karawin/Ka-Radio/ESP8266-Firmware/documents/karadiov365.jpg

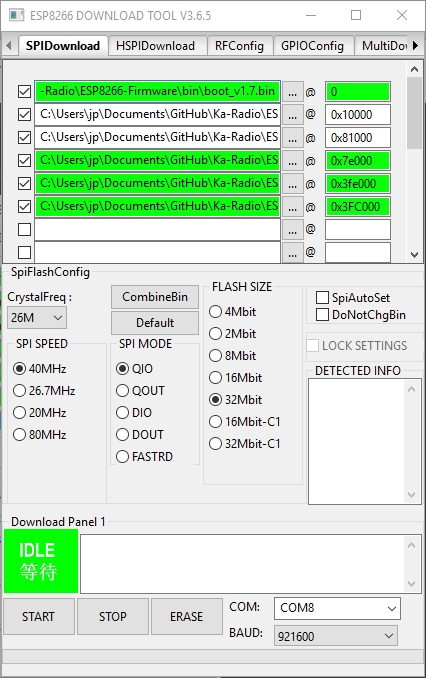
ESP8266-Firmware/documents/karadiov365.jpg
