karawin/Ka-Radio/ESP8266-Firmware/documents/screenshot_20161106_193554.png

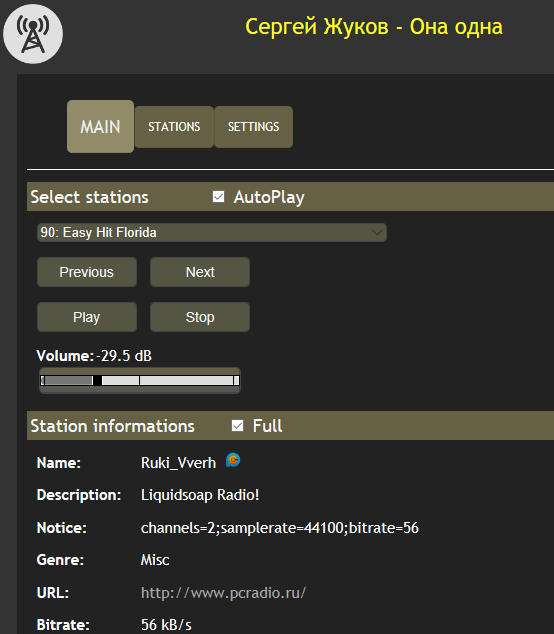
ESP8266-Firmware/documents/screenshot_20161106_193554.png
