karawin/Ka-Radio/(threads)

Thread 1 (2016-06-23):

auto resume

zajaklis, 2016-06-23:
At fist i wanted to thank you for you hard work and time spent on this project.

This not an issue, but more like feature request.
It would be nice that device on startup starts automatically playing radio station which was running before shutdown.
At fist i thought that its configurable on webui with "AutoPlay" checkbox, but it did not do anything.
What AutoPlay checkbox does?

karawin, 2016-06-23:
Hello,

Thanks,

Yes, the autoPlay is only after the first play button pressed. After
that, any other selection is launched automatically.
I forgot to launch the current station. I will work on it soon.

Regards

JP

Le 23/06/2016 à 07:44, zajaklis a écrit :
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

zajaklis, 2016-09-07:
hi again, did you implemented auto resume feature?
i have not notice that in changelog.

karawin, 2016-09-08:
Partially.
The problem is that the knowing is not in the esp but in the browser.
I have to add it on the esp eprom.... Soon.

Le 07/09/2016 à 21:22, zajaklis a écrit :
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

karawin, 2016-09-23:
autostart: test these bin....
I think it will works now.
thanks

Le 07/09/2016 à 21:22, zajaklis a écrit :
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

zajaklis, 2016-09-24:
which bins include autostart feature?

karawin, 2016-09-27:
Both.

Two bin, one for each bank.

Try just the 1.

Le 24/09/2016 à 15:19, zajaklis a écrit :
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

zajaklis, 2016-09-27:
took from http://karadio.karawin.fr/ and autoplay still not working after applying power.
Idea was to interact  with ka-radio without webui. At the moment after applying power im counting till 10 and pressing play button.

karawin, 2016-09-27:
Normal, it is not delivered, the bin was a preview .

Le 27/09/2016 à 17:21, zajaklis a écrit :
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

karawin, 2016-09-29:
The 1.0.9 is released and working ;-)

Le 27/09/2016 à 17:21, zajaklis a écrit :
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

zajaklis, 2016-10-01:
Great, just tested, all works!
Thank you

Closed 2016-07-29.

Thread 2 (2016-07-16):

cannot change IP

yo2ldk, 2016-07-16:
Hi,

  this is a very nice and well made it project, Thank you!
I do something wrong maybe, because when I try to put AP name, pswd , a new IP and gateway, this is not happening , it comes back on 192.168.4.1 and I have no connection to internet for ESP module.
on router I have ...1.1, try it also with original class ...8.1 and with ...0.1 , all the same.
I not have memory IC (until I get it),  but it work also without it, no? and when ESP have no power, I need to rewrite all settings in this case?
 sorry for all questions, but I am more on hardware and a beginner in codding .

karawin, 2016-07-16:
Hi

Firstly check if you have a 4Mb esp8266 (ie 32mbits)

Le 16/07/2016 à 06:55, alexander - yo2ldk a écrit :
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
May be a wrong AP or password?
Before all, make a "Clear stations" and after change the wifi setting:
No dhcp, an ip address in 192.168.1.x a mask of 255.255.255.0 and the ip
of your router.

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

Yes it works without the external ram.
Check for a 4MB esp8266 if the stations are not maintened, it may be the
problem.
If it is the wifi setting not maintened, it is because the internet AP
access is wrong.

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

yo2ldk, 2016-07-16:
Thank you for fast reply
 I try for 3 days already and no conclusion..
yes my esp board have 4Mb is wemos esp d1 mini, but I try also with NodeMcu v.3 the same thing
 firmware is well flashed ,router is ok, password all good but not connect
web interface it is and work ok, full level of wifi, connections is made it conf. pdf. file; i'm stuck...  :)

karawin, 2016-07-16:
Try the uart interface (documented in
\a-Radio\ESP8266-Firmware\documents\uartinterface.txt):

sys.erase
wifi.list
wifi.con("ssid","password")
wifi.status

Bye

JP

Le 16/07/2016 à 11:31, alexander - yo2ldk a écrit :
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

yo2ldk, 2016-07-16:
Merci beaucoup !

karawin, 2016-07-16:
Check also your power. It is very sensitive. A good external power
supply is needed.

Le 16/07/2016 à 11:31, alexander - yo2ldk a écrit :
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

yo2ldk, 2016-07-16:
I use power bank Xiaomi 16000 mA

karawin, 2016-07-16:
115200b/s ?
try http://www.compuphase.com/software_termite.htm
Press enter key, you must see
#INFO:""#

If not, the flash is not good.

yo2ldk, 2016-07-16:
sorry to bother you with my problem;
I use tera term, also realterm, now on termite when push enter nothing appear. all on 9600
testing also with 115200
web page look ok, I reflashing, last solutions here.

yo2ldk, 2016-07-16:
for sure i wrong somthing..
after reflashing two modules, with serial connection I have no response from any.  at all !
 I flash as follow:

boot_v1.5 at 0x00000
user1.4096.new.4.bin at 0x1000 ,
user2.4096.new.4.bin at 0X81000
blank.bin at 0x7e000
blank.bin at 0x3fe000

it is ok that?  because I don't know what to do more..

karawin, 2016-07-16:
The complete flash is
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

With what tool do you flash it?
Under windows or linux?
Do you have checked all wires? Try without the vs1053 in case of doubt.

karawin, 2016-07-29:
no news?

yo2ldk, 2016-07-29:
Jean-Pierre,
Thank you for all your help, especially latest, with photo !
 in the first time, I write firmware exactly like you except latest two file .
 Now i write all files, on four (4) different modules.
 on all when I try to access with terminal (5 different software) I get nothing or strange char.
not what should be.
I'm not so stupid, i load firmware in many and different equipment's but with that this is like I fell..
 so , I take a break, maybe in this weekend I made latest try, even if I need this Radio.
 my best regards,

                 alex.

karawin, 2016-07-29:
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

Closed 2016-07-29.

Thread 3 (2016-10-05):

Using an additional chip 23lcv1024 and external buttons?

lyovav, 2016-10-05:
Hello, what benefits provide the use of an additional chip 23lcv1024,
and whether there is support for external control buttons?
Thank you with best regards Vladimir.

karawin, 2016-10-05:
The additional chip increases the buffering of the played station in order to avoid silent gaps if the internet stream is not regular.  Recommended if you experiment too many gaps.

External controls: see https://github.com/karawin/Ka-Radio/blob/master/Hardware/KiCAD/controles/controles.pdf
The led is optional and must now be connected to GPIO2 instead of GPIO16.
Thanks for your interest.

Closed 2016-10-05.

Thread 4 (2016-10-06):

Bug selected stations  autoplay

lyovav, 2016-10-06:
Sometimes  when I chose the desired station, and I pressed the play - off the power and turned it back to station plays 1 second and stops playing

(off the power times with no web browser) testing on V1.0.9
```
=> extraram state: 0 0xff ▒▒▒▒▒▒▒▒▒▒▒▒▒▒▒▒
data  : 0x3ffe8000 ~ 0x3ffe88d4, len: 2260
rodata: 0x3ffe88e0 ~ 0x3ffea744, len: 7780
bss   : 0x3ffea748 ~ 0x3fff15b0, len: 28264
heap  : 0x3fff15b0 ~ 0x40000000, len: 59984
Heap size: 32200
t0 task: 3fff83e8
t1 task: 3fff8580
t4 task: 3fff89a8
t3 task: 3fff8fc8
t2 task: 3fff9cf0
mode : sta(5c:cf:7f:23:d6:53)
add if0
I2S Speed: 0
SCI_Mode (0x4800) = 0x802
SCI_Status (0x48) = 0x48
VS Version (VS1053 is 4) = 4
SCI_ClockF = 0x6000
UART READY TO READ
 Station Ip: 192.168.100.246
DHCP: 0x1
Device: Ip: 192.168.100.246

I: 0 status: 0

In I: 0 status: 1
scandone
state: 0 -> 2 (b0)
state: 2 -> 3 (0)

In I: 1 status: 1
state: 3 -> 5 (10)
add 0
aid 2
pm open phy_2,type:2 0 0
cnt

connected with 47501, channel 3
dhcp client start...
ip:192.168.100.246,mask:255.255.255.0,gw:192.168.100.1
autostart: playing:1, currentstation:2
I2S Speed: 0
##CLI.STOPPED#
##CLI.URLSET#: online-hitfm.tavrmedia.ua
##CLI.PATHSET#: /HitFM
##CLI.PORTSET#: 8000
##CLI.ICY0#: Hit FM
##CLI.ICY3#: http://www.hitfm.ua
##CLI.ICY4#: Only Hits!
##CLI.ICY5#: 128
##CLI.ICY6#: Only Hits!
##CLI.ICY7#:  ice-samplerate=44100;ice-bitrate=128;ice-channels=2
##CLI.PLAYING#
##CLI.STOPPED#

```
or

```
=> extraram state: 0 0xff ▒▒▒▒▒▒▒▒▒▒▒▒▒▒▒▒
data  : 0x3ffe8000 ~ 0x3ffe88d4, len: 2260
rodata: 0x3ffe88e0 ~ 0x3ffea744, len: 7780
bss   : 0x3ffea748 ~ 0x3fff15b0, len: 28264
heap  : 0x3fff15b0 ~ 0x40000000, len: 59984
Heap size: 32200
t0 task: 3fff83e8
t1 task: 3fff8580
t4 task: 3fff89a8
t3 task: 3fff8fc8
t2 task: 3fff9cf0
mode : sta(5c:cf:7f:23:d6:53)
add if0
I2S Speed: 0
SCI_Mode (0x4800) = 0x802
SCI_Status (0x48) = 0x48
VS Version (VS1053 is 4) = 4
SCI_ClockF = 0x6000
UART READY TO READ
 Station Ip: 192.168.100.246
DHCP: 0x1
Device: Ip: 192.168.100.246

I: 0 status: 0

In I: 0 status: 1
scandone
state: 0 -> 2 (b0)
state: 2 -> 3 (0)

In I: 1 status: 1
state: 3 -> 5 (10)
add 0
aid 2
pm open phy_2,type:2 0 0
cnt

connected with 47501, channel 3
dhcp client start...
ip:192.168.100.246,mask:255.255.255.0,gw:192.168.100.1
autostart: playing:1, currentstation:2
I2S Speed: 0
##CLI.STOPPED#
##CLI.URLSET#: online-hitfm.tavrmedia.ua
##CLI.PATHSET#: /HitFM
##CLI.PORTSET#: 8000
##CLI.ICY0#: Hit FM
##CLI.ICY3#: http://www.hitfm.ua
##CLI.ICY4#: Only Hits!
##CLI.ICY5#: 128
##CLI.ICY6#: Only Hits!
##CLI.ICY7#:  ice-samplerate=44100;ice-bitrate=128;ice-channels=2
##CLI.STOPPED#
```

In most cases operate normally Autoplay's

```
=> extraram state: 0 0xff ▒▒▒▒▒▒▒▒▒▒▒▒▒▒▒▒
data  : 0x3ffe8000 ~ 0x3ffe88d4, len: 2260
rodata: 0x3ffe88e0 ~ 0x3ffea744, len: 7780
bss   : 0x3ffea748 ~ 0x3fff15b0, len: 28264
heap  : 0x3fff15b0 ~ 0x40000000, len: 59984
Heap size: 32200
t0 task: 3fff83e8
t1 task: 3fff8580
t4 task: 3fff89a8
t3 task: 3fff8fc8
t2 task: 3fff9cf0
mode : sta(5c:cf:7f:23:d6:53)
add if0
I2S Speed: 0
SCI_Mode (0x4800) = 0x802
SCI_Status (0x48) = 0x48
VS Version (VS1053 is 4) = 4
SCI_ClockF = 0x6000
UART READY TO READ
 Station Ip: 192.168.100.246
DHCP: 0x1
Device: Ip: 192.168.100.246

I: 0 status: 0

In I: 0 status: 1
scandone
state: 0 -> 2 (b0)
state: 2 -> 3 (0)

In I: 1 status: 1
state: 3 -> 5 (10)
add 0
aid 2
pm open phy_2,type:2 0 0
cnt

connected with 47501, channel 3
dhcp client start...
ip:192.168.100.246,mask:255.255.255.0,gw:192.168.100.1
autostart: playing:1, currentstation:2
I2S Speed: 0
##CLI.STOPPED#
##CLI.URLSET#: online-hitfm.tavrmedia.ua
##CLI.PATHSET#: /HitFM
##CLI.PORTSET#: 8000
##CLI.ICY0#: Hit FM
##CLI.ICY3#: http://www.hitfm.ua
##CLI.ICY4#: Only Hits!
##CLI.ICY5#: 128
##CLI.ICY6#: Only Hits!
##CLI.ICY7#:  ice-samplerate=44100;ice-bitrate=128;ice-channels=2
##CLI.PLAYING#
##CLI.META#: Xiт FM - www.hitfm.ua

```
Thank you with best regards Vladimir.

karawin, 2016-10-06:
Interesting. I will investigate, thank you

Le 06/10/2016 à 18:37, lyovav a écrit :
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

lyovav, 2016-10-10:
```
=> extraram state: 0 0xff ▒▒▒▒▒▒▒▒▒▒▒▒▒▒▒▒
data  : 0x3ffe8000 ~ 0x3ffe88d4, len: 2260
rodata: 0x3ffe88e0 ~ 0x3ffea7c0, len: 7904
bss   : 0x3ffea7c0 ~ 0x3fff1620, len: 28256
heap  : 0x3fff1620 ~ 0x40000000, len: 59872
Heap size: 32088
t0 task: 3fff8458
t1 task: 3fff85f0
t4 task: 3fff8a18
t3 task: 3fff9038
t2 task: 3fff9d60
mode : sta(5c:cf:7f:23:d6:53)
add if0
I2S Speed: 0
SCI_Mode (0x4800) = 0x802
SCI_Status (0x48) = 0x48
VS Version (VS1053 is 4) = 4
SCI_ClockF = 0x6000
UART READY TO READ
 Station Ip: 192.168.100.247
DHCP: 0x1
Device: Ip: 192.168.100.247

I: 0 status: 0

In I: 0 status: 1
scandone
state: 0 -> 2 (b0)

In I: 1 status: 1
state: 2 -> 3 (0)
state: 3 -> 5 (10)
add 0
aid 1
pm open phy_2,type:2 0 0
cnt

connected with 47501, channel 3
dhcp client start...
ip:192.168.100.247,mask:255.255.255.0,gw:192.168.100.1
autostart: playing:1, currentstation:0
I2S Speed: 0
##CLI.STOPPED#
##CLI.URLSET#: ua.uar.net
##CLI.PATHSET#: /galychyna
##CLI.PORTSET#: 8000
##CLI.ICY0#: Galychyna FM
##CLI.ICY3#: http://www.galychyna.fm
##CLI.ICY4#: galychyna
##CLI.ICY5#: 256
##CLI.ICY6#: This is only a trial
##CLI.PLAYING#
##CLI.STOPPED#

```

The new release(V1.0.10) works autostart almost perfect but still with 10 power outages without the inclusion of one autostart(
I do not know what it's done...
Thank you very much for giving the new release.

Thank you with best regards Vladimir.

karawin, 2016-10-10:
I tried about 30 autostart with your station with success.
The only reason in the code is a time out on the data reception.
Could you test with another AP?

Le 10/10/2016 à 18:22, lyovav a écrit :
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

lyovav, 2016-10-11:
After reading your advice, I tested on another chip ESP8266 and repeat the same problem with autostart failed. Most likely the problem the chip ESP8266.
Thank you very much for your cooperation.
Best regards Vladimir.

karawin, 2016-10-11:
I don't think that it is a problem of ESP8266.
I said to try another network access point or better another internet
access.
Thanks to you too. Users are the best testers.

Le 11/10/2016 à 17:37, lyovav a écrit :
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

lyovav, 2016-10-11:
I have [https://routerboard.com/rb751u-2hnd] AP and 100Mb LAN Internet access [http://www.speedtest.net/my-result/5706090391] Therefore, I have no doubt in my AP Network.
the problem was resolved by replacing another chіp
[https://ru.aliexpress.com/item/New-Wireless-module-CH340-NodeMcu-V3-Lua-WIFI-Internet-of-Things-development-board-based-ESP8266-We/32565317233.html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]

Best regards Vladimir.

zajaklis, 2016-10-25:
problem was caused because of missing pulldown for analog input. otherwise keypad must be connected.

lyovav, 2016-10-25:
a minimum of parts and without control board
[prototype](https://1drv.ms/i/s!Aq_8ScOZC7u_l37tdNEGBa4C95LH)
works perfect...

karawin, 2016-10-25:
Great
Thanks for the feedback.
Enjoy.

Closed 2016-10-25.

Thread 5 (2016-10-17):

no connection to AP

acocalypso, 2016-10-17:
Im having a hard time to get a connection. Sometimes it will connect to my WLAN but most time, the blue led (nodemcu v3) blinks a few times and then nothing happens. After restarting the esp **many** times it will reconnect to my wlan.

karawin, 2016-10-17:
Hi,
This part is the espressif code.
Try to be closer of the AP?
Connect a terminal to see the log.

Le 17/10/2016 à 22:32, acocalypso a écrit :
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

v222008, 2016-10-18:
Hi. Developer fee (nodemcu v3)  is very demanding to the supply voltage, any voltage drop leads to restart or freezes chip.

karawin, 2016-10-18:
Hi v222008
Right, but i made 4 protos without problem. The advantage of the v3 is that the usb 5v is available on pin VU (3). In case of connection with an usb port too weak, you can use hub with external power
Or a low cost https://fr.aliexpress.com/item/Best-price-30pcs-lot-MB102-Solderless-Breadboard-Power-Supply-Module-3-3V-or-5V/32351807367.html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

acocalypso, 2016-10-18:
If its demanding to the suppy voltage, im going to test it again with a wallcharger.
Currently i was using my pc / notebook to power it on.
Ill let you know if this will solve my issue.

v222008, 2016-10-18:
Not the fact that USB cable or contacts in the micro yusb reliable. Try another USB cable or connect to a power supply of 5 volts.
But in the ideal case, connect the port to monitor and see the log...

karawin, 2016-11-10:
No news, i close it

Closed 2016-11-10.

Thread 6 (2016-10-20):

Suggestion - saved volume per station

QuitButton, 2016-10-20:
This is shaping up nicely to be a great internet radio, there's a couple of suggestions though I think would help, the main one being saving the volume (or more accurately, a volume offset) per station. Some of the stations are extremely quiet and some very loud, it would be nice to be able to change station without fear of having my ears blown out ;)

v222008, 2016-10-21:
Actual situation at the moment, who listens to the radio stations on headphones. Already several times found himself in such a situation. While alive and well)

arlaor, 2016-12-21:
Hi @karawin
I really like your project, because it allows me to update my old sound system.
I am waiting for the parties to be able to do it.
I do not know if you have already implemented it in your project, but considering the volume, it is possible to save custom equalizer parameters in a particular station ?, it happens the same as with volume, some handle too many bass sounds, other too many treble .

karawin, 2016-12-21:
Thanks.
This feature seems simple to implement, but wait:
- the list of stations  is saved in eprom. Not so easy to add another set of data,
- the list can be saved in a file of the pc:, so the mechanism must be modified (saving and restoring)
- this modification must be compatible with the initial format,
- It is ok for the volume with a delta / current volume, but for bass and treble and cutting frequency?
- and finally, I was operated of a cataract Monday and it is a pity to read my screen ;-)

May in one month or two if all is ok with new glasses ,-)
Thanks for your interrest.

arlaor, 2016-12-21:
Hi @karawin
The equalizer parameters would be stored in a list of equalization parameters and would be called when playing the station to which the custom equalization was assigned.
I do not know if this is possible

I hope your surgery improves healthily. Take care.
We need you with very good health

karawin, 2016-12-21:
It's good to be supported. To later when I would be in shape.
My hobby is to build the best webradio on esp8266.

arlaor, 2016-12-24:
Hi @karawin
I was reading the comments of the page of your project [hackaday](http://forum.xda-developers.com/galaxy-s4-mini/development/rom-cyanogenmod-14-0-s4-mini-duos-t3477343/page44) and I have given, that I have requested two modules wrong LOL. I should have purchased the VS1053 and purchased the VS1003. I do not know what I was thinking of. I had selected stations that broadcast in AAC format, but now I can not hear them.

karawin, 2017-01-10:
To answer to arlaor, yes, the vs1053 support aac audio.
The new 1.1.4 release has an offset volume per station and many more.
Hope you all like it.
Yes, only volume offset because of the limited space on eeprom.
I close this request.
If you have some other ideas, don't hesitate.
Enjoy.

Closed 2017-01-10.

Thread 9 (2016-11-21):

error after flashing

xCite1986, 2016-11-21:
i connect my nodeMCU 1.0 connected with VS1053 shown as in the instruction

after uploading the FW...

=> extraram state: 0 0xff ÿÿÿÿÿÿÿÿÿÿÿÿÿÿÿÿ
data  : 0x3ffe8000 ~ 0x3ffe88d4, len: 2260
rodata: 0x3ffe88e0 ~ 0x3ffea9a8, len: 8392
bss   : 0x3ffea9a8 ~ 0x3fff1850, len: 28328
heap  : 0x3fff1850 ~ 0x40000000, len: 59312
Heap size: 31528
t0 task: 3fff8688
t1 task: 3fff8820
t4 task: 3fff8c48
t3 task: 3fff9268
t2 task: 3fff9f90
mode : sta(5c:cf:7f:89:2b:92)
add if0

then it stops. anyone know whats wrong??

karawin, 2016-11-21:
If you have a terminal on uart and responding, try a
sys.erase
command.

xCite1986, 2016-11-21:
yes, only 2x short after pressing reset button.
nothoing happens by the command "sys.erase" with arduino seial monitor :(

karawin, 2016-11-21:
Try to flash a blank.bin file at 0x3E0000 and 0x3F0000
If it still doesn't work, I don't know what to do next, apart change the esp itself.

xCite1986, 2016-11-21:
thanks, i'm flashing the complete esp with
http://www.pratikpanda.com/completely-format-erase-esp8266-flash-memory/

now it blinks fast... but i could not find the AP "WifiWebRadio"

xCite1986, 2016-11-21:
first many thanks for your help and your fast reply!!

it was very curious...
after getting only hieroglyphs with my nodeMCU1.0 i get a "new" nodeMCU 0.9..

first flashing 0x000000, 0x100000, 0x200000 and 0x300000 with blank 1M-File,

and after uploading files from http://karadio.karawin.fr/ ...
http://www.youscreen.de/xiphpqysh66.jpg
...getting the same output:

sdlÜ<là<

 lä
#| ì sb cò'oß$g'ãä c
pìÇds$sdpò'à

d

  c oã| l lcÄò'oï$l`   gn
d`   osÛn
 ãì$` pûgà
sÄãà
 c oâ< ìÇbóogç
 l`   o' l`   o;Ç'
 d` 8ûgà
 rÜãàìd
 c
nã| $Ç{
#Äóngï
$`   go
d`   gsÛo
 ûd$`  rÛg
óll` {loû'oã{ no'Ä
d#{{$
ä lì Û


 lll rl ì ddd'ã

  lld l ä Ûlgà 'än?  ÄÄddà#
ädlp# #;äd`olÇxìl`cd` $Û'
gÛãnl| c
  l
 l  s$ s ì bÄã# $b#
`; Çx  #ìónî ogã    lò8
d  lld $ d`  güÙ
=> extraram state: 0 0xff ÿÿÿÿÿÿÿÿÿÿÿÿÿÿÿÿ
data  : 0x3ffe8000 ~ 0x3ffe88d4, len: 2260
rodata: 0x3ffe88e0 ~ 0x3ffea9a8, len: 8392
bss   : 0x3ffea9a8 ~ 0x3fff1850, len: 28328
heap  : 0x3fff1850 ~ 0x40000000, len: 59312
Heap size: 31528
t0 task: 3fff8688
t1 task: 3fff8820
t4 task: 3fff8c48
t3 task: 3fff9268
t2 task: 3fff9f90
mode : sta(5c:cf:7f:03:96:a5)
add if0

is there something wrong with my connection to VS1053-Board?

5V to 5V
5V to 5V
MISO - D6
SCK - D5
XRST - D3
XDCS - D1
XS - D8
DREQ - D2
MOSI - D7
DGND - GND

karawin, 2016-11-21:
Correct.
Dont forget to wire A0 to Gnd
And +5v to VU on nodeMcu, not to the Vin of the nodemcu.

Tho output is correct until add if0.
It seems that the spi bus is blocking.

Le 22/11/2016 à 00:13, Alex a écrit :
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
�
��lä
#|���ì��s�b��c�ò'oß$g'�ãä�c�pìÇds$sdpò'à���
�
d�
�
��c�oã|�l�l��cÄò'oï$��l|����gn
d|���os�Û�n
�ãì$|�pûgà���
sÄ��ãà��
�c�oâ<�ì��Çb�óogç
�l|����o'�l|���o;Ç��'�
��d|�8ûgà��
�r��Üãàìd
�c
nã|�$Ç{�
#Äóngï�
$|����go
d|���gs�Û�o
�ûd$|��r�Ûg�
óll|�{l��o��û'o���ã�{�no'Ä
d�#{{$
ä��lì�Û����

�
�
��lll�rl�ì��ddd'�ã�
�

���l�ld�l�ä�Ûl��gà��'ä�n?��ÄÄddà�#
ä�dlp#��#;��äd|olÇx�ìl|cd|�$�Û'�
�g�Ûãnl�|�c�
��l�
�l
> �s$�s�ì��bÄ�ã�#�$�b�#�|��;���Çx��#ìónî��ogã�����lò8�
d���l��ld���$���d`���gü��Ù
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

karawin, 2016-11-21:
Try to remove the vs153 board. It starts without it (but no sound obviously)

Le 22/11/2016 à 00:13, Alex a écrit :
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
�
��lä
#|���ì��s�b��c�ò'oß$g'�ãä�c�pìÇds$sdpò'à���
�
d�
�
��c�oã|�l�l��cÄò'oï$��l|����gn
d|���os�Û�n
�ãì$|�pûgà���
sÄ��ãà��
�c�oâ<�ì��Çb�óogç
�l|����o'�l|���o;Ç��'�
��d|�8ûgà��
�r��Üãàìd
�c
nã|�$Ç{�
#Äóngï�
$|����go
d|���gs�Û�o
�ûd$|��r�Ûg�
óll|�{l��o��û'o���ã�{�no'Ä
d�#{{$
ä��lì�Û����

�
�
��lll�rl�ì��ddd'�ã�
�

���l�ld�l�ä�Ûl��gà��'ä�n?��ÄÄddà�#
ä�dlp#��#;��äd|olÇx�ìl|cd|�$�Û'�
�g�Ûãnl�|�c�
��l�
�l
> �s$�s�ì��bÄ�ã�#�$�b�#�|��;���Çx��#ìónî��ogã�����lò8�
d���l��ld���$���d`���gü��Ù
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

v222008, 2016-11-22:
Take advantage of all the functionality of the project is possible without connecting vs153 board like connect to AP, browsing web pages, make a settings  of project...
May be you wrong ESP8266 flashing...

xCite1986, 2016-11-22:
@karawin okay, i will try it at home in evening
@v222008 thanks for your reply. I've connect the node with micro-usb cable and flash with following settings:

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

lyovav, 2016-11-22:
And how looks  the module nodeMCU 1.0  that you flashing?

xCite1986, 2016-11-22:
okay, looks good with disconnected VS1053-Board

 ```
=> extraram state: 0 0xff ÿÿÿÿÿÿÿÿÿÿÿÿÿÿÿÿ
data  : 0x3ffe8000 ~ 0x3ffe88d4, len: 2260
rodata: 0x3ffe88e0 ~ 0x3ffea9a8, len: 8392
bss   : 0x3ffea9a8 ~ 0x3fff1850, len: 28328
heap  : 0x3fff1850 ~ 0x40000000, len: 59312
Heap size: 31528
t0 task: 3fff8688
t1 task: 3fff8820
t4 task: 3fff8c48
t3 task: 3fff9268
t2 task: 3fff9f90
mode : sta(5c:cf:7f:89:2b:92)
add if0
I2S Speed: 0
SCI_Mode (0x4800) = 0xFFFF
SCI_Status (0x48) = 0xFFFF
VS Version (VS1053 is 4) = 15
SCI_ClockF = 0xFFFF
UART READY TO READ
first use
 Station Ip: 192.168.1.254
DHCP: 0x1
Device: Ip: 192.168.1.254

I: 0 status: 0
In I: 0 status: 0
In I: 1 status: 0
In I: 2 status: 0
In I: 3 status: 0
In I: 4 status: 0
In I: 5 status: 0
In I: 6 status: 0
In I: 7 status: 0
In I: 8 status: 0
In I: 9 status: 0
In I: 10 status: 0
In I: 11 status: 0
In I: 12 status: 0
In I: 13 status: 0
In I: 14 status: 0

Config not found

The default AP is  WifiWebRadio. Connect your wifi to it.
Then connect a webbrowser to 192.168.4.1 and go to Setting
Erase the database and set ssid, password and ip's field
del if0
usl
sul 0 0
mode : softAP(5e:cf:7f:89:2b:92)
dhcp server start:(ip:192.168.4.1,mask:255.255.255.0,gw:192.168.4.1)
add if1
bcn 100
autostart: playing:255, currentstation:65535
I2S Speed: 0
```

xCite1986, 2016-11-22:
so, if i connect DREQ to D2 it stops with ```add if0 ```...

karawin, 2016-11-22:
So check your dreq wire
(and all other)

karawin, 2016-11-22:
Shorted to the ground....? or 5v or gnd not connected?

xCite1986, 2016-11-22:
yes, everything connected fine.

I check all connections with your soldered pcb from [here ](http://www.instructables.com/file/FB0VT4VITA8WJ66/)...
, replace every wire, measure 5V and gnd if the VS gets power.. i dont know.. i'm clueless now.. maybe i've got a crappy VS-board...

but hey - i took a short look in your website and it was the
most impressive program i've seen on an ESP8266... ;-)

karawin, 2016-11-22:
Measure the voltage between gnd and dreq. It must be 3.3 v
Check if the 5 volt is on the vs1053.
Without power, check for short circuit between all pins, etc

Thanks, yes it is a bit complex, due to the lack of ram, I digged hard to find some tricks ;-)

xCite1986, 2016-11-22:
no, there was 0V between DGND/G and DREQ/D2 :(
5V on the VS was good

karawin, 2016-11-22:
Power on the vs1053 alone and check dreq.
While removed, check the board connectors of the vs for shorted pins
Check check check

Le 23/11/2016 à 00:07, Alex a écrit :
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

Closed 2016-12-03.

Thread 10 (2016-12-03):

Suggestion: Enable signal for amplifier

HcDevel, 2016-12-03:
Hello,

I succesfully flashed Ka-Radio and attached it to a Class-D amplifier module to replace my current amplifier. Now I would like to turn off the amplifier when playback stopped to save energy. Using a relais or transistor shouldn't be a problem, but I need a signal which I can use to switch the transistor. The signal needs to be high while playing and low while not playing.
Is there already a pin configured I could use for this?

karawin, 2016-12-03:
No problem, it is easy to add it but in the pro mini arduino lcd software only because of the lack of gpio on the esp8266.
Even if you don't have a lcd connected, it is easy to add an output on the pro mini for that purpose.
I will add it in the karadioU8Glib software v1.3 soon.

Closed 2016-12-03.

Thread 12 (2017-01-16):

'unsigned int index' redeclared as different kind of symbol

arlaor, 2017-01-16:
Hi @karawin
When trying to load Karadiolcd16x2.ino, to my module ESP-12E, I am receiving the following message, which will not allow me to continue:
```javascript
karadioNokia5110:41: error: 'unsigned int index' redeclared as different kind of symbol

 unsigned index = 0;

          ^

In file included from c:\users\oz\appdata\local\arduino15\packages\esp8266\tools\xtensa-lx106-elf-gcc\1.20.0-26-gb404fb9-2\xtensa-lx106-elf\include\stdlib.h:11:0,

                 from C:\Users\oZ\AppData\Local\Arduino15\packages\esp8266\hardware\esp8266\2.3.0\cores\esp8266/Arduino.h:27,

                 from C:\Users\oZ\AppData\Local\Temp\arduino_build_598767\sketch\karadioNokia5110.ino.cpp:1:

c:\users\oz\appdata\local\arduino15\packages\esp8266\tools\xtensa-lx106-elf-gcc\1.20.0-26-gb404fb9-2\xtensa-lx106-elf\include\string.h:55:8: error: previous declaration of 'char* index(const char*, int)'

 char  *_EXFUN(index,(const char *, int));

        ^

D:\ARDUINO\NODEMCU\mp3 sketch\KaRadio\Firmware\Ka-Radio-master\Lcd & remote\karadioNokia5110\karadioNokia5110.ino: In function 'void loop()':

karadioNokia5110:317: error: invalid types 'char [200][char*(const char*, int)]' for array subscript

             line[index] = 0; // end of string

                       ^

karadioNokia5110:318: error: assignment of function 'char* index(const char*, int)'

             index = 0;

                   ^

karadioNokia5110:318: error: cannot convert 'int' to 'char*(const char*, int)' in assignment

karadioNokia5110:35: error: ISO C++ forbids comparison between pointer and integer [-fpermissive]

 #define BUFLEN  200

                 ^

D:\ARDUINO\NODEMCU\mp3 sketch\KaRadio\Firmware\Ka-Radio-master\Lcd & remote\karadioNokia5110\karadioNokia5110.ino:322:23: note: in expansion of macro 'BUFLEN'

             if (index>BUFLEN) break; // small memory so small buffer

                       ^

karadioNokia5110:323: error: ISO C++ forbids incrementing a pointer of type 'char* (*)(const char*, int)' [-fpermissive]

             line[index++] = temp;

                       ^

karadioNokia5110:323: error: lvalue required as increment operand

Usando librería EEPROM con versión 1.0 en la carpeta: C:\Users\oZ\AppData\Local\Arduino15\packages\esp8266\hardware\esp8266\2.3.0\libraries\EEPROM
exit status 1
'unsigned int index' redeclared as different kind of symbol
```
What modification should I make to your sketch in order to use it?

What is the sketch that allows me to handle it only from a web page, without using an LCD screen?

karawin, 2017-01-16:
Karadio is not an arduino IDE software.
Please download http://www.espressif.com/sites/default/files/tools/flash_download_tools_v3.3.4_win.zip
It is the tool needed to flash the esp8266.
In the directory ESP8266-Firmware/bin you will find the files to be flashed.
See
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
To wire your prototype and
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
to configure the flasher.

The ino sketch you found is for the external arduino pro mini to add a lcd and IR.
Hope this help.

arlaor, 2017-01-16:
Hi @karawin
Initially use the tools you have published, but after updating it does not appear by any side some network generated by my module to connect to this or some connection request to connect it to my Wifi.

So, if you do not find an event like the ones mentioned above, try to enter the sketch published on your page karadiolcd16x2.ino

karawin, 2017-01-16:
Try again, many many other have succeded. It was blinking?
On your pc the wifi must be detected id it is blinking.

Le 16/01/2017 à 21:17, Arturo a écrit :
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

Closed 2017-01-16.

Thread 13 (2017-01-21):

Flashing does not work

Testi89, 2017-01-21:
Hello,
if have downloaded the files from hackaday and flashed like this:
"To upgrade to this release, please flash user1.4096.new.4.bin at 0x1000 ,
user2.4096.new.4.bin at 0X81000 and blank.bin at 0x7e000 & 0x3fe000"
and also boot.1.6.bin to 0x0000

but I do not get a connection. Something is wrong with flashing.

Can you please check and update the flashing guidelines?

Thanks a lot!

karawin, 2017-01-21:
These instructions are for an upgrade.
For a first flash see
https://hackaday.io/project/11570-wifi-webradio-with-esp8266-and-vs1053
or  https://cdn.hackaday.io/images/8829451470433125187.png

Testi89, 2017-01-22:
Hello Jean-Pierre,

merci pour le support.

I flashed again and now I get this result:
=> extraram state: 1 0x30 0123456789ABCDEF
data  : 0x3ffe8000 ~ 0x3ffe88d4, len: 2260
rodata: 0x3ffe88e0 ~ 0x3ffea9f8, len: 8472
bss   : 0x3ffea9f8 ~ 0x3fff18a8, len: 28336
heap  : 0x3fff18a8 ~ 0x40000000, len: 59224
Heap size: 44408
t0 task: 3fff5438
t1 task: 3fff55d0
t4 task: 3fff59f8
t3 task: 3fff6018
t2 task: 3fff6d68
mode : sta(a0:20:a6:0b:e7:05)
add if0

I cannot see any new WiFi spot to log into.

karawin, 2017-01-22:
Nothing else in log?
try a sys.erase
and reboot

Testi89, 2017-01-22:
I have downloaded the 6 files from the hackaday page and erased the chip:

$ esptool.py erase_flash
esptool.py v1.3-dev
Connecting...
Running Cesanta flasher stub...
Erasing flash (this may take a while)...
Erase took 10.3 seconds

Then I run flashing:

$ esptool.py write_flash 0x000 boot_v1.6.bin 0x01000 user1.4096.new.4.bin 0x81000 user2.4096.new.4.bin 0x7e000 blank.bin 0x3fe000 blank.bin 0xfc000 esp_init_data_default.bin 0x3fc000 esp_init_data_default.bin
esptool.py v1.3-dev
Connecting...
Auto-detected Flash size: 32m
Running Cesanta flasher stub...
Flash params set to 0x0040
Writing 4096 @ 0x0... 4096 (100 %)
Wrote 4096 bytes at 0x0 in 0.4 seconds (89.4 kbit/s)...
Writing 380928 @ 0x1000... 380928 (100 %)
Wrote 380928 bytes at 0x1000 in 33.0 seconds (92.3 kbit/s)...
Writing 380928 @ 0x81000... 380928 (100 %)
Wrote 380928 bytes at 0x81000 in 33.0 seconds (92.3 kbit/s)...
Writing 4096 @ 0x7e000... 4096 (100 %)
Wrote 4096 bytes at 0x7e000 in 0.4 seconds (89.6 kbit/s)...
Writing 4096 @ 0x3fe000... 4096 (100 %)
Wrote 4096 bytes at 0x3fe000 in 0.4 seconds (89.7 kbit/s)...
Writing 4096 @ 0xfc000... 4096 (100 %)
Wrote 4096 bytes at 0xfc000 in 0.4 seconds (89.7 kbit/s)...
Writing 4096 @ 0x3fc000... 4096 (100 %)
Wrote 4096 bytes at 0x3fc000 in 0.4 seconds (89.7 kbit/s)...
Leaving...

Output is:
=> extraram state: 1 0x30 0123456789ABCDEF
data  : 0x3ffe8000 ~ 0x3ffe88d4, len: 2260
rodata: 0x3ffe88e0 ~ 0x3ffea9f8, len: 8472
bss   : 0x3ffea9f8 ~ 0x3fff18a8, len: 28336
heap  : 0x3fff18a8 ~ 0x40000000, len: 59224
Heap size: 44408
t0 task: 3fff5438
t1 task: 3fff55d0
t4 task: 3fff59f8
t3 task: 3fff6018
t2 task: 3fff6d68
mode : sta(a0:20:a6:0b:e7:05)
add if0

Maybe the downladed files are not fully correct?

Testi89, 2017-01-22:
After serveral resets I got this output and can connect to the 192.168.1.4:
=> extraram state: 1 0x30 0123456789ABCDEF
data  : 0x3ffe8000 ~ 0x3ffe88d4, len: 2260
rodata: 0x3ffe88e0 ~ 0x3ffea9f8, len: 8472
bss   : 0x3ffea9f8 ~ 0x3fff18a8, len: 28336
heap  : 0x3fff18a8 ~ 0x40000000, len: 59224
Heap size: 44408
t0 task: 3fff5438
t1 task: 3fff55d0
t4 task: 3fff59f8
t3 task: 3fff6018
t2 task: 3fff6d68
mode : sta(a0:20:a6:0b:e7:05)
add if0
SCI_Mode (0x4800) = 0x4802
SCI_Status (0x48) = 0x48
VS Version (VS1053 is 4) = 4
SCI_ClockF = 0x6000
I2S Speed: 0
UART READY TO READ
first use
 Station Ip: 192.168.1.254
DHCP: 0x1
Device: Ip: 192.168.1.254

I: 0 status: 0
In I: 0 status: 0
In I: 1 status: 0
In I: 2 status: 0
In I: 3 status: 0
In I: 4 status: 0
In I: 5 status: 0
In I: 6 status: 0
In I: 7 status: 0
In I: 8 status: 0
In I: 9 status: 0
In I: 10 status: 0
In I: 11 status: 0
In I: 12 status: 0
In I: 13 status: 0
In I: 14 status: 0

Config not found

The default AP is  WifiWebRadio. Connect your wifi to it.
Then connect a webbrowser to 192.168.4.1 and go to Setting
Erase the database and set ssid, password and ip's field
del if0
usl
mode : softAP(a2:20:a6:0b:e7:05)
dhcp server start:(ip:192.168.4.1,mask:255.255.255.0,gw:192.168.4.1)
add if1
bcn 100
autostart: playing:255, currentstation:65535
I2S Speed: 0
add 1
aid 1
station: 1c:91:48:9e:71:e0 join, AID = 1

Thanks a lot.

karawin, 2017-01-22:
It seems that it is not the last release.
Now do an OTA upgrade in the setting panel.
Great.

Testi89, 2017-01-22:
Now I can hear music. Great!
Thanks a lot for this great software and keep up the superior work!

zigithu, 2017-06-04:
I have had same troubles with flashing esp12e.
Karadio has started to work when i have changed SPI mode from QIO to DIO before flashing (despite of window "detected info" says that my ESP has flash with QUAD)
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

karawin, 2017-06-04:
Is it a ai_thinker or a clone?

zigithu, 2017-06-06:
i have bought it here: https://ru.aliexpress.com/item/ESP8266-CH340G-CH340-G-NodeMcu-V3-Lua-Wireless-WIFI-Module-Connector-Development-Board-Based-ESP-12E/32800966224.html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

doctormord, 2017-07-14:
I'm having the same issues. The latest 1.3.4 code wont boot on a Wemos D1 Mini or NodeMCU. I tried flashing under Windows and Ubuntu. After Reset i onle get garbage in the console. Same on both boards. Anything i missed? Flash is set up as 32Mbit QIO, but even DIO wont do. (With and without VS1053 connected)

pmr446dx, 2017-09-11:
The only ESP Download tool version currently available for download on Espressif website is version 3.4. This looks quite different from 2.3 presented in the instructions. Was anyone able to flash using v 3.4?
Thanks

karawin, 2017-09-11:
3.3.4 3.4.4 any tools are good to flash.

pmr446dx, 2017-10-21:
Thank you Jean-Pierre.
I was able to flash using the latest versionof the ESP Download tool
I flashed on a "Wemos D1 mini Pro" with 16 MB  of RAM (schematics [here](https://wiki.wemos.cc/products:d1:d1_mini_pro)).
The software boots correctly and initialises as an access point, I am able to browse to 192.168.4.1 and set up the SSID and password of my AP, but the radio does not save the settings after restart.
Do you know if there is any chance to make Ka-Radio work on this 16MB board?

karawin, 2017-10-21:
Oups, i forgot to update the repo.
Try now with the new bin.
Or download they on
http://karadio.karawin.fr/user1.4096.new.4.bin
http://karadio.karawin.fr/user2.4096.new.4.bin

I think it will works now

pmr446dx, 2017-10-22:
You are right, it worked perfectly with the new bin files.
This is very strange to me, because this happens since the first time I tried, 11 September.
I cannot believe that no one else noticed it on the forums or facebook page. :)
Maybe they had the software already deployed and only used OTA upgrade.
Thank you! I also got esp32 karadio working on 1st try, version 0.3. I will upload some pictures of my projects as soon as they are finished :)
Best Regards.
Florin

karawin, 2017-10-22:
You are not the first one but the second one.
In fact, i made the correction in beginning of september and forgot to update github.
Happy it works
Bye

ps try the update to 0.4 on KaRadio32. Very stable.

arlaor, 2018-01-17:
Hi @karawin
Excuse me
I saw that they talked about a wemos
To use the project in a wemos mini pro, should some parameters of the flash download tool be changed? when using it with the parameters of the image it generates an error with strange symbols and fast flashing of the led.
I used the bin files 1.6.3

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

arlaor, 2018-01-18:
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

karawin, 2018-01-18:
arlaor, send the log of the uart on boot please.

arlaor, 2018-01-19:
Hi @karawin
atach the image arduino info
It has not allowed me to copy the text generated in the IDE
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

other observation: In DETECTED INFO, QUAD;128MB
this is normal?
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

karawin, 2018-01-19:
The detected info is normal.
Correct.
Just for esp_init_data_default.bin, remove the 0xFC000 and replace to 0x3FC000
Check the files length.
Cannot tell you other things.

arlaor, 2018-01-20:
Hi @karawin

I have seen that the new version of the download tool V3.6.2.2 needs a line of address and is left out 0x3FC000.
This work
Thank you.

Closed 2017-01-21.

Thread 14 (2017-01-22):

Autostart does not work after reset

Testi89, 2017-01-22:
The checkbox "autostart" is enabled, but after a reset the last played stream is not started.
Is this a bug or a feature?
I mean it would be great to hear the last station when powering on the radio.

Testi89, 2017-01-22:
tested with 1.1.5 (OTA upgrade)

Testi89, 2017-01-22:
Sorry, after 2 resets it works.

Closed 2017-01-22.

Thread 15 (2017-01-31):

Connections unclear

Testi89, 2017-01-31:
Hello,
can you please check the documentation for the connections? I think in the PDF from Piotr Sperka there are other connections that with you readme.md file. Also the RAM is not mentioned in the readme connections.
Thanks a lot.

karawin, 2017-01-31:
Yes, i will try.
It is a lot of work to do a document and the software and answer to all
questions.
regards

Le 31/01/2017 à 14:21, Testi89 a écrit :
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

---
L'absence de virus dans ce courrier électronique a été vérifiée par le logiciel antivirus Avast.
https://www.avast.com/antivirus

Testi89, 2017-02-13:
Can you please check if the 28800 baud for LCD is correct (see code and documents)? From ESP8266 I get readable output at 115200 baud.
Merci!

karawin, 2017-02-13:
On the uart interface type
sys.uart("28800")
to change the speed of the interface.

Le 13/02/2017 à 15:53, Testi89 a écrit :
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

---
L'absence de virus dans ce courrier électronique a été vérifiée par le logiciel antivirus Avast.
https://www.avast.com/antivirus

arlaor, 2017-03-06:
Hi Karawin. One Question. ¿Using a wemos mini PRO module, 16MB flash improves reception of stations with 192kbps or 320kbps? Or is it the same as using an ESP-12E module ?, I have problems cutting the signal with stations of these bitrates

karawin, 2017-03-07:
Hi

The same.
Some 320kbps doesn't work, some works. Cannot find why.
192 works in all case with esp12E

Le 06/03/2017 à 18:06, Arturo a écrit :
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

NonaSuomy, 2017-04-09:
I did some fritzing breadboard/schematics
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

arlaor, 2017-04-20:
Hello @karawin , I found [this](https://www.aliexpress.com/item/NodeMCU-V3-Lua-WIFI-module-integration-of-ESP8266-extra-memory-32M-flash-USB-serial-CH340G/32791599265.html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) module, which says to have 32MB of memory. When using this module, can this improve the operation of the project?

karawin, 2017-04-20:
32Mbits equal 4Mbytes. Karadio is generated for that.
Using a 16MB may be a problem for ota update. I use only 32MB esp12e, bare one or in a nodeMCU pcb.

arlaor, 2017-04-20:
I understand, then it's just a game of numerical values.
There is nothing left but to expect that there is enough support for the ESP32

NonaSuomy, 2017-05-04:
Does freeRTOS just have too much overhead? The Arduino project seems to stream smoothly with no ext ram [ESP-Radio](https://github.com/Edzelf/Esp-radio) just a ring buffer up to 320kbps@180mhz / 256kbps@80mhz

karawin, 2017-05-04:
Karadio does not need extra ram to run.
It just serves to improve the reception problems of the html stream.
Freertos is much better than a simple loop.

Le 04/05/2017 à 07:47, NonaSuomy a écrit :
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

Closed 2017-05-24.

Thread 16 (2017-02-10):

Fail list Station

arlaor, 2017-02-10:
Hi @karawin
I am trying to load this [List](https://gist.github.com/arlaor/cf9a045099a008104cb3d368cddaedc6) of stations, but after having several restarts of the module, the list appears in the web page of the project.
When playing the stations, 50% of them work and the other 50% do not.
When I press "Refresh locale list" on the STATIONS website, 50% randomly disappears, which are the ones that can not be played when they appear in the drop-down list.
I'm using version 1.1.7
The same thing happened in previous versions

karawin, 2017-02-10:
Yes, the correction was not well done.
Update again please and let me know.
Thanks

Le 10/02/2017 à 17:03, Arturo a écrit :
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

---
L'absence de virus dans ce courrier électronique a été vérifiée par le logiciel antivirus Avast.
https://www.avast.com/antivirus

arlaor, 2017-02-10:
I just updated now and the error persists

karawin, 2017-02-10:
May be a cache pb. V1.1.7+ must be on top of the web page.

arlaor, 2017-02-10:
Now I see 1.1.7+
Now only I lose the last station in the list and the volume preset in some stations, is formatted. This volume has also been saved in the txt file. All preset volumes are converted to zero

karawin, 2017-02-10:
test

Not correct?
For the last station, yes, it is better to keep all empty stations in
the list to erase existing ones. They are loaded Two by two, and i
assume that the list is as when saved.

Le 10/02/2017 à 17:57, Arturo a écrit :
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

---
L'absence de virus dans ce courrier électronique a été vérifiée par le logiciel antivirus Avast.
https://www.avast.com/antivirus

karawin, 2017-02-10:
[http://karadio.karawin.fr/karadio/images/screenshot_20170210_180113.png](http://karadio.karawin.fr//karadio/images/screenshot_20170210_180113.png)

arlaor, 2017-02-10:
Is strange, in my list disappears the volume saved.
No radio station is deleted anymore

karawin, 2017-02-10:
Check your txt file?

Le 10/02/2017 à 18:47, Arturo a écrit :
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

---
L'absence de virus dans ce courrier électronique a été vérifiée par le logiciel antivirus Avast.
https://www.avast.com/antivirus

arlaor, 2017-02-10:
I have tried reloading the WebStations.txt file generated by the web page from the "Save Stations from WebRadio" button, which saves all the volume parameters that are observed the first time I upload my txt file, but when I do " Refresh locale list (i)" disappear

karawin, 2017-02-10:
Congrat, you have found a bug. I missed to add the volume offset in the refresh list.
I will correct and let you know.

karawin, 2017-02-10:
Ok now.
Don't forget to refresh the page in the browser.
Thanks.

arlaor, 2017-02-10:
I get it.
I'm trying to play these stations but I can not play them
http://streams.deltaradio.de/delta-alternative/mp3-128/
http://streams.deltaradio.de/delta-foehnfrisur/mp3-128/
http://streams.deltaradio.de/delta-indie/mp3-128/
http://streams.deltaradio.de/delta-unplugged/mp3-128/
http://streams.deltaradio.de/delta-poprock/mp3-128/
http://streams.deltaradio.de/delta-sommer/mp3-128/

These others are from the same radio station and work normally:
http://streams.deltaradio.de/delta-live/mp3-128/
http://streams.deltaradio.de/delta-grunge/mp3-128/
http://streams.deltaradio.de/100/mp3-128/
http://streams.deltaradio.de/101/mp3-128/

arlaor, 2017-02-10:
The list of radio stations now works correctly. The volume saved in the list is not cleared

karawin, 2017-02-10:
"I'm trying to play these stations but I can not play them"
Yes the redirection is very long. I increased the buffer. Now they works.
Thanks again.

arlaor, 2017-02-10:
Thanks to you for this excellent job

karawin, 2017-02-10:
Can i link your playlist on the Setting panel?

Le 10/02/2017 à 22:11, Arturo a écrit :
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

---
L'absence de virus dans ce courrier électronique a été vérifiée par le logiciel antivirus Avast.
https://www.avast.com/antivirus

arlaor, 2017-02-10:
Of course, but there is a problem, the stations that belong to:
Radiotunes.com, Di.fm and rockradio.com are payable and the link expires in approximately one month. The other stations have no expiration problem.

karawin, 2017-02-10:
Ok, I will make a note to explain it.
I close the issue.

arlaor, 2017-02-10:
If you want I can filter the payment stations and leave those that will have normal functionality

karawin, 2017-02-10:
great, thanks

arlaor, 2017-02-10:
Here is the [link](https://gist.github.com/arlaor/cf9a045099a008104cb3d368cddaedc6)

karawin, 2017-02-10:
Updated, thanks

Closed 2017-02-10.

Thread 19 (2017-02-17):

Button control

tomasf71, 2017-02-17:
I tried to use button control via ADC input. I follow your schematic (resistive divider 1k, 1k, ..., 16k)
but some buttons doesn't work. Next station, Start button.  What is ADC thresholds for individual buttons. I am going to try measure voltage on ADC input.

Testi89, 2017-02-17:
Which voltage do you use?

karawin, 2017-02-17:
The feature:
*What is the range of the NodeMCU ADC input?*
Measured range: 0 - Vdd. (About 3.1 V in this case)
Number of bits: 10 bit (Codes: 0-1024)

Note that the NodeMCU board has a voltage divider on the ADC input. The
ESP8266 module it self has 0 - 1.0 V input range.

Readings are done with the command: print(adc.read(0))
0.5 V => 167
1.0 V => 330
1.5 V => 498
2.0 V => 666
2.5 V => 828
3.0 V => 995
3.1 V => 1024 (saturated)

The karadio software check if the reference is 3.1 or 1.0 v automatically.
     if (system_adc_read() < 10) adcdiv = 0; // no panel adc grounded
     else
     // read adc to see if it is a nodemcu with adc dividor
         if (system_adc_read() < 400) adcdiv = 3;
             else adcdiv = 1;

The code for buttons:
void switchCommand() {
     int adc;
     char Vol[22];
     if (adcdiv == 0) return; // no panel

         adc = system_adc_read();
         adc *= adcdiv;
//        if (adc < 930)
//            printf("adc: %d  div: %d\n",adc,adcdiv);
//        if (adc >940) vTaskDelay(10);
         if (inside&&(adc > 930)) inside = false;

         if ((adc >400) && (adc < 580)) // volume +
         {
             setVolumePlus();
         }
         else if ((adc >730) && (adc < 830)) // volume -
         {
             setVolumeMinus();
         }
         if (!inside)
         {
             if (adc < 220) // stop
             {
                 inside = true;
                 clientDisconnect("Adc Stop");
             }
             else if ((adc >278) && (adc < 380)) //start
             {
                 inside = true;
                 sprintf(Vol,"%d",currentStation);
                 playStation    (Vol);
             }
             else if ((adc >830) && (adc < 920)) // station+
             {
                 inside = true;
                 wsStationNext();
             }
             else if ((adc >590) && (adc < 710)) // station-
             {
                 inside = true;
                 wsStationPrev();
             }
         }
}

May be the 16k needs to be adjusted to have 1.0 v when no button are
pressed.

Le 17/02/2017 à 15:15, tomasf71 a écrit :
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

tomasf71, 2017-02-17:
Thank you. I use 3.3VT. I am going to try adjust R (16k) to have 1V on ADC input when no button pressed.

zajaklis, 2017-02-18:
i had same problem before i add additional 1k to 16k resistor. otherwise there was small offset for some buttons. now all ok.

tomasf71, 2017-02-18:
I did some simple test. To read voltage and RAW data on A0. Here is the result:
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

So, if no button pressed, there is 0,87V. It is what I supposed:  (3.3V / (16k+6k))*6k = 0,9 V

tomasf71, 2017-02-18:
So, it looks to add 2k resistor in series with 16k should do the job.

karawin, 2017-02-18:
No
(3.3V / (16k+7k))*7k = 1.00434783V

Le 18/02/2017 à 16:16, tomasf71 a écrit :
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

---
L'absence de virus dans ce courrier électronique a été vérifiée par le logiciel antivirus Avast.
https://www.avast.com/antivirus

karawin, 2017-02-18:
Le 18/02/2017 à 16:53, tomasf71 a écrit :
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

---
L'absence de virus dans ce courrier électronique a été vérifiée par le logiciel antivirus Avast.
https://www.avast.com/antivirus

tomasf71, 2017-02-19:
You are right :-)

Closed 2017-02-19.

Thread 21 (2017-03-13):

Add PWM_HACK for testing from ESP8266_MP3_DECODER

NonaSuomy, 2017-03-13:
Hi can you please add this option, for people that just want to test it out before they commit to buying an i2s dac.

Thank you.

karawin, 2017-03-15:
No i don't implement it. Bad quality in mono mp3 and I don't want to waste the precious ram.
To test the software, just avoid the vs1053.
The software run without it, but no sound obviously.
Thanks

NonaSuomy, 2017-03-17:
You won't waste any precious ram what so ever to have that option available, you would just do something like this;

At the top of the source file. Where you have some of your variable options, surround it with a preprocessor directive:

```
//#define PWMHACK
// ...More code...
#ifdef PWMHACK
  // "Debug PWMHACK enabled..."
  // More code etc...
#endif
```

at compile time none of this code will be included unless you uncomment //#define PWMHACK => #define PWMHACK . I can't test through the current interface because I want to stream custom audio samples to the device which will be text to speech voice prompts from a home automation system.

karawin, 2017-03-17:
I tested a text to speech with http://www.voicerss.org/ with success.
Sorry but the software investment is to heavy for an under 10$ hardware replacement.
But the code is freely available go on!
I see that you have some knowing in programming ;-)
I am just a software engineer since 1980.

NonaSuomy, 2017-03-19:
What did you do for the test of voicerss.org?

I thought you said someplace that you based this on esp8266_mp3_encoder so I didn't know that you changed it much from their implementation, thought it would just be a pull of the original base to get it working with yours. I already bought the hardware but it will take over a month to get here before I can do any proper testing with OpenHab.

My programming experience is of a hacker level, smashing code together and hoping for the best, so I am no place near your level, Unfortunately, something that would take you seconds would take me years.

[PWM_HACK](https://github.com/espressif/ESP8266_MP3_DECODER/blob/master/mp3/user/user_main.c#L65)
Is the source no longer alike from it's base?

karawin, 2017-03-19:
I tested with http://192.168.1.253/?instant="http://api.voicerss.org/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"

KaRadio has nothing in common with PWM_HACK.
So the integration is a very big work.

NonaSuomy, 2017-04-05:
Thanks for the test link, worked.

Closed 2017-03-15.

Thread 23 (2017-04-05):

Purging the entire station list causes strange lockups on boot

NonaSuomy, 2017-04-05:
Had to keep resetting the unit until I was able to get back in for a second to upload the sample station list, then it stabilized again.

Also after you delete the entire list there doesn't seem to be a way to add one station back without importing a list. The station screen was empty no edit buttons until the import.

karawin, 2017-04-05:
I can't see the same problem.

Le 05/04/2017 à 05:21, NonaSuomy a écrit :
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

NonaSuomy, 2017-04-06:
OTA updated to 1.1.8 and it seems fine now :+1:

Closed 2017-04-06.

Thread 24 (2017-04-05):

Connected SRAM IC doesn't seem to respond.

NonaSuomy, 2017-04-05:
When I type sys.ram, should I see some info, if there is no ram chip available or it only shows something if there is external ram hooked up.

I Connected external ram 23LC1024.
[23LC1024](http://www.microchip.com/wwwproducts/en/23LC1024)
[23LCV1024](http://www.microchip.com/wwwproducts/en/23LCV1024)
[PDF 23LC1024](http://ww1.microchip.com/downloads/en/DeviceDoc/20005142C.pdf)
[PDF 23LCV1024](http://ww1.microchip.com/downloads/en/DeviceDoc/25156A.pdf)

23LC1024 has Vhold <== using this one.
23LCV1024 has VBAT

*Note: If your chip has a /Vhold in place of /VBAT, the pin 7 must be wired to VCC (pin8)* instead of pin 7 to GND for the V series..

1:CS = GPIO16
2:MISO = GPIO12
3:NC = VCC 3.3v
4:GND
5:MOSI = GPIO13
6:SCK = GPIO14
7:VCC 3.3v
8:VCC 3.3v

Double checked wiring still no love.
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

WebRadio with the VS1053 works so far only at lower bitrates, 24k streams from stream6.jungletrain.net:8024 is the first one I got working, with no stuttering. 64k stutters stream6.jungletrain.net:8064, 128k is worse stream6.jungletrain.net:8128 hopefully the ram helps?

Found another note in the datasheet:
Pin3 is not used in SPI mode and should not be left floating.

Still didn't help though.

karawin, 2017-04-05:
the command sys.ram doesn't exist.
To see if the external ram is detected, see the log after a reset:
=> extraram state: 0 0xff ÿÿÿÿÿÿÿÿÿÿÿÿÿÿÿÿ  show a non detected ram
=> extraram state: 1 0x30 1234567890  show a detected ram

Be sure to wire a0 (adc0) to ground.

=> extraram state: 0 0xff ÿÿÿÿÿÿÿÿÿÿÿÿÿÿÿÿ
data  : 0x3ffe8000 ~ 0x3ffe8902, len: 2306
rodata: 0x3ffe8910 ~ 0x3ffead7c, len: 9324
bss   : 0x3ffead80 ~ 0x3fff1bc0, len: 28224
heap  : 0x3fff1bc0 ~ 0x40000000, len: 58432
Heap size: 30648
t0 task: 3fff89f8
t1 task: 3fff8b90
t4 task: 3fff90e8
t3 task: 3fff9730
t2 task: 3fffa480
mode : sta(5c:cf:7f:1c:75:ab)
add if0
UART READY TO READ
AP1: karawin2, AP2:
  Station Ip: 192.168.1.253
scandone
Trying karawin2,  I: 0 status: 1
SCI_Mode (0x4800) = 0x4802
SCI_Status (0x48) = 0x4C
VS Version (VS1053 is 4) = 4
SCI_ClockF = 0xB800
I2S Speed: 0
plugin size 18ce 2 c67
plugin start: 7 1 8050 6
scandone
state: 0 -> 2 (b0)
state: 2 -> 3 (0)
state: 3 -> 5 (10)
add 0
aid 6
pm open phy_2,type:2 0 0
cnt

connected with karawin2, channel 11
dhcp client start...
ip:192.168.1.253,mask:255.255.255.0,gw:192.168.1.70
autostart: playing:1, currentstation:23
I2S Speed: 0

Le 05/04/2017 à 06:04, NonaSuomy a écrit :
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

NonaSuomy, 2017-04-05:
Interesting, I could have sworn I saw that in this [interface.txt](http://karadio.karawin.fr/Interface.txt) guess I was just seeing what I wanted to :smile_cat:

Seems it detects it fine, I guess I just expected too much, that it was going to solve the constant stutter :disappointed:

Any way to figure out what is wrong with any streams above 24kbps.

Using an Adafruit Huzzah (ESP8266).

50Mbps connection, any way to do a speed test on the module?

 ets Jan  8 2013,rst cause:1, boot mode:(3,5)

load 0x40100000, len 1856, room 16
tail 0
chksum 0x63
load 0x3ffe8000, len 776, room 8
tail 0
chksum 0x02
load 0x3ffe8310, len 552, room 8
tail 0
chksum 0x79
csum 0x79

2nd boot version : 1.5
  SPI Speed      : 40MHz
  SPI Mode       : QIO
  SPI Flash Size & Map: 32Mbit(512KB+512KB)
jump to run user2 @ 81000

~
 lûÁn

    llì
       àl`nÄÞRÿ
=> extraram state: 1 0x30 0123456789ABCDEF
data  : 0x3ffe8000 ~ 0x3ffe8902, len: 2306
rodata: 0x3ffe8910 ~ 0x3ffead7c, len: 9324
bss   : 0x3ffead80 ~ 0x3fff1bc0, len: 28224
heap  : 0x3fff1bc0 ~ 0x40000000, len: 58432
Heap size: 43616
t0 task: 3fff5750
t1 task: 3fff58e8
t4 task: 3fff5e40
t3 task: 3fff6488
t2 task: 3fff71d8
mode : sta(18:fe:34:a5:c5:b7)
add if0
UART READY TO READ
AP1: All Your Base, AP2:
 Station Ip: 10.13.38.65
scandone
Trying All Your Base,  I: 0 status: 1
SCI_Mode (0x4800) = 0x4802
SCI_Status (0x48) = 0x4C
VS Version (VS1053 is 4) = 4
SCI_ClockF = 0xB800
I2S Speed: 0
plugin size 18ce 2 c67
plugin start: 7 1 8050 6
scandone
state: 0 -> 2 (b0)
Trying All Your Base,  I: 1 status: 1
state: 2 -> 3 (0)
state: 3 -> 5 (10)
add 0
aid 4
pm open phy_2,type:2 0 0
cnt

connected with All Your Base, channel 9
dhcp client start...
ip:10.13.37.65,mask:255.255.255.0,gw:10.13.37.1
autostart: playing:0, currentstation:113
I2S Speed: 0

NonaSuomy, 2017-04-16:
Did some Fritzing breadboard/schematics for the two different SRAM connections.

I used a Geeetech VS1053B breakout from ebay which was cheaper than the sparkfun breakout.

**23LC1024 SRAM**
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

**23LCV1024 SRAM**
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

Closed 2017-05-30.

Thread 25 (2017-04-06):

Python script to send urls from streamtheworld.com to player.

NonaSuomy, 2017-04-06:
<script src="https://gist.github.com/NonaSuomy/e32ff94ed728c8d31947477787d59d89.js"></script>

desadsea, 2017-04-21:
Hi, sorry but I did not understand how to use the script, could you make a practical example? Thanks Ezio

NonaSuomy, 2017-04-22:
@desadsea it's very simple at the top of the script is the usage example, basically find a radio station on iheartradio [iheartradio station list](https://en.wikipedia.org/wiki/List_of_radio_stations_owned_by_iHeartMedia)
```Usage: python2 streamtheworldka.py CIMXFM 10.13.37.65
                                   ^Radio callsign  ^IP address of Ka-Radio Device
```
make sure you have python2 and curl installed on the system you are sending the station from, download the script to a file on that device, then type the command, I named the script streamtheworldka.py, so you type on the command line python2 streamtheworldka.py (The radio call sign + FM on the end) (IP Address of your Ka-Radio Player)

First, test with the call sign above/below make sure it is all in CAPS as I know that one works (may not work outside of Canada), the hard part would be finding how they named the call sign for the station you want, and some may be location locked so be aware, you also have to add that FM/AM on the end of the call sign.

The script then tells the website to give us the ShoutCast stream URL for audio stream compatibility purposes with _SC.

```
python2 streamtheworldka.py CIMXFM 10.13.37.65
```

The script is grabbing the stream URL that is randomly encoded a string of characters for that station you want then sending the URL to the ESP8266.

The script request a URL like this:
http://playerservices.streamtheworld.com/api/livestream?version=1.5&mount=CIMXFM&lang=en

Then it sends back an XML which we extract the values from:
```
<live_stream_config xmlns="http://provisioning.streamtheworld.com/player/livestream-1.5" version="1.5">
  <script/>
    <mountpoints>
      <mountpoint>
        <status>
          <status-code>200</status-code>
          <status-message>OK</status-message>
        </status>
        <transports>
          <transport>http</transport>
        </transports>
        <metadata>
          <shoutcast-v1 enabled="true" mountSuffix="_SC"/>
          <shoutcast-v2 enabled="false" mountSuffix="_SC"/>
          <sse-sideband enabled="true" streamSuffix="_SC" metadataSuffix="_SBM"/>
        </metadata>
        <servers>
          <server sid="18853">
          <ip>18853.live.streamtheworld.com</ip>
          <ports>
            <port type="http">80</port>
            <port type="http">3690</port>
          </ports>
        </server>
        <server sid="17023">
          <ip>17023.live.streamtheworld.com</ip>
          <ports>
            <port type="http">80</port>
            <port type="http">3690</port>
          </ports>
        </server>
        <server sid="13733">
          <ip>13733.live.streamtheworld.com</ip>
          <ports>
             <port type="http">80</port>
             <port type="http">3690</port>
          </ports>
        </server>
        <server sid="14213">
          <ip>14213.live.streamtheworld.com</ip>
          <ports>
            <port type="http">80</port>
            <port type="http">3690</port>
          </ports>
        </server>
      </servers>
      <metrics>
        <tag name="uuid"/>
      </metrics>
      <mount>CIMXFM</mount>
      <format>FLV</format>
      <bitrate>48000</bitrate>
      <media-format container="flv" cuepoints="stwcue">
        <audio index="0" samplerate="22050" codec="mp3" bitrate="48000" channels="2"/>
      </media-format>
      <authentication>0</authentication>
      <timeout>0</timeout>
      <send-page-url>0</send-page-url>
    </mountpoint>
  </mountpoints>
</live_stream_config>
```

The script extracts,

Random generated IP: 18853.live.streamtheworld.com
Port: 80, 3690, etc
MountPoint(callsign): CIMXFM

I noticed that there was ShoutCast compatibility in the XML which it shows to add "_CS" onto the mount point: CIMXFM_CS

Then the script sends this data gathered from the XML to Ka-Radio device:

curl http://10.13.37.65/?instant="18853.live.streamtheworld.com:3690/CIMXFM_SC"

Then Ka-Radio should start playing the stream.

If you attach a serial cable to Ka-Radio you should be able to debug what URL is getting passed to it, to see if the station is getting sent properly.

Hope it helps!

NonaSuomy, 2017-04-23:
@desadsea I have to thank you, I clicked on your name and you had a repository for esp-radio with Arduino, been hacking away at it and got it loaded, radio stations stream flawlessly where I couldn't get Ka-Radio to stream anything over 24Kbps. It does 320kbps@160Mhz 256kbps@80Mhz, Also, it uses no EXT RAM just a Ring Buffer. [Esp-radio](https://github.com/Edzelf/Esp-radio) Guess I will be switching over to it for now until I find an issue with it that I can't solve like stuttering with Ka-Radio. Will have to try this script with it as well :+1:

desadsea, 2017-04-23:
@NonaSuomy Thank you for having responded, and helped me to figure out how Python script works,
As soon as I have the time I want to try, with regard to the esp with arduino, it's not my project I put it on githbub and how would you like to try it, thank you again for your kindness Ezio.

NonaSuomy, 2017-05-04:
Did an [OpenHAB mod for ESP-Radio](https://github.com/Edzelf/Esp-radio/issues/77)

NonaSuomy, 2017-05-04:
And integrated the xml parser into ESP-Radio for [IHeartRadio](https://github.com/NonaSuomy/Esp-radio/tree/NonaSuomy-XML-Parser)

karawin, 2017-05-04:
What is the interest of streamtheworld?

Le 04/05/2017 à 07:24, NonaSuomy a écrit :
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

NonaSuomy, 2017-05-06:
Just to note the parser I did was included into the main branch of ESP-Radio now for anyone interested presets look like ihr/CIMXFM.

StreamTheWorld consumes local radio station content and then they rebranded the site as iHeartRadio.

Some people enjoy local radio content stations for stuff relative to them or feels of nostalgia.

[wiki iHeartRadio](https://en.wikipedia.org/wiki/IHeartRadio)

Thread 26 (2017-04-09):

How to connect I2C display and hardware buttons?

W1nterSilence, 2017-04-09:
Hi! First of all I would like to say thanks a lot for this project, - it is exactly what I was looking for to build up a WiFi radio.

Sorry this issue thing is not supposed to ask this kind of questions, I am not so familiar with the GitHub communication principles and approaches, but I saw in comments on [instructables](http://www.instructables.com/id/Wifi-Webradio-With-ESP8266-and-VS1053/?ALLSTEPS) and [Hackaday](https://hackaday.io/project/11570-wifi-webradio-with-esp8266-and-vs1053) that there is some way to add LCD and buttons. Do you have instructions to cover how it could be implemented?

And one more - I saw the instructions to upload your firmware via the ESPRESSO. I guess that the same could be done with the source code and Arduino SDK, but can't find out how it can be done exactly. Do you have some docs to cover this part as well?

Again, - thanks again for this great project.

karawin, 2017-04-09:
Hi,

I made 4 projects to add a lcd  with or without Remote IR control.
See them at
karadio.karawin.fr/karadioU8glib.zip  for black and white lcd or oled
karadio.karawin.fr/karadiolcd16x2.zip for a 16x2 display
karadio.karawin.fr/karadioUCglib.zip For a color lcd
karadio.karawin.fr/karadioUCSTM32.zip the new one with color lcd, IR and a rotary encoder.
 Very easy. Turn knob= volume. One click+turn=station choice, double click= start/stop.
 See https://youtu.be/_kqOC5ySlSM

For each: Description in zip ucglibConf.h file, source for arduino.

What is espresso?
KaraDio itself is not an arduino project.
Thanks

W1nterSilence, 2017-04-09:
Sorry, I've mistyped - I meant [Espressif Flash Download Tool](http://bbs.espressif.com/viewtopic.php?t=641). Since it' s GUI version is available only for Windows, I thought that I could use Arduino to upload firmware)

Am I getting it right that if I want to use LCD and keyboard, - I should add arduino to handle it? Well, I  believe that it is quite obvious question, but nevertheless - is there any chance to use LCD directly to ESP8266?

karawin, 2017-04-09:
It exists various way to flash the esp including arduino i suppose.
Anyway, you have to flash it only one time because all update will be with ota directly.

I don't want to use a lcd directly. It is too restrictive. I offer a clean interface on uart for an external cpu.
Much more flexible. Karadio is big and difficult to install and generate. An exteraznl cpu under arduino is simple and flexible.

Closed 2017-04-18.

Thread 29 (2017-05-11):

Autoplay

1ron-pon3, 2017-05-11:
Hi! Is autoplay checkbox should enable autoplay last played station after booting up? If so, it doesn't work.
I use v 1.2.1. Unchecking and checking it again doesn't help.

karawin, 2017-05-11:
Do not be so sure.
It is necessary to check and uncheck just once the box to memorize it in karadio.
After that, it's good forever.

1ron-pon3, 2017-05-12:
I checked in unchecked it several times, tried to reboot end check it but the only result is the checkbox is sawed in web interface, but the autoplay itself doesn't work

karawin, 2017-05-12:
Which release?
Do an upgrade if not 1.2.1.

12 mai 2017 a écrit :
>I checked in unchecked it several times, tried to reboot end check it
>but the only result is the checkbox is sawed in web interface, but the
>autoplay itself doesn't work

--
Envoyé de mon téléphone Android avec <a href="https://play.google.com/store/apps/details?id=com.onegravity.k10.pro2"><b>K-@ Mail</b></a>. Excusez la brièveté.

1ron-pon3, 2017-05-12:
It's 1.2.1

karawin, 2017-05-12:
See the log on the serial usb.
Send it please

12 mai 2017 a écrit :
>It's 1.2.1

--
Envoyé de mon téléphone Android avec <a href="https://play.google.com/store/apps/details?id=com.onegravity.k10.pro2"><b>K-@ Mail</b></a>. Excusez la brièveté.

1ron-pon3, 2017-05-12:
It's funny, but from serial it looks like it works, but there is no sound before I press "Play" in web interface

`dhcp client start...
ip:192.168.0.104,mask:255.255.255.0,gw:192.168.0.1
autostart: playing:1, currentstation:0
##CLI.STOPPED# from playStationInt
##CLI.NAMESET#: 0 RM
##CLI.URLSET#: 93.125.53.192
##CLI.PATHSET#: /live
##CLI.PORTSET#: 8000
##CLI.OVOLSET#: 126
##CLI.VOL#: 254
##CLI.STOPPED# from Adc Stop
##CLI.ICY0#: Radio Maria Belarus
##CLI.ICY3#: http:\/\/www.radiomaria.by
##CLI.ICY4#: Religion
##CLI.ICY5#: 128
`

karawin, 2017-05-12:
#CLI.STOPPED# from Adc Stop

You forgot to wire adc (a0) input to the gnd

Le 12/05/2017 à 18:20, 1ron-pon3 a écrit :
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

1ron-pon3, 2017-05-12:
No, I didn't. It is wired. I even checked the connection with multimeter now, and the connection is definitely ok.

karawin, 2017-05-12:
So you have a problem with the adc input.
##CLI.STOPPED# from Adc Stop
The only reason to see this message is
			if (adc < 220) // stop
			{
				inside = true;
				clientDisconnect("Adc Stop");
			}

When the detection think that a control panel is wired.
if (system_adc_read() < 10) adcdiv = 0; // no panel adc grounded

Check directly on the esp8266 board
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
to see 0V?

1ron-pon3, 2017-05-12:
Oh, thank you very much. I understand now. The reason should be that I used NodeMCU Dev Kit, and it has a resistor on adc line between esp pin and connector. I will solder wire directly to adc pin now. Thank you again!

karawin, 2017-05-12:
The resistors are normal, they divide the input by 3.
If you don't read 0v when a0 is grouded, may be a failure on these resistors.
The software is able to see if it is a nodeMcu or a bare esp adc input.

1ron-pon3, 2017-05-15:
So, I have no idea what was the problem, but I solved it by wiring ADC to 3.3V with 16K resistor and to ground with 7k (like if there was a keyboard connected). Now it works. Thank you for your help again.

Closed 2017-05-11.

Thread 30 (2017-05-19):

Playing resumes after pressing stop while power is on

romankot, 2017-05-19:
Steps to reproduce:
- start playing
- stop by hardware button or  via webui
- playing resumes after some time (from few seconds to several minutes)
I expected no playing after pressing stop button.
The issue is reproducible on v1.2.1

karawin, 2017-05-19:
Please Check adc to gnd connection.

Le 19/05/2017 à 17:43, Roman a écrit :
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

karawin, 2017-05-19:
Sorry, not seen the hardware button...
Are your wires longs? May be an interference...

Le 19/05/2017 à 17:43, Roman a écrit :
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

romankot, 2017-05-19:
Hardware button board connected with devkit with wires no more than 10cm long. Moreover volume buttons don't work every time correctly, next/previous works fine as well as stop/start

karawin, 2017-05-19:
This panel is very sensitive to the 3.3v accuracy and stability (and
resistors precisions).
Check  to see if it is really 3.3 volts. The adc must be at 1.0 volt
when no button in action

Le 19/05/2017 à 22:57, Roman a écrit :
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

karawin, 2017-05-24:
No news?

Closed 2017-05-24.

Thread 31 (2017-06-01):

No reaction after flashing 1.3

hcremer, 2017-06-01:
Hi,
I tried to flash the new version on a ESP-12F. Did it before successfully with former version on other chips.

Now after flashing not getting access point and on  serial terminal @74880 baud I'm only getting:
" ets Jan  8 2013,rst cause:2, boot mode:(3,0)

load 0x40100000, len 2408, room 16
tail 8
chksum 0xef
load 0x00000000, len 0, room 0
tail 0
chksum 0xef
load 0x00000000, len 0, room 8
tail 0
chksum 0xef
csum 0xef
csum err
ets_main.c "

On the same chip, I installed the WifiAccessPoint ESP8266Wifi sample scetch with the arduino ide and it worked fine as an access point.

Any ideas?

karawin, 2017-06-01:
It seemes that the boot is missing. See https://hackaday.io/project/11570-wifi-webradio-with-esp8266-and-vs1053

hcremer, 2017-06-01:
This is the command I used to flash:
sudo python2.7 esptool.py --port /dev/ttyUSB0 write_flash -ff 40m -fm qio -fs 32m 0x00000 boot_v1.6.bin 0x01000 user1.4096.new.4.bin 0x81000 user2.4096.new.4.bin 0x7e000 blank.bin 0x3fe000 blank.bin 0xfc000 esp_init_data_default.bin 0x3fc000 esp_init_data_default.bin

I also tried to flash under windows as shown in the screenshot https://cdn.instructables.com/FLS/H6IE/IZYGAMAW/FLSH6IEIZYGAMAW.SMALL.jpg?width=289.34070796460173

It always says that the flashing is successful. I tried the files downloaded from https://hackaday.io/project/11570-wifi-webradio-with-esp8266-and-vs1053 and also from the unzipped https://github.com/karawin/Ka-Radio.git

I also tried the 1.5 and the 1.6 boot files, but it never worked, ... (Arduino sample sketches for ESP8266 working fine on the same chip)

Do I maybe need to change fuses on these chips to load the bootloader @0x0000 when starting the chip?

karawin, 2017-06-01:
All seems correct. See the image of the right boot sequence.
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

hcremer, 2017-06-01:
I'm very confused now.
I tested it with another ESP-12F chip labeled: "MODEL: ESP8266MOD VENDOR: AI-THINKER"
Did exactly the same and it works fine.
The ones I bought at Bangood are labeled "MODEL: ESP8266MOD VENDOR: ESP-F" and told to be "Geekcreit® ESP-F ESP8266 Remote Serial Port WiFi IoT Module Nodemcu LUA RC Authenticity Compatible With ESP-12F" don't work with this strange behaviour described above.
What could be the difference (they both claim to be ESP-12F)?

karawin, 2017-06-01:
Don't know. May be a missing pullup on a gpio?

riedmueller, 2017-06-02:
Hello,
i have the same problem. I found out that i have to flash it with "DIO" SPI Mode 40MHz.

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

After flashing with this settings it seems to work (AP WifiWebRadio available, LED blinking)....

karawin, 2017-06-02:
So this model is not QIO. Probably to free the additional gpio's

hcremer, 2017-06-03:
Tried it with DIO
Now getting messages on serial@115200 baud but no access point viewable
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

karawin, 2017-06-03:
Something is blocking the vs1053 dialog. Check the dreq line.

hcremer, 2017-06-03:
After a few reboots it now works :-)
Thanks a lot to everybody for the help!

Closed 2017-06-03.

Thread 32 (2017-06-04):

Resets and hangup's - strange behaviour

riedmueller, 2017-06-04:
Hallo,
i have built up a ka-radio out of an module VS1053B and an nodemcu V3.
I have flashed the nodemcu with firmware 1.3.
For now i never heared anything out of the VS1053 module (small handy earphone connected). I checked the connection and i think it's OK.

The web interface worked first for configuration, but now it hangs sometimes after:
- bootup
- Start playing a radio
- after rebootup by reset switch (example: hangup --> click reset switch --> reboot --> hangup -->click reset switch --> reboot --> hangup --> click reset switch --> now "overflow the heap_size"
Does a reset by reset switch not the same as powerup reset??
Only power off-on helps sometimes

Sometimes it shows strange behaviour in the settings:
- After false WIFI settings i could not reflash the system to get a clean system
  --> It seems that the settings are stored somewhere and stay consistent.
  --> Only way was to flash 1MB 0xFF dummy files 0n Adress 0x0000 0x10000 0x20000 0x30000
  --> After that reboot and reflash ka-radio
- Same behaviour with the station list. I wiped out everything with the 1MB 0xFF dummy files. But after flashing the firmware , the station list was not empty... So where was it saved?
- Sometimes i get strange settings after reboot (but the settings are not changed before)
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

I attached a logfile after hangup and klicking 1 time (!!) on the reset button.
[logfile.txt](https://github.com/karawin/Ka-Radio/files/1050509/logfile.txt)
It restarts several times and than hangs up.

For flashing i used this tool with DIO setting as QIO not works.
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

I have no logical conclusion because its a little bit confused problem.
So whats wrong here?
Could DIO instead of QIO be an problem?
Could it be that i have to change to another memory map 512+512 ---> 1024+1024 ?? (32Mbit-C1 ?)
Is there a precompiled testcode to check if the VS1053 is working?

Thanks!

karawin, 2017-06-04:
Hallo,
i have built up a ka-radio out of an module VS1053B and an nodemcu V3.

**Is it an AI-thinker ESP12E? ESP8266MOD?**

I have flashed the nodemcu with firmware 1.3.
For now i never heared anything out of the VS1053 module (small handy earphone connected). I checked the connection and i think it's OK.

The web interface worked first for configuration, but now it hangs sometimes after:
- bootup
- Start playing a radio
- after rebootup by reset switch (example: hangup --> click reset switch --> reboot --> hangup -->click reset switch --> reboot --> hangup --> click reset switch --> now "overflow the heap_size"
Does a reset by reset switch not the same as powerup reset??

**It is the same **

Only power off-on helps sometimes

**Check your power supply. Is it from usb?**

Sometimes it shows strange behaviour in the settings:
- After false WIFI settings i could not reflash the system to get a clean system

**If the AP is not good, it fails back to Webradio 192.168.4.1**

  --> It seems that the settings are stored somewhere and stay consistent.

**Yes in the end of the flash memory**

  --> Only way was to flash 1MB 0xFF dummy files 0n Adress 0x0000 0x10000 0x20000 0x30000
  --> After that reboot and reflash ka-radio
- Same behaviour with the station list. I wiped out everything with the 1MB 0xFF dummy files. But after flashing the firmware , the station list was not empty... So where was it saved?

**A local mask is kept in the browser memory per ip**

- Sometimes i get strange settings after reboot (but the settings are not changed before)

I attached a logfile after hangup and klicking 1 time (!!) on the reset button.
"A bit hard to read no? I cannot read it. full of strange chineese char.
Is it a 115200 bauds**

[logfile.txt](https://github.com/karawin/Ka-Radio/files/1050509/logfile.txt)
It restarts several times and than hangs up.

For flashing i used this tool with DIO setting as QIO not works.

**If QIO doesn't work and if it is an ESP12E something is physically broken in the flash memory access.**

I have no logical conclusion because its a little bit confused problem.
So whats wrong here?
Could DIO instead of QIO be an problem?

**In theory no.**

Could it be that i have to change to another memory map 512+512 ---> 1024+1024 ?? (32Mbit-C1 ?)

**No**

Is there a precompiled testcode to check if the VS1053 is working?

**No. with all these strange reactions, i am pretty sure that the power supply is not good.**

Thanks!

riedmueller, 2017-06-05:
Hi,
i bought it from al express. The picture of the seller shows AI-thinker on it. But my modele shows HYSIRY:
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
ANd here the VS1053B
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

I checked the power supply. It's from PC, but now i tested a 1A 5V USB Power supply without luck. Then i used laboratory supply 5V on VIN and GND of NodeMCU (VS1053 connected zto 5V of labsupply) also without better reactions.

Of corse the logfile is unreadble on some points, because of the 78800 baud. but the rest is readable w. notepad++...
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
....

My connection was
VS1053 --> NODEMCU
5V --> VIN
DGND --> GND
MOSI --> D7 (GPIO13)
DREQ --> D2 (GPIO4)
XCS --> D8 (GPIO15)
XDCS  --> D1 (GPIO5)
XRST --> D3 (GPIO0)
SCK --> D5 (GPIO14)
MISO --> D6 (GPIO12)
and on NODEMCU: VIN ==5V from lab-supply, A0==GND, EN on 3V

karawin, 2017-06-05:
All is good. It is not the first time that i see some problems with clone of ai-thinker.
Try these bin
http://karadio.karawin.fr/user1.4096.tmp.4.bin
http://karadio.karawin.fr/user2.4096.tmp.4.bin

The first log was really unreadable with the block note.

riedmueller, 2017-06-05:
Hello,
now  i disconnected all wires and flashed nodemcu firmware. it works for connectiong with lua interpreter - but only flashed with DIO.
After that i flashed your first ....tmp.4.bin. Switched power off and than one wire from A0-->GND.
After powerup via USB i get (78800):
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
Then i switched the terminal to 115200baud and make a reset via reset button:
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
Then i set the WIFI settings and the system makes an reboot. Her is the end of terminal output:
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
The low memory message comes some time after clicking through the pages in web interface without changing something. Is this message critical?
After repowering i can repeat this behaviour:
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
But: evering seems OK  with wifi connection and the behaviour is repeatable (reset button)

Now i connected the VS1053 module. This time powered with USB (measured 4.9V) VS1053 connected to VUSB.
Now the system hangs on wifi connect. It's not accessible... LED is not blinking. No answer on requests via uart interface.
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
I disconnected and connected usb three times with the same behaviour. Then i got a connect:
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

Then i used the web interface and restored the webstations list.
I start playing one radio...
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
Now the same again:
- No audio aut of VS1053
- LED stops blinking
- No answer on uart requests

riedmueller, 2017-06-05:
And now i found out that if i disconnect D3 (GPIO0) during this hang up, the LED starts blinking again and connects sometimes to wifi...
And if i touch the insulation of this wire (XRST) an humming sound comes out of the earphone. Thats cool but not the sound that i want :- )

karawin, 2017-06-05:
Look at your log

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

Stopped from ADC stop means that a control switch is detected. Are you sur to have connected ADC to gnd?

I had another user with the same problem. The board was broken for adc. Check that the inpur of the esp is really at 0v

Send a log from the beginning with the vs1053 connected.

karawin, 2017-06-05:
Are you sure of your gateway?

riedmueller, 2017-06-05:
I think i have found the problem!!!

As described here:
[http://www.toughdev.com/content/2013/10/interfacing-vs1053-audio-encoderdecoder-module-with-pic-using-spi/](url)
> The real problem, after much research effort, is the XTEST pin on the VS1053. This pin must be connected to VDD for things to work consistently. Many clone boards, including earlier versions of the Sparkfun VS1053 boards and those sold on eBay, leave the XTEST pin unconnected, leading to unspecified behavior. I referred to the datasheet for the location of XTEST, which is pin 32 in the LQFP-48 package:

So i shorted PIN 32 with PIN31 and than it boots and works!!
 (and PIN34 with PIN33 because it starts in MP3 mode, but i think this was not the problem)

riedmueller, 2017-06-05:
And i checked ADC0 --> The input was directly connected to GND. Multimeter shows 0V. So i dont know why it says ...from ADC stop...
And now it works.
Could it be, that an missing or misconfigured VS1053 be a reason fro overflows, low memory or something else?

Alnoor55, 2018-06-04:
Hi I got it working with the web interface, but unable to compile the karadioUCSTM32.ino , missing libary
MapleFreeRTOS.h   . can you help please

karawin, 2018-06-04:
Read ucglibConf.h for the software required
Software:
---------
STM32DUINO  (to add support of the stm32 with arduino IDE:
https://github.com/rogerclarkmelbourne/Arduino_STM32
Bootloader (see http://wiki.stm32duino.com/index.php?title=Bootloader)
https://github.com/rogerclarkmelbourne/STM32duino-bootloader (the one we need is generic_boot20_pc13.bin)
Instruction to load the bootloader on stm32 (one time)
http://www.stm32duino.com/viewtopic.php?f=32&t=413

Libraries needed:
ucglib for stm32 must be installed in  arduino IDE library;
https://github.com/karawin/Ucglib_Arduino

IRMP library for stm32Duino:
https://github.com/karawin/irmp-master
See https://www.mikrocontroller.net/articles/IRMP_-_english

KY040 library:
https://github.com/karawin/encoder

Closed 2017-06-16.

Thread 33 (2017-06-08):

Update via webinterface fails

hcremer, 2017-06-08:
Hi,
when trying to update from version 1.3 (flashed via USB) to version 1.3.1 via Webinterface, it leaves the version number in the upper right corner on V1.3 (also after cache erase in the webbrowser)

The serial terminal says:

"update  firmware
current id 0
flash size  4
Connect ok!
Request send success
pre erase flash!
userbin sumlength:410164
flash erase over
userbin sumlength:410164  flash:1
Connect ok!
Request send success
userbin sumlength:410164
server response with something else,check it!
upgrade data error!
Connect ok!
Request send success
pre erase flash!
userbin sumlength:410164
flash erase over
userbin sumlength:410164  flash:1
Connect ok!
Request send success
userbin sumlength:410164
server response with something else,check it!
upgrade data error!
Connect ok!
Request send success
pre erase flash!
userbin sumlength:410164
flash erase over
userbin sumlength:410164  flash:1
Connect ok!
Request send success
userbin sumlength:410164
server response with something else,check it!
upgrade data error!
Connect ok!
Request send success
pre erase flash!
userbin sumlength:410164
flash erase over
userbin sumlength:410164  flash:1
Connect ok!
Request send success
userbin sumlength:410164
server response with something else,check it!
upgrade data error!
Connect ok!
Request send success
pre erase flash!
userbin sumlength:410164
flash erase over
userbin sumlength:410164  flash:1
Connect ok!
Request send success
userbin sumlength:410164
server response with something else,check it!
upgrade data error!
spi_flash_read error 1
 Exit upgrade task.
 +OK: FW upgrade success.
reboot to use2
state: 5 -> 0 (0)
rm 0
pm close 7 0 0/341787327
del if0
usl
##CLI.STOPPED# from try restart
 ets Jan  8 2013,rst cause:2, boot mode:(3,0)
load 0x40100000, len 2408, room 16
tail 8
chksum 0xe5
load 0x3ffe8000, len 776, room 0
tail 8
chksum 0x84
load 0x3ffe8310, len 632, room 0
tail 8
chksum 0xd8
csum 0xd8
2nd boot version : 1.6
  SPI Speed      : 40MHz
  SPI Mode       : DIO
  SPI Flash Size & Map: 32Mbit(512KB+512KB)
jump to run user2 @ 81000
error magic!
first boot failed, reboot to try backup bin
 ets Jan  8 2013,rst cause:4, boot mode:(3,0)
wdt reset
load 0x40100000, len 2408, room 16
tail 8
chksum 0xe5
load 0x3ffe8000, len 776, room 0
tail 8
chksum 0x84
load 0x3ffe8310, len 632, room 0
tail 8
chksum 0xd8
csum 0xd8
2nd boot version : 1.6
  SPI Speed      : 40MHz
  SPI Mode       : DIO
  SPI Flash Size & Map: 32Mbit(512KB+512KB)
jump to run user1 @ 1000
~r ⸮ ⸮b
=> extraram state: 0 0xff ⸮⸮⸮⸮⸮⸮⸮⸮⸮⸮⸮⸮⸮⸮⸮⸮
SDK 1.4.2(f57d61a)
data  : 0x3ffe8000 ~ 0x3ffe899a, len: 2458
rodata: 0x3ffe89a0 ~ 0x3ffeb1ec, len: 10316
bss   : 0x3ffeb1f0 ~ 0x3fff2150, len: 28512
heap  : 0x3fff2150 ~ 0x40000000, len: 57008
Heap size: 29224
size_map: 4
t0 task: 3fff8f88
t1 task: 3fff9198
t4 task: 3fff96a0
t3 task: 3fff9cc0
t2 task: 3fffa8d0
Heap size: 21312
mode : sta(XX:XX:XX:XX:XX:XX)
add if0
watermark:336  heap:19928
SCI_Mode (0x4800) = 0x4802
SCI_Status (0x48) = 0x4C
VS Version (VS1053 is 4) = 4
p: XXX.XXX.X.XXX
scandone
Trying XXX,  I: 0 status: 1
scandone
state: 0 -> 2 (b0)
Trying XXX,  I: 1 status: 1
state: 2 -> 3 (0)
state: 3 -> 5 (10)
add 0
aid 1
pm open phy_2,type:2 0 0
cnt
connected with XXX, channel 10
dhcp client start...
ip:XXX.XXX.X.XXX,mask:255.255.255.0,gw:XXX.XXX.X.X
autostart: playing:1, currentstation:3
I2S Speed: 0
##CLI.STOPPED# from playStationInt
##CLI.NAMESET#: 3 WDR5
##CLI.URLSET#: wdr-wdr5-live.icecast.wdr.de
##CLI.PATHSET#: /wdr/wdr5/live/mp3/128/stream.mp3
##CLI.PORTSET#: 80
##CLI.OVOLSET#: 0
##CLI.VOL#: 90
##CLI.ICY0#:  WDR 5, Westdeutscher Rundfunk Koeln
##CLI.ICY3#:  http://www.wdr5.de
##CLI.ICY4#:  wdr
##CLI.ICY6#:  Westdeutscher Rundfunk Koeln
##CLI.PLAYING#
##CLI.META#: WDR 5 Hotline: 0221-56789 555
##CLI.META#: WDR 5 - Ich will es wissen
##CLI.META#: Westblick - Das Landesmagazin mit Edda Dammmüller"

I assume the flashing did not work because of several "upgrade data error!".
I don't understand the:
"spi_flash_read error 1
 Exit upgrade task.
 +OK: FW upgrade success."

What can I do to get the update via webinterface working?

Best regards,
H. Cremer

karawin, 2017-06-08:
I see
server response with something else,check it!

Don't know why.

Try again please.

The "spi_flash_read error 1
Exit upgrade task.
+OK: FW upgrade success."

means a problem in the update but a normal exit of the upgrade task.

I hope that it is not due to the DIO mode.

hcremer, 2017-06-08:
Thank you for replying so soon!
Tried it before with previous versions. No result. Flashed manually to 1.3 via USB (1 DIO chip 1 QIO chip).
Tried the same webupdate with the QIO chip. Same result.
How do I check the server response? Would Wireshark be a possibility? Unfortunately, I only have nearly no experience with this tool.
Could it be possible because of my IPFire-Firewall? Do you use other ports than 80 for the update?

karawin, 2017-06-08:
So, i think that
"server response with something else,check it!"
 is an error message from the firewall.

karawin, 2017-06-08:
void update_firmware(void)
{
    printf("update  firmware\r\n");
    uint8 current_id = system_upgrade_userbin_check();
    os_printf("current id %d\n", current_id);

	char* client_url = "karadio.karawin.fr";
//	char* client_url = "192.168.1.2";
#define bin_url  "user%d.4096.new.4.bin"
    struct upgrade_server_info *server = NULL;
    server = (struct upgrade_server_info *)malloc(sizeof(struct upgrade_server_info));
    memset(server, 0, sizeof(struct upgrade_server_info));
    server->check_cb = user_esp_upgrade_rsp;   //set upgrade check call back function
    server->check_times = 360000;
	server->upgrade_flag = true;

    if (server->url == NULL) {
        server->url = (uint8 *)malloc(512);
    }

    flash_size_map f_size = system_get_flash_size_map();
    os_printf("flash size  %d\n",f_size);
    if (current_id == 0) {
		 current_id = 2;
	} else current_id = 1;
    sprintf(server->url, "GET /"bin_url" HTTP/1.0\r\nHost: %s:80\r\n"pheadbuffer"",current_id, client_url);
//   os_printf("http_req : %s\n", server->url);

	struct hostent *serv ;
	serv =(struct hostent*)gethostbyname(client_url);
    server->sockaddrin.sin_family = AF_INET;
    server->sockaddrin.sin_port   = htons(80);
    server->sockaddrin.sin_addr.s_addr = inet_addr(inet_ntoa(*(struct in_addr*)(serv-> h_addr_list[0]))); // remote server ip
//	os_printf("distant ip: %x   ADDR:%s\n",server->sockaddrin.sin_addr.s_addr,inet_ntoa(*(struct in_addr*)(serv-> h_addr_list[0])));
    if (system_upgrade_start(server) == false) {
        os_printf("upgrade error\n");
    }

hcremer, 2017-06-08:
Tried it with no firewall (directly connected to the fritzbox wlan)
Result: No more reaction from the chip after web-upgrade. Needed to be re-flashed by USB to get it working again.

Serial terminal output:

update  firmware
current id 1
flash size  4
Connect ok!
Request send success
pre erase flash!
userbin sumlength:410164
 ets Jan  8 2013,rst cause:4, boot mode:(3,7)
wdt reset
load 0x40100000, len 2408, room 16
tail 8
chksum 0xe5
load 0x3ffe8000, len 776, room 0
tail 8
chksum 0x84
load 0x3ffe8310, len 632, room 0
tail 8
chksum 0xd8
csum 0xd8
2nd boot version : 1.6
  SPI Speed      : 40MHz
  SPI Mode       : QIO
  SPI Flash Size & Map: 32Mbit(512KB+512KB)
enhance boot mode, jump to run bin @ 1000
 @ 1000
error magic!
first boot failed, reboot to try backup bin
 ets Jan  8 2013,rst cause:4, boot mode:(3,7)
wdt reset
load 0x40100000, len 2408, room 16
tail 8
chksum 0xe5
load 0x3ffe8000, len 776, room 0
tail 8
chksum 0x84
load 0x3ffe8310, len 632, room 0
tail 8
chksum 0xd8
csum 0xd8
2nd boot version : 1.6
  SPI Speed      : 40MHz
  SPI Mode       : QIO
  SPI Flash Size & Map: 32Mbit(512KB+512KB)
enhance boot mode, jump to run bin @ 1000
 @ 1000
error magic!
backup boot failed.
user code done

hcremer, 2017-06-08:
When I try http://karadio.karawin.fr/ in a webbrowser, I get:
Forbidden

You don't have permission to access / on this server.
Apache/2.4.10 (Ubuntu) Server at karadio.karawin.fr Port 80

karawin, 2017-06-09:
In your log, the flash is erased then a watchdog reset occured. So It fails and cannot restart because the flash is erased.
Try again by reflashing manually. I don't know why the watchdog has been reached.

 http://karadio.karawin.fr is a file repository. I deny all other access. (no index.html)

hcremer, 2017-06-09:
I have no idea why, but the both chips (DIO and QIO) chip had the same problem:
Both had the watchdog problem at first attempt to upgrade via webinterface.
Both reflashed to 1.3 via USB.
Then upgraded via webinterface, cleared the browser cache and its on 1.3.1 :-)
To add to the log on hackaday anothe DIO chip is the "ESP-12F" labelled chip from https://www.banggood.com/Geekcreit-ESP-F-ESP8266-Remote-Serial-Port-WiFi-IoT-Module-Nodemcu-LUA-RC-Authenticity-p-1127307.html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

I would like to do a donation but paypal wants my address and phonenumber but I'm not willing to give it to them. Could you please give me an IBAN and BIC to send the money directly to you?

karawin, 2017-06-09:
Thanks.
To answer you, Send me an email directly.
jp@karawin.fr
paypal is safe (but who can be sure?)  no problem.

I have to analyse the update more deeply to found the cause.
I want a perfect software (if possible ;-)

Closed 2017-06-09.

Thread 35 (2017-07-04):

Button Control - Problem since  newer Software

gerdfinder, 2017-07-04:
Hello Karawin,
Thanks for the great software but I now have a problem with newer software after OTA update.

The keys do not work as before.

I have an ESP-07 (32Mbit) so **no 2: 1 voltage divider**

With the newer software, the keys no longer function,
If I retrofit the 100K / 220K voltage divider **(like NodeMCU)**
the keys work as before.

I think my board is not recognized correctly.

Gerd

tomasf71, 2017-07-04:
Same for me :-(

karawin, 2017-07-04:
Yes, sorry I made a mistake.
Do an OTA again, I modified the release.

karawin, 2017-07-04:
Wrong correction. Must be ok now.
OTA again and tell me please.

arlaor, 2017-07-05:
Hi. @karawin, Are you planning to migrate your webradio to the esp32 module? To take advantage of the new processor and ram?
@Edzelf confirms that it improves the performance of the project.

tomasf71, 2017-07-05:
Still doesnt work for me :-(

gerdfinder, 2017-07-05:
Same for me.
Update yesterday and today (now 10:15 am)
not working without voltage divider.

karawin, 2017-07-05:
Yes sorry for this problem. I cannot test it here.
I found a wrong data on 8 bits in place of 16.
It may be good now.
OTA again.....

Thanks for your help.

karawin, 2017-07-05:
The esp32 is much better in term of speed and sram.
Yes, i plan to port karadio to it. A question of time, it is a lot of work even if karadio is already a freertos project.
The @Edzelf project is a pure arduino one. With a main loop and callbacks on esp8266. Not very good for a big software.
Karadio is yet a server with multi clients only limited by the sram. With the esp32 the limit is removed.
But for one or two clients the result will be quite the same in term of user feeling. Other limits  will be considered: the spi speed for example.

gerdfinder, 2017-07-05:
Thank you karawin, now it's working!

But the "Next" key works slow or not.

No keys pressed are exactly 1,000 V on the AD-in
"Next" pressed are there 0.895V, i think it's ok.

Gerd

gerdfinder, 2017-07-05:
I adjust the "No keys pressed are exactly 1,000 V on the AD-in"
to 0.980 V and all keys are working.

tomasf71, 2017-07-05:
Now it works as before, thank you

karawin, 2017-07-05:
I added an uart command
sys.adc
to show the value read on adc.
If you want to adjust some parameters from the following listing, let me know. I made these value may be too quickly.
	adc *= adcdiv;

	if ((adc >400) && (adc < 580)) // volume +
	{
		setVolumePlus();
	}
	else if ((adc >730) && (adc < 830)) // volume -
	{
		setVolumeMinus();
	}
	if (!inside)
	{
		if (adc < 220) // stop
		{
			inside = true;
			clientDisconnect("Adc Stop");
		}
		else if ((adc >278) && (adc < 380)) //start
		{
			inside = true;
			sprintf(Vol,"%d",currentStation);
			playStation	(Vol);
		}
		else if ((adc >830) && (adc < 920)) // station+
		{
			inside = true;
			wsStationNext();
		}
		else if ((adc >590) && (adc < 710)) // station-
		{
			inside = true;
		wsStationPrev();
		}
	}
}

arlaor, 2017-07-05:
Hi @karawin
This is good news and I hope this migration will happen soon, because for some reason there are always intermittent cuts when listening to radio stations

karawin, 2017-07-05:
Intermittent cuts will not be resolved with the esp32.
They are due to the internet stream. If you can look at the instant bandwith used by your AP. You will see some hole or a saturation of your max bandwith. These hole if not too long are inexistant with the external memory. Yes, the esp32 will integrate this feature but it is not perfect if the 'hole' is more than few seconds.
Here i have a limited max speed of 400 kBytes and any download will cut the radio after 4 sec. on, off, on etc...
I don't see any QOS available on the esp nor my AP.

arlaor, 2017-07-09:
Hi @karawin
Sometimes I have to restart it up to 3 times to load correctly. But for what you tell me, it must be the internet. Thanks. I'll wait patiently for the version with esp32. In some way it will help in the performance

karawin, 2017-07-10:
Restat what? reset the nodemcu?
Check your power supply. It is abnormal.

arlaor, 2017-07-15:
Hi @karawin
I use 5V DC.  Is too much  voltage?

gerdfinder, 2017-07-15:
No, i use 230V AC,
but the Powerpin from ESP not more than 3V3!

karawin, 2017-07-15:
Vin 5V on nodeMCu is 5volt,
Vcc on bare esp8266 is 3.3 V

arlaor, 2017-08-05:
Hi @karawin
And when I connect the esp8266 module to my pc laptop to program it, it is receiving 5 volts, generated by the USB port. Should I use any voltage reducer to connect directly to the USB port on my laptop?

Closed 2017-07-05.

Thread 36 (2017-07-17):

Web control for Volume not working in binary version 1.3.4, boot 1.6

CaptainRoot, 2017-07-17:
Great Project! i used version 1.6 from the bin folder.
I noticed two things that i want you to know.
First, the volume control in the webinterface does not work.
Second, i testet the restore station list function with your list, after that i was not able to hear any station. after i edited one station and set the volume offset to 126 everything works fine

Kind regards,
Stephan

karawin, 2017-07-17:
Thanks.
The current release is 1.3.4
May be you can try this one?
All is working. Only a bug on the web stop resolved in the next one.

CaptainRoot, 2017-07-17:
Hi,
i used boot_v1.6.bin nd the binaries under Ka-Radio/ESP8266-Firmware/bin/upgrade/ so i guess it should be 1.3.4 the Webpage shows this in in upper right.
Volume Control is not working, i try it with Google Chrome

karawin, 2017-07-17:
Volume is working with a websocket on esp from the interface.
Hundred of users use it on this release.
For sure it works with all browser, edge chrome firefox etc.
The offset is for adjust the volume per station.

CaptainRoot, 2017-07-17:
Ok i retested ist wirh edge. works fine!
Google Chrome Version 59.0.3071.115 (Offizieller Build) (64-Bit) does not work ... but don't care
Maybe an extension is destroying this feature ...

karawin, 2017-07-18:
I test with Version 59.0.3071.115 (Build officiel) (64 bits) and it works. So may be as you said, an extension...

Closed 2017-07-17.

Thread 37 (2017-07-17):

Volume Control via web interface not working

cad435, 2017-07-17:
Volume control via Web Interface not possible changing the Sliders makes no difference in Volume...
changing the Volume via UART (cli.vol+/cli.vol-) is possible and works just fine...

I get many socket errors:
Clear i: 0, socket: 2, errno: 107

maybe that have to do with it

=================================================
Startup Log:

=> extraram state: 0 0xff ÿÿÿÿÿÿÿÿÿÿÿÿÿÿÿÿ
Release 1.3.4
SDK 1.4.2(f57d61a)
data  : 0x3ffe8000 ~ 0x3ffe899a, len: 2458
rodata: 0x3ffe89a0 ~ 0x3ffeb1dc, len: 10300
bss   : 0x3ffeb1e0 ~ 0x3fff2168, len: 28552
heap  : 0x3fff2168 ~ 0x40000000, len: 56984
Heap size: 29200
size_map: 4
t0 task: 3fff8fa0
t1 task: 3fff91b0
t4 task: 3fff96b8
t3 task: 3fff9d00
t2 task: 3fffa910
t5 task: 3fffaf58
Heap size: 19040
mode : sta(<MAC censored>)
add if0
UART READY
AP1: <SSID censored>, AP2: <SSID censored>
 AP1:Station Ip: <IP censored>
Trying <SSID censored> ,  I: 0 status: 1
SCI_Mode (0x4800) = 0x4802
SCI_Status (0x48) = 0x4C
VS Version (VS1053 is 4) = 4
SCI_ClockF = 0xB800
I2S Speed: 0
plugin size 6350 3175
plugin start: 7 1 8050 6
plugin size 234 117
plugin start: 7 1 8f00 6
scandone
state: 0 -> 2 (b0)
Trying <SSID censored> ,  I: 1 status: 1
state: 2 -> 3 (0)
state: 3 -> 5 (10)
add 0
aid 2
pm open phy_2,type:2 0 0
cnt

connected with <SSID censored>, channel 12
dhcp client start...
ip:<IP censored>,mask:255.255.255.0,gw:<IP censored>
Clear i: 0, socket: 1, errno: 107
autostart: playing:1, currentstation:0
I2S Speed: 2
##CLI.STOPPED# from playStationInt
##CLI.NAMESET#: 0 #Musik-House
##CLI.URLSET#: house-high.rautemusik.fm
##CLI.PATHSET#: /
##CLI.PORTSET#: 80
##CLI.OVOLSET#: 0
##CLI.VOL#: 80
No panel
ADC Divisor: 0 from adc: 0
Header: Moved
##CLI.STOPPED# from C_HEADER
##CLI.URLSET#: de-hz-fal-stream07.rautemusik.fm
##CLI.PATHSET#: /house
##CLI.PORTSET#: 80
##CLI.ICY0#: #MUSIK.HOUSE (FUNKY) - WWW.RAUTEMUSIK.FM - 24H MIXED HOUSE DANCE ELECTRO FUNK MINIMAL AND MORE!
##CLI.ICY1#: <BR>This stream requires <a href=\"http:\/\/www.winamp.com\/\">Winamp<\/a><BR>
##CLI.ICY2#: SHOUTcast Distributed Network Audio Server\/Linux v1.9.8<BR>
##CLI.ICY3#: http:\/\/www.rautemusik.fm\/house\/
Clear i: 0, socket: 2, errno: 107
##CLI.ICY4#: House Electro Electronic
##CLI.ICY5#: 192
##CLI.PLAYING#
##CLI.META#: Shirox - Bass In Your Face
Clear i: 0, socket: 2, errno: 107

karawin, 2017-07-18:
Yes it seems that the socket is closed when karadio try to write to it.
 No idea why.
 browser? This socket is opened by the browser.

cad435, 2017-07-18:
I use Google Chrome on Windows 7 64-Bit, but can try it with FF on Windows and Chrome on Android later at home...

all other controls are working via web interface, only Volume is not...

karawin, 2017-07-18:
It seems that some network administrator traps the websocket....
I will revert to a standart POST for volume.
All other websocket flow will remains the same (meta display etc....)

cad435, 2017-07-18:
ok, I tested it:

Chrome on Android 6.0.1 (CM13.1.2): nope
FF 54.0.1(32-Bit release) on Windows 7 64-bit: it works indeed...

Closed 2017-07-19.

Thread 41 (2017-07-27):

No AP point after flash,

Edragon, 2017-07-27:
after flashed the frimware, I get this from serial:

rl\0l湠|\0宭鄚

?l?b|巶 ?抮抌?b岒nn瀕nn溾?b
p鞄$rlrlp餹?

?l

b
n鈢 ??
b岒nn頫0l寧l` ? nn
l`   nr帓抧

拻l` p騨?

r寽溾?

b
n鈢 鞄帋b岒nn頫0

l` ? nn
l`   nr帓抧

?lp騨?

r寽溾囔l

b
n鈢 寧
?b岒nn頫0

l` ? nn
l`   nr帓抧

?l`  r拻n

?l` rl寣n湆騨n瀸炩宺 nnn?l宐?l\0
?抣?拻?

?
巐ll~rl\0
?抣lln溾\0

?
悓~抈 \0
?抣寪n鄮 n鞉n~  寣ll鄝b
鞂llpb?br倢靗`nl巔岇l`bl` l拻n
瀗寬鈔l瀨 b

 l

l` rl~r ?恇\0尀鈱b
l宐r|
lb溾?bp  鈘 鞄l\0祢n顎 nn?
 ll噔 l鞄?l鞄l
宭鞂岇l` € n黒0尀鈱b
l
l巖?
b
  尀鈱b
l
宐?lrl屸 ?俷鞉r傭n|?l
lll` 恟  n?炧?
=> extraram state: 0 0xff 
Release 1.5, Revision 0
SDK 1.5.0-dev(1aafc07)
data  : 0x3ffe8000 ~ 0x3ffe8928, len: 2344
rodata: 0x3ffe8930 ~ 0x3ffe8b2c, len: 508
bss   : 0x3ffe8b30 ~ 0x3fff00c0, len: 30096
heap  : 0x3fff00c0 ~ 0x40000000, len: 65344
Heap size: 37048
size_map: 4
t0 task: 3fff70f0
t1 task: 3fff7350
t4 task: 3fff7a60
t3 task: 3fff7e50
t2 task: 3fff83f8
t5 task: 3fff87e8
t6 task: 3fff8e30
Heap size: 27520
mode : sta(60:01:94:3b:57:21)
add if0

but there is no AP point called, ssid "WifiWebRadio". Did I flash the firmware probably? Thank you very much!

karawin, 2017-07-27:
The vs1053 acces is blocking.
Check the DREQ line or disconnect it to be sure it is the problem.

Edragon, 2017-07-27:
Yes, indeed, all good, serial output correctly. probably some soldering problem, when I have vs1053 all work.

Thank you very much.

Edragon, 2017-07-27:
Hi Karawin,

Yes one more question, there is a wiring instruction in the readme.md:
From ESP8266_ESP12( 3.3 v) to VS1053 (5 v)
REST
ADC if control panel is not used, this input must be grounded.
CH_PD to 3.3v
GPIO16 (a 1Hz output)
GPIO14 to VS1053 SCK
GPIO12 to VS1053 MISO
GPIO13 to VS1053 MOSI

TXD to CH340G UART rx
RXD from CH340G UART tx
GPIO05 to VS1053 XDCS
GPIO04 to VS1053 DREQ
GPIO00 to VS1053 XRST
GPIO02
GPIO15 to VS1053 XCS

But there is also a schematic called webradio in hardware folder, should I use the readme.md wiring?  Thanks!

Edragon, 2017-07-27:
in the schematic pdf, io5 is connected to DREG, I am not sure if it is the wiring problem.

karawin, 2017-07-27:
This schematic is the old one from piotr. Don't use it.
DREQ is on GPIO04 (d2)

Edragon, 2017-07-27:
good to know, thanks!

Closed 2017-07-27.

Thread 42 (2017-07-28):

Support Cyrillic characters required for channel/song name

romankot, 2017-07-28:

karawin, 2017-07-28:
Only by the browser. not by serial or telnet.

romankot, 2017-07-30:
Terminal doesn't show Cyrillic fonts. Should I change remote character set on putty to see Cyrillic ?

karawin, 2017-07-30:
I don't know. Only the basic char stream is sent.
See it on a browser.
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

romankot, 2017-08-02:
you see

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

karawin, 2017-08-02:
This station http://uk5.internet-radio.com:8112/live.m3u is not in cyrillic and it seems that the browser don't know the translation if possible.

karawin, 2017-08-08:
Cannot do something for that.

arlaor, 2017-08-11:
Hi @karawin

Until version 1.4.2 I was able to update the project, but with versions 1.5 and 1.5.1 does not take the changes and is maintained in version 1.4.2.
Can you add a warning next to the upgrade button, which lets you know if the project is being updated or not?
I have done the same steps for the previous updates but in version 1.5 has not taken the changes.
Thanks

karawin, 2017-08-11:
On the serial interface or telnet do a sys.update
if unsuccesfull, it is clearly written.
In this case do a sys.prerelease
Things must be right now.

arlaor, 2017-08-11:
The system Prerelease Should I do it for some special program?

karawin, 2017-08-11:
No, it is the current one for the moment. I said that because it is possible that your 1.4.2 points to a test station. (a wrong release at a moment). But try the normal update, i may have corrected it by placing a copy of the good bin.

Closed 2017-08-25.

Thread 43 (2017-07-28):

Press Play while playing should not drop sound for 2 seconds

romankot, 2017-07-28:
This could be reproduced with web  onclick="playStation()" , cli.play and hardware buttons
I believe play button while we are already listening sound should pause

karawin, 2017-07-28:
No. Play relaunch the station Stop is stop ;-)

romankot, 2017-07-30:
stop is stop. Its working fine but play should not interrupt me from listening. Try the Prev command on first
 station doesn't relaunch it , there is just no reaction

karawin, 2017-07-30:
It's a feature....

Closed 2017-08-02.

Thread 44 (2017-07-30):

After receive data to STM32 problem

ogggi, 2017-07-30:
Hello

I have problem after turning on karadio. ESP(Nodemcu) normal playing, but STM32F103(with LCD ST7735,encoder and IR) after receive signal from serial ESP, itself stop.  Led diode on STM32 not blinking,but shines and lcd it stop.
Sometimes normal working and all is good. All wires is good.

thank you for answer

karawin, 2017-07-30:
Is it the soft from https://github.com/karawin/karadio-addons ?
Not sure that it is a software problem.
If on a breadboard, check all lines and may be double the gnd and vcc.
I know that many breadboards are not very accurate (the long white from china).

ogggi, 2017-07-31:
I havent on breadboard. All wires are soldering on board.  I have one question.  How you use library freertos with stm32?

ogggi, 2017-07-31:
when I get reset on stm32 and receive data from esp ,stm32 freeze. I have two pieces stm32 and nodemcu, on both doing same.

karawin, 2017-07-31:
I use it everyday on two prototypes.
I delivered again with 1.3 release.
May I forgot to update the github.
Please reload.

karawin, 2017-07-31:
This issue is for addon, not for KaraDio itself.
Please move it.

Closed 2017-07-31.

Thread 45 (2017-08-01):

telnet sys.version doesn't work on 1.4.2

romankot, 2017-08-01:
Could not find the file with all command list (interfaces.txt) on github

karawin, 2017-08-01:
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

karawin, 2017-08-01:
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

karawin, 2017-08-01:
type
help
or see the setting panel or directly http://karadio.karawin.fr/Interface.txt

romankot, 2017-08-02:
I see nothing from sys.version. Setting on putty set exactly as you show. sys.version is not described in interfaces.txt

karawin, 2017-08-02:
Telnet negociation mode passive too?

romankot, 2017-08-02:
yes

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

karawin, 2017-08-02:
This is a new command. Be sure to be with 1.4.1 or 1.4.2 release.

romankot, 2017-08-03:
it works ! to be close

Closed 2017-08-03.

Thread 46 (2017-08-02):

Radio hangup after several telnet "cli.vol-" commands in a row

romankot, 2017-08-02:

karawin, 2017-08-02:
in a row????

romankot, 2017-08-02:
try send several vol- one after one within 2 seconds

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

karawin, 2017-08-02:
Not reproductive

romankot, 2017-08-03:
Jean, try repeat vol- fast enough with upwards arrow. It seems that telnet get overloaded with fast input and drop off session. The radio itself keeps working but telnet session must be restarted

karawin, 2017-08-03:
Not reproductive.
Tested many time. But...
Is it a telnet client problem?

romankot, 2017-08-03:
i use putty

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

romankot, 2017-08-06:
Jean, do you filter number of incoming web requests? Radio hung ups after several fast start/stop combination

karawin, 2017-08-08:
May be filtered in case of extreme load. But in many case, just delayed.
Try the 1.5 release please.

romankot, 2017-08-08:
not reproducible on 1.5 anymore. to be closed

Closed 2017-08-08.

Thread 47 (2017-08-08):

Wrong VS1053 detect

Edragon, 2017-08-08:
Hi!

The output debug info show the VS1053 detect =0, but should be 4 right? I have tried two VS1053 boards, all the same, my esp8266 board is wemos D1. Please help. thanks!

=> extraram state: 0 0xff 
Release 1.4.2, Revision 3
SDK 1.4.2(f57d61a)
data  : 0x3ffe8000 ~ 0x3ffe8930, len: 2352
rodata: 0x3ffe8930 ~ 0x3ffea4a4, len: 7028
bss   : 0x3ffea4a8 ~ 0x3fff18b0, len: 29704
heap  : 0x3fff18b0 ~ 0x40000000, len: 59216
Heap size: 30304
size_map: 4
t0 task: 3fff8b48
t1 task: 3fff8dd0
t4 task: 3fff93c8
t3 task: 3fff97b8
t2 task: 3fff9db0
t5 task: 3fffa1c8
Heap size: 22712
mode : sta(2c:3a:e8:0a:ed:b1)
add if0
SCI_Mode (0x4800) = 0x4802
SCI_Status (0x48) = 0xC
VS Version (VS1053 is 4) = 0
SCI_ClockF = 0xB000
device: 3fffabe8
volume: 0
UART READYAP1: sscz_48FD, AP2:
 AP1:Station Ip: 192.168.0.100
Trying sscz_48FD ,  I: 0 status: 1
scandone
state: 0 -> 2 (b0)
Trying sscz_48FD ,  I: 1 status: 1
state: 2 -> 3 (0)
state: 3 -> 5 (10)
add 0
aid 5
pm open phy_2,type:2 0 0
cnt

connected with sscz_48FD, channel 7
dhcp client start...
ip:192.168.0.104,mask:255.255.255.0,gw:192.168.0.1
autostart: playing:0, currentstation:0
sleep enable,type: 2
No panelADC Div: 0 from adc: 2

Edragon, 2017-08-08:
the esp8266 logic should be 3.3V, vs1053 board power is 5V, is there any logic conflict?

karawin, 2017-08-08:
A good wired vs1053b shows
SCI_Mode (0x4800) = 0x4802
SCI_Status (0x48) = 0x4C
VS Version (VS1053 is 4) = 4
SCI_ClockF = 0xB800

According to the datasheet:
SS_VER is 0 for VS1001, 1 for VS1011, 2 for VS1002, 3 for VS1003, 4 for VS1053 and VS8053, 5 for VS1033, 7 for VS1103, and 6 for VS1063.
Are you sure that you have a vs1053?

karawin, 2017-08-08:
The vs1053 power is 5v but an internal reducer is a 5v to 3.3v to power the chip.

Edragon, 2017-08-08:
I have tried a 3.3V power supplied and logic VS1053 board, connect directly to esp8266, but same error. Then I make the second test with the board you mentioned here:
http://www.ebay.fr/itm/401046111343?_trksid=p2060353.m2749.l2649&ssPageName=STRK%3AMEBIDX%3AIT

Same board but still the same error, so I guess it is a problem of my wemos D1 board. But this board should be very similar to nodemcu board you used .. Both nodemcu and wemos board has reset circuit on GPIO pin0, does it make problem?  Will try different board later and report result. Thanks!

karawin, 2017-08-08:
The vs1053 MUST be powered at 5V.

karawin, 2017-08-08:
Some uses the wemos D1 succesfully.

Edragon, 2017-08-08:
Got the issue solved, stupid :) wiring io4 and io5 swapped and read wrong.

Thanks for all the support!

Closed 2017-08-08.

Thread 48 (2017-08-22):

Playing a .wav file

alpbak, 2017-08-22:
Hi,
First of all thank you for all your efforts.

I have no problems with mp3 playing and internet radios, everything works just perfect for me. But I would like to play wav files in Ka-Radio and I seem to have a problem with that.

What I'm trying is to enter the following wav file URL into the Instant Play section of the web interface:

[http://www.wavsource.com/snds_2017-07-30_6786517629734627/movie_stars/bogart/dirty_mind.wav](http://www.wavsource.com/snds_2017-07-30_6786517629734627/movie_stars/bogart/dirty_mind.wav)

The first time I play, it plays the file. But it doesn't play the file a second time and it doesn't play any other wav files anymore.

When I restarted the system, it again plays a single wav file and stop playing any more files.

The Serial Monitor output is here:

dhcp client start...
ip:192.168.43.199,mask:255.255.255.0,gw:192.168.43.1
sleep enable,type: 2
ADC Div: 3 from adc: 13
autostart: playing:0, currentstation:0
##CLI.STOPPED# from Adc Stop
##CLI.STOPPED# from Post instant_play
##CLI.URLSET#: www.wavsource.com
##CLI.PATHSET#: /snds_2017-07-30_6786517629734627/movie_stars/bogart/dirty_mind.wav
##CLI.PORTSET#: 80
##CLI.OVOLSET#: 0
##CLI.VOL#: 160
##CLI.PLAYING# (This one is playing correctly)

##CLI.STOPPED# from once
##CLI.STOPPED# from Post instant_play
##CLI.URLSET#: www.wavsource.com
##CLI.PATHSET#: /snds_2017-07-30_6786517629734627/movie_stars/bogart/dirty_mind.wav
##CLI.PORTSET#: 80
##CLI.OVOLSET#: 0
##CLI.VOL#: 160
##CLI.PLAYING# (This one is not playing correctly even though it's the same file)

##CLI.STOPPED# from once
##CLI.STOPPED# from Post instant_play
##CLI.URLSET#: www.wavsource.com
##CLI.PATHSET#: /snds_2017-07-30_6786517629734627/movie_stars/bogart/need_dough.wav
##CLI.PORTSET#: 80
##CLI.OVOLSET#: 0
##CLI.VOL#: 160
##CLI.PLAYING# (This one is not playing correctly and this is another file)

##CLI.STOPPED# from once

Can you please recommend a solution to me or show me a hint where I can hunt down this issue.

Thanks in Advance
Alp

alpbak, 2017-08-22:
This was an internet connection issue and nothing to do with Ka-Radio. Sorry.

alpbak, 2017-08-22:
It looks like this is not an internet connection issue after hours of testing the issue still remains a mystery.

karawin, 2017-08-22:
On a telnet session or on serial type
sys.prerelease

It is an issue with the current release, i think.

alpbak, 2017-08-22:
It's on a serial type and I use the web interface to use the instant play feature.

I've stumbled upon a stranger issue while trying to solve this:

I can play this file only one time and Ka-Radio doesn't play this file again.
http://www.wavsource.com/snds_2017-07-30_6786517629734627/movie_stars/bogart/dirty_mind.wav

But if I try the following file, I can play it as many times as I want, back to back, with no problems as it's expected to be.
http://www.wavsource.com/snds_2017-07-30_6786517629734627/movie_stars/bogart/need_dough.wav

Any idea why this may be happening?

karawin, 2017-08-22:
It is the vs1053 problem.
Update to the future release with
sys.prerelease
command on the serial input.

alpbak, 2017-08-22:
I did the "sys.prerelease" and now it is "Release 1.5.3, Revision 1 SDK 1.4.2(f57d61a)" but nothing has changed the same problem continues, unfortunately.

But the real interesting point is the issue I described in my previous message that a wav file is played correctly whereas the other one causes the problem.

I think I'm stuck at this end :(

arlaor, 2017-09-13:
Hi @karawin
you can integrate the 3 options (Radio, edit, and settings) into the fixed part of the header.
When I am at the bottom of the page, I should always go back to the beginning of the page to search for these options, to navigate to another option.
Thanks

karawin, 2017-09-15:
Thanks for your suggestion.
Yes it bother me too.
But for small screen it is not a good solution.
I propose a click on the header to scroll to the top. What do you think?

arlaor, 2017-09-15:
Hi @karawin

it is a great idea to leave the main header fixed and allow the three options to be displayed with a click
thanks

karawin, 2017-11-10:
I think i can close. Reopen if needed.

Closed 2017-11-10.

Thread 49 (2017-09-17):

A small question

Edragon, 2017-09-17:
Hi!!

Do you plan to replace the external flash? SPI flash like Winbond is much more cheaper and bigger, also what is the function of the flash?

I have build the board, but play is not fluent probably because of the network, does any settings can help?

Thank you for the great project!

karawin, 2017-09-17:
The external memory is not a flash one but a RAM.
It is not mandatory and is used to improve the stream buffer for eratic reception.
Thanks for your interrest.

Edragon, 2017-09-17:
I see, it is pretty hard to get this, and expensive. Will try it, thank you again!

Closed 2017-09-17.

Thread 50 (2017-11-10):

time.nist.gov is wrongly attributed in lots of wolrdwide DNS servers

j-levy, 2017-11-10:
I noticed that the domain name **time.nist.gov** used in **ntp.c** is most of the time wrongly attributed in most of the free DNS I've tested in my country (The Netherlands), as well as in worldwide public DNS such as Google's (**8.8.8.8 / 8.8.4.4**) or OpenDNS' (**208.67.222.222 / 208.67.220.220**). Nearly all the time, they answer a wrong IP which isn't reachable, but it's not deterministic, on exceptional cases it works.
By switching for some German DNS (from Chaos Computer Club : **194.150.168.168** ) in my router, all the requests are now done correctly (tested with PING).
I am aware that it's a very personal problem (it seems that most, if not all Dutch DNS are affected, I didn't check all of them in that list : https://public-dns.info/nameserver/nl.html , and some are also affected in Germany), but some way to fix this would be :
- either putting a fixed IP in **ntp.c** for the Karadio to ping all the time the same NTP server, regardless of the DNS chain between them (for example **129.6.15.30** for **time-c-g.nist.gov** which is currently active),
- or putting a specific domain name for a specific DNS (for example, time-c-g.nist.gov )
- or allowing to enter a custom NTP server on the web page.

Solutions 1 or 2 are probably the easiest to implement, and I highly doubt that some tens of karadios over the world would take an NTP server down (that's my opinion though).

Thank you for all of your hard work !

karawin, 2017-11-10:
Right it is a problem. For esp32 I switched to pool.ntp.org and it seems much better.
I will change it too for the esp8266.
But you are right, i will think to add a command to specify the hst to use (name or ip)

karawin, 2017-11-10:
Type sys.prerelease to update and tell me...

j-levy, 2017-11-10:
After launching the update with sys.prerelease, and re-putting my old (and faulty) DNS, it seems to be working much better. Thank you for the update !

Closed 2017-12-19.

Thread 51 (2017-11-12):

No sound :(

fdman, 2017-11-12:
Hello,

I have a nodemcu v3 and VS1053, flash is ok, i think , I can open the webpage, I can select a radio and listen to it on the webpage but from the vs1053 I have no sound.
My output debug info is :

External ram not detected

uart speed: 115200
Release 1.6.2, Revision 3
SDK 1.4.2(f57d61a)
data  : 0x3ffe8000 ~ 0x3ffe88fc, len: 2300
rodata: 0x3ffe8900 ~ 0x3ffea358, len: 6744
bss   : 0x3ffea358 ~ 0x3fff1778, len: 29728
heap  : 0x3fff1778 ~ 0x40000000, len: 59528
Heap size: 30616
size_map: 4
Eeprom_start: 3e0000
Eeprom_start1: 3d0000
Flash size: 4194304
t0 task: 3fff8a10
t1 task: 3fff8c98
t2 task: 3fff92b8
t3 task: 3fff96a8
t4 task: 3fff9cf0
Heap size: 23832
mode : sta(a0:20:a6:08:d7:e0)
add if0
SCI_Mode (0x4800) = 0x4802
SCI_Status (0x48) = 0x4C
VS Version (VS1053 is 4) = 4
SCI_ClockF = 0xB800
I2S Speed: 0
device: 3fffa788
plugin size 6350 3175
plugin start: 7 1 8050 6
plugin size 234 117
plugin start: 7 1 8f00 6
volume: 131
UART READY
AP1: WiFi-2.4-00F5, AP2:
 AP1:Station Ip: 192.168.1.56
Trying WiFi-2.4-00F5 ,  I: 0 status: 1
scandone
state: 0 -> 2 (b0)
state: 2 -> 3 (0)
state: 3 -> 5 (10)
add 0
aid 4
pm open phy_2,type:2 0 0
cnt

connected with WiFi-2.4-00F5, channel 3
ip:192.168.1.56,mask:255.255.255.0,gw:192.168.1.1
sleep enable,type: 2
No panel
ADC Div: 0 from adc: 0
autostart: playing:1, currentstation:2
I2S Speed: 0
##CLI.STOPPED# from playStationInt
##CLI.NAMESET#: 2 RTL2
##CLI.URLSET#: streaming.radio.rtl.fr
##CLI.PATHSET#: /rtl2-1-44-128.m3u
##CLI.PORTSET#: 80
##CLI.OVOLSET#: 0
##CLI.VOL#: 131
##CLI.STOPPED# from C_PLIST1
##CLI.URLSET#: ais.rtl.fr
##CLI.PATHSET#: /rtl2-1-44-128
##CLI.PORTSET#: 80
##CLI.ICY0#: RTL2 [MP3 128]
##CLI.ICY3#: http:\/\/www.rtl2.fr
##CLI.ICY5#: 128
##CLI.ICY6#: RTL2 [MP3 128]
##CLI.PLAYING#

##CLI.META#:

Thank you for your help

MarcLuc, 2017-11-16:
Hi,
This might be the same issue as mentioned in issue 34.   Try a sys.erase and sys.patch("0") to see if the problem is corrected.  full link below.

https://github.com/karawin/Ka-Radio/issues/34

karawin, 2017-11-16:
sys.patch("0") is enough. May be an old vs1053. Some are seen unfortunately.

fdman, 2017-11-16:
Hello,
Thank you for your answers.
I tested the command sys.patch("0") but still no sound, I think it comes from my vs1053, I will test with another model.

Congratulations, great project, I love, even if I'm beginner with esp;) and sorry for my bad English I'm Belgian

karawin, 2017-11-17:
Est ce qu'il y a un ronflement avant l'init puis un silence ensuite?
Est ce que le jack est bien completement enfoncé?
check et recheck la connexion qui semble bonne car la carte est bien detectée et initialisée.
(I am French;-)

fdman, 2017-11-17:
Hahahaha, désolé je savais pas :p en français tout de suite c'est plus facile :)
Non pas de ronflement, j'entends juste un tic puis plus rien.
J'ai vérifié pour le jack et la connexion aussi, tout me parait bon, la vs1053 est une LC Technology , je pense qu'elle a un problème, j'ai essayé de la tester avec un arduino et pas de son non plus.
Je vais m'en procurer une autre pour être certain

fdman, 2017-12-05:
Bonjour,
Je viens de teste avec un autre VS1053 et tout est ok, c'etait bien mon VS1053 qui avait un problème :(.
J'ai testé aussi la version esp32 et impec aussi :p , je suis fan lol.
Un grand merci pour votre aide et je suis de très près le projet PCB :)

Au plaisir

karawin, 2017-12-05:
Parfait, on peut clore cet issue.
A bientot sur facebook? https://www.facebook.com/groups/162949914181385

fdman, 2017-12-05:
Oui vous pouvez fermer.
Pour ce qui est de facebook , j'y suis déja  ;) on est fan ou on ne l'est pas lol

A bientôt

Closed 2017-12-05.

Thread 54 (2017-12-22):

VS1053 not detected

gvoigtlaender, 2017-12-22:
Hey there,

Getting no AP after flashing as well, unfortunately not gone after several reboots, as well as double-checking all connections did not show up any obvious faults

I used Dimitris Saltas PCB [1] manufactured by linked OSH Park [2]. Only obvious difference is I got an ESP-12F which is not AI-Thinker [3]. So far I assembled two boards, both show same result:

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

I already tried flashing in QIO as well as DIO mode - both come up with same result.

Is there any difference between my ESP and the AI-Thinker one?
Other issues suggested disconnecting the DREQ line between ESP-12F & VS1053B, but there were no more information about if that did anything. I'm holding off that attempt as it could easily break the soldering pads.
Any suggestion what else to check?

Thanks for any help,
georg

[1] https://github.com/dsaltas/WiFi-WebRadio
[2] https://oshpark.com/shared_projects/H0BeSd2u
[3] https://de.aliexpress.com/item/Free-Shipping-10pcs-lot-ESP8266-remote-serial-Port-WIFI-wireless-module-through-walls-Wang-esp-12F/32471895953.html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

karawin, 2017-12-28:
Please give the complete log.

gvoigtlaender, 2017-12-28:
I double-checked all connections from ESP to VS, I also confired no cross-bridges between other lines of VS.

Flash binaries:
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

Flashing log:
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

Debug output, started before reset by disconnecting power to pcb
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

Any other logs I could provide?

karawin, 2017-12-28:
A normal log will show:
SCI_Mode (0x4800) = 0x4802
SCI_Status (0x48) = 0xC
VS Version (VS1053 is 4) = 0
SCI_ClockF = 0xB000
device: 3fffabe8
volume: 0

after the addi f0
If blocked here, the only answer is that the dreq line never go to 1 or 0 (don't remind) and the software loop.
I know that without vs1053, the soft continue (but no sound obviously)
Something is wrong with your vs1053.
Take a snap of the board.

karawin, 2017-12-29:
Test the dreq line connected to gpio4. It must be at level 1 3.3v)

gvoigtlaender, 2017-12-30:
Line dreq (gpio4) is 0V. Need to pull-up? I'm not so firm with electronic details ;(

I ordered material for another 3 boards which I'll assemble with AI-Thinker ESPs, going to check if they work

karawin, 2017-12-30:
At power up, the vs1053 pulls the dreq line, so I think the vs1053's weld on the dimitris board fails. Look at it with a magnifying glass and you'll be scared

gvoigtlaender, 2017-12-30:
Unfortunately while looking absolute beginner-like all welds are working - wiring test looks good, no cross-connection between adjoining legs, lines meet their counterparts. That goes for both boards I assembled.

What is working: flashing & bootup ESP, so that is at least not totally burned. When powered up I can confirm both: 3.3V & 1.8V at all vias. XDCS (GPIO5), XRESET (GPIO0), LED (GPIO2), XCS (GPIO15), CS(?) (GPIO16) are 3.3V

I'll go back to the breadboard with a ESP12-adapter-board, lets see if i can get it running without node-mcu

gvoigtlaender, 2017-12-30:
OK, on breadboard both ESPs (AI-Thinker & unknown clone) work perfect with LC Technology VS1053

Now i'll try to go on with VS1053b on lqpf48 adapter board

gvoigtlaender, 2017-12-30:
That did also not work. I only connected the supplies (GND, 3.3V@Pin32) and communication lines (MISO, MOSI, SCK, XCS, XDCS, DREQ, XRESET), still stopping after "add if0" ;(

Do I need to connect the oscillator and pull-down the GPIO{0-7}? Thought that part is not required for initial communication...

karawin, 2017-12-30:
Look at the scheme https://github.com/dsaltas/WiFi-WebRadio/blob/master/WiFiRadio.pdf
The vs1053 needs all parts.
If the dreq line is not high, the software cannot run and loop waiting dreq.

gvoigtlaender, 2017-12-30:
OK, that's gonna take a while, need to get all parts as through-hole components.

I'm going to file my mouser order list later, maybe someone will find some failure in there

gvoigtlaender, 2017-12-30:
Here is the order list of mouser, maybe someone has time to confirm against https://github.com/dsaltas/WiFi-WebRadio/blob/master/BOM.pdf , same sequence, without EPS & VS1053

Mouser No: 667-ERJ-6ENF1202V
Mfr. No: ERJ-6ENF1202V
Desc.:
Thick Film Resistors - SMD Thick Film Resistors - SMD 0805 12Kohms 1% AEC-Q200

Mouser No: 652-CR0805FX-1004ELF
Mfr. No: CR0805-FX-1004ELF
Desc.:
Thick Film Resistors - SMD Thick Film Resistors - SMD 1M 1%

Mouser No: 603-RC0805FR-07100KL
Mfr. No: RC0805FR-07100KL
Desc.:
Thick Film Resistors - SMD Thick Film Resistors - SMD 100K OHM 1%

Mouser No: 603-RC0805FR-07470RL
Mfr. No: RC0805FR-07470RL
Desc.:
Thick Film Resistors - SMD Thick Film Resistors - SMD 470 OHM 1%

Mouser No: 652-CR0805FX-4702ELF
Mfr. No: CR0805-FX-4702ELF
Desc.:
Thick Film Resistors - SMD Thick Film Resistors - SMD 47K 1%

Mouser No: 603-RC0805FR-0710KL
Mfr. No: RC0805FR-0710KL
Desc.:
Thick Film Resistors - SMD Thick Film Resistors - SMD 10K OHM 1%

Mouser No: 603-RC0805FR-0720KL
Mfr. No: RC0805FR-0720KL
Desc.:
Thick Film Resistors - SMD Thick Film Resistors - SMD 20K OHM 1%

Mouser No: 652-CR0805FX-20R0ELF
Mfr. No: CR0805-FX-20R0ELF
Desc.:
Thick Film Resistors - SMD Thick Film Resistors - SMD 20ohm 1%

Mouser No: 81-GRM21BC81C106KE5K
Mfr. No: GRM21BC81C106KE15K
Desc.:
Multilayer Ceramic Capacitors MLCC - SMD/SMT Multilayer Ceramic Capacitors MLCC - SMD/SMT 0805 10uF 16volts *Derate Voltage/Temp

Mouser No: 80-C0603C104K5R
Mfr. No: C0603C104K5RACTU
Desc.:
Multilayer Ceramic Capacitors MLCC - SMD/SMT Multilayer Ceramic Capacitors MLCC - SMD/SMT 50volts 0.1uF X7R 10%

Mouser No: 80-C0805C332K5RAC
Mfr. No: C0805C332K5RAC
Desc.:
Multilayer Ceramic Capacitors MLCC - SMD/SMT Multilayer Ceramic Capacitors MLCC - SMD/SMT 50volts 3300pF 10% X7R

Mouser No: 647-UKA1C221MED
Mfr. No: UKA1C221MED
Desc.:
Aluminium Electrolytic Capacitors - Leaded Aluminium Electrolytic Capacitors - Leaded 16Volts 220uF 20% Tol.

Mouser No: 80-C0805C220J5G
Mfr. No: C0805C220J5GACTU
Desc.:
Multilayer Ceramic Capacitors MLCC - SMD/SMT Multilayer Ceramic Capacitors MLCC - SMD/SMT 50volts 22pF C0G 5%

Mouser No: 81-GRM40X103K50D
Mfr. No: GRM216R71H103KA01D
Desc.:
Multilayer Ceramic Capacitors MLCC - SMD/SMT Multilayer Ceramic Capacitors MLCC - SMD/SMT 0805 0.01uF 50volts X7R 10%

Mouser No: 81-GRM21R61C105KA01L
Mfr. No: GRM21BR61C105KA01L
Desc.:
Multilayer Ceramic Capacitors MLCC - SMD/SMT Multilayer Ceramic Capacitors MLCC - SMD/SMT 0805 1uF 16volts X5R 10%

Mouser No: 81-BLM18PG221SN1D
Mfr. No: BLM18PG221SN1D
Desc.:
Ferrite Beads Ferrite Beads 220ohms

Mouser No: 579-23LC1024-I/SN
Mfr. No: 23LC1024-I/SN
Desc.:
SRAM SRAM 1024K 2.5V SPI SERIAL SRAM SQI

Mouser No: 579-MCP1703AT1802ECB
Mfr. No: MCP1703AT-1802E/CB
Desc.:
LDO Voltage Regulators LDO Voltage Regulators LOW Iq, High Vin LDO 1.8V, SOT-23A

Mouser No: 579-MCP1703AT3302ECB
Mfr. No: MCP1703AT-3302E/CB
Desc.:
LDO Voltage Regulators LDO Voltage Regulators LOW Iq, High Vin LDO 3.3V, SOT-23A

Mouser No: 815-ABL-12.288-B2
Mfr. No: ABL-12.288MHZ-B2
Desc.:
Crystals Crystals +/-20ppm 12.288MHz FUNDAMENTAL

Mouser No: 688-SKQGAD
Mfr. No: SKQGADE010
Desc.:
Tactile Switches Tactile Switches 5.2x5.2x1.5mm 260gf

Mouser No: 806-STX-3100-5N
Mfr. No: STX-3100-5N
Desc.:
Phone Connectors Phone Connectors 3.5mm PCB STEREO BLK 5P W/SWITCH

Closed 2019-02-16.

Thread 55 (2017-12-24):

edit several stations radio fail

arlaor, 2017-12-24:
Hi @karawin
when trying to edit several radio stations, the page is disconnected from the project and I lose control.
Please allow support for stations of the type:
http://hot.friezy.ru/?radio=di&station=bassnjackinhouse&bitrate=128

Thanks

karawin, 2017-12-25:
What is the problem with the radio?
Bass & Jackin' House - Digitally Imported Premium  
It works well here.

And the edit don't disconnect when i test it for a lot of radio.

arlaor, 2017-12-27:
Hi @karawin

The problem is this: when I play the station from INSTANT PLAY, I have no problem, but when I load the list of stations with the station stored in the list, the project shows the following information

URL STATION on INSTANT PLAY
Header: Moved
##CLI.STOPPED# from C_HDER
##CLI.URLSET#: prem2.di.fm
##CLI.PATHSET#: /bigroomhouse?d97b84c0668de93f41871fb3
##CLI.PORTSET#: 80
##CLI.ICY0#: Big Room House - Digitally Imported Premium
##CLI.ICY1#: <BR>This stream requires <a href=\"http:\/\/www.winamp.com\/\">Winamp<\/a><BR>
##CLI.ICY2#: SHOUTcast Distributed Network Audio Server\/Linux v1.9.8<BR>
##CLI.ICY3#: http:\/\/www.di.fm
##CLI.ICY4#: House Big Tech
##CLI.ICY5#: 128
##CLI.PLAYING#
AND...
URL FROM LIST SAVED AND LOAD
##CLI.META#: David Guetta Feat. Nicki Minaj - Turn Me On (Michael Calfan Remix)
Warning eebuf malloc low memory
##CLI.STOPPED# from playStationInt
##CLI.NAMESET#: 166 CLUBHITS DI.FM
##CLI.URLSET#: hot.friezy.ru
##CLI.PATHSET#: /?radio=di
##CLI.PORTSET#: 80
##CLI.OVOLSET#: 0
##CLI.VOL#: 98
After this, it does not respond until the reset button is pressed

please generate list webradio for probe
{"Name":"00srock (RR) aac 128 kbps","URL":"hot.friezy.ru","File":"/?radio=rr&station=00srock&bitrate=128","Port":"80","ovol":"0"}
{"Name":"80 HotMixRadio (80's) mp3 128 kbps","URL":"streaming.hotmix-radio.net","File":"/hotmixradio-80-128.mp3","Port":"80","ovol":"0"}
{"Name":"80srock (RR) aac 128 kbps","URL":"hot.friezy.ru","File":"/?radio=rr&station=80srock&bitrate=128","Port":"80","ovol":"0"}
{"Name":"80srock (RT) aac 128 kbps","URL":"hot.friezy.ru","File":"/?radio=rt&station=80srock&bitrate=128","Port":"80","ovol":"0"}
{"Name":"90srock (RR) aac 128 kbps","URL":"hot.friezy.ru","File":"/?radio=rr&station=90srock&bitrate=128","Port":"80","ovol":"0"}
{"Name":"alternative80s (RR) aac 128 kbps","URL":"hot.friezy.ru","File":"/?radio=rr&station=alternative80s&bitrate=128","Port":"80","ovol":"0"}
{"Name":"alternativerock (RR) aac 128 kbps","URL":"hot.friezy.ru","File":"/?radio=rr&station=alternativerock&bitrate=128","Port":"80","ovol":"0"}
{"Name":"altrock (RT) aac 128 kbps","URL":"hot.friezy.ru","File":"/?radio=rt&station=altrock&bitrate=128","Port":"80","ovol":"0"}
{"Name":"Antena 2 aac 32 kbps","URL":"live3.rcnmundo.com","File":"/antena2.aac","Port":"80","ovol":"0"}
{"Name":"Blu Musica (Pop) mp3 64 kbps","URL":"14073.live.streamtheworld.com","File":"/MUSICABLU.mp3","Port":"3690","ovol":"50"}
{"Name":"Blu Radio mp3 64 kbps","URL":"20323.live.streamtheworld.com","File":"/BLURADIO.mp3","Port":"80","ovol":"0"}
{"Name":"Cadena Dial (Pop Latino) mp3 128 kbps","URL":"20423.live.streamtheworld.com","File":"/CADENADIAL.mp3","Port":"80","ovol":"0"}

karawin, 2017-12-27:
Ok now, update and restore stations to the webradio.
Thanks

I will update KaRadio32 too soon.

arlaor, 2017-12-27:
Hi @karawin
Excellent update
Now work AUTOPLAY too
Thanks.

karawin, 2017-12-28:
AUTOPLAY was working a while ago now.
Ok, i close it

arlaor, 2017-12-28:
Hi @karawin
Excuse me
I have noticed that AUTOPLAY only works for me with some radio stations and apparently they are the ones that are broadcast in AAC format.
When the radio station with which you must start this in MP3 format, AUTOPLAY does not work
message is
##CLI.STOPPED# from Adc Stop

karawin, 2017-12-28:
ADC stop means that the ADC input detected a level. If you don't use a control panel, the adc must be grounded.

arlaor, 2017-12-28:
hi @karawin
I have connected A0 to GND and I have observed the following: when I select a station in mp3 from the drop-down list and play it, without pressing the PLAY STATION button and restart the hardware, it generates the message ADC STOP.
But in another test, when I press the PLAY STATION button to play the station and after a moment I restart the hardware, the radio station starts correctly when the hardware is turned on, without generating ADC STOP message.

karawin, 2017-12-28:
Trust me, the only origin of the message is from the ADC read.
If the A0 input is grounded you must see a message in the beginning of the log with adcdiv value of 0
kprintf(PSTR("ADC Div: %d from adc: %d\n"),adcdiv,ap);
If >0 then the board is falling and the only solution is to ground the esp8266 adc pin to ground.
Some low cost boards have failing divisor resistors.

arlaor, 2017-12-28:
hi @karawin

it is correct, of three board esp8266, only one works correctly with A0 connected to GND,
No panel
ADC Div: 0 from adc: 3
 the others show ADC DIV 3 from ADC: 11

Closed 2017-12-28.

Thread 56 (2018-01-28):

wifi bridge between  landline phone and  mobile

mkeyno, 2018-01-28:
Sorry to open a ticket for my question , actually I intend to make ESP8266 wifi bridge between my landline phone and my mobile , I've look for sufficient hardware for ADC at most 8bit bit stream and then use UDP to deliver audio package to mobile , also I've consider DFMT IC to dial or respond pulse tone . My problem is I don't have analog  design skill to find min and max specification needed for this project  , I don't know  how to select   analog circuits or Audio  codec IC's among plenty of possible options  for this matter and your advise really appreciated

karawin, 2018-02-02:
A bit far of the KaRadio project. May be try to find a group on facebook to ask your question.
https://www.facebook.com/groups/1499045113679103/

Closed 2018-02-08.

Thread 59 (2018-03-26):

No Sound

pilnikov, 2018-03-26:
Hello JPC. By all indications (log - ok!) must be play, but not sing. There are thoughts that the initialization of VS1053 does not pass correctly, because SPI speed is to high. Is it possible to set a low SPI speed at 0.2 MHz instead of 2 MHz?
Thank you.
Log:
SCI_Mode (0x4800) = 0x4802
SCI_Status (0x48) = 0x4C
VS Version (VS1053 is 4) = 4
SCI_ClockF = 0xB800

P.S. I checked the board with the Arduino library - everything works.

karawin, 2018-05-22:
The init of the vs or any command are done in low speed and the data transfer for the song are done in higher speed according to the specs.
So i don't think it is the problem.

pilnikov, 2018-05-22:
usually it happens on "blue" boards, with "red" problems less.
Can be where that is a comparison of the circuits of these boards?

karawin, 2018-09-16:
No news.
Closed but reopen if still valid

Closed 2018-09-16.

Thread 60 (2018-05-19):

Stop-Start gets invalid volume, no sound until sending volume command

j-levy, 2018-05-19:
I noticed that, randomly, when I start playing, either with `cli.start` or with the play button on the website, it starts playing but no sound comes out. Using `cli.vol` I noticed that the volume reported is in the range of an unit16, and close to the max (I get 65532). I didn't expect that since I though it was in the range of uint8. Additionally, the volume reported when starting to play is OK (I guess it does something like cli.info when it starts); BUT it differs from the one reported by `cli.vol` and `cli.info` when you write these commands afterwards.
When changing the volume with `cli.vol+` or by moving the cursor in the website, it seems to get back on track, and sound comes out.
I have to tell that this problem didn't happen before, but I had to change my VS1053 board for another one. Previously I had [this board](https://fr.aliexpress.com/item/Free-shipping-VS1053-MP3-recording-module-development-board-on-board-recording-function/32223062819.html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), and now, I have [this one](https://fr.aliexpress.com/item/VS1053-MP3-Module-Development-Board-w-On-Board-Recording-Function-SPI-Interface/1893615339.html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). Could the problem related to the different board ?

See below what I get from the command line.

```
##CLI.STOPPED# from cli stop
#INFO:""#
##CLI.STOPPED# from playStationInt
##CLI.NAMESET#: 0 Tsumugi
##CLI.URLSET#: shelter.mahoro-net.org
##CLI.PATHSET#: /tsumugi.m3u
##CLI.PORTSET#: 8000
##CLI.OVOLSET#: 4
##CLI.VOL#: 155
##CLI.URLSET#: shelter.mahoro-net.org
##CLI.PATHSET#: /tsumugi
##CLI.PORTSET#: 8000
##CLI.STOPPED# from C_PLIST
##CLI.ICY0#: Tsumugi
##CLI.ICY3#: http:\/\/tsumugi.forum-thalie.fr
##CLI.ICY4#: anime
##CLI.ICY5#: 192
##CLI.ICY6#: Stream 192Kbps
##CLI.ICY7#:  channels=2;samplerate=44100;bitrate=192
##CLI.PLAYING#
##CLI.META#: Yoko Shimomura - The Edge of Green
cli.vol

##CLI.VOL#: 65532
> ##CLI.META#: Jingle Tsumugi - OH MY GOD
##CLI.META#: DAOKO×Yasuyuki Okamura - Step Up LOVE
cli.vol-

##CLI.VOL#: 155
```

karawin, 2018-05-22:
Seems that the register on the vs103 is not well read.

Closed 2018-09-16.

Thread 62 (2018-06-03):

Re: addons

Alnoor55, 2018-06-03:
cannot complile karadioUCSTM32 due to missing library MapleFreeRTOS.h and wirish.h

karawin, 2018-06-11:
With stm32duino installed?

Closed 2018-09-16.

Thread 64 (2018-06-21):

Control Ka-radio via UART ???

thanhnc-iot, 2018-06-21:
Dear sir,
In some cases, I need to monitor and control this board continuously while the unstable wifi connection.
Also, I need the function to play the next link when current link is no active.

karawin, 2018-06-23:
http://karadio.karawin.fr/Interface.txt

thanhnc-iot, 2018-06-26:
Thank sir.
I'd to modify and conpile this project in Windows OS, but I can not find out any IDE can do that, please help.
Tks in advance.

karawin, 2018-06-27:
I don't use an ide.
Only https://notepad-plus-plus.org/
and https://docs.espressif.com/projects/esp-idf/en/latest/get-started/windows-setup.html

Closed 2018-09-12.

Thread 65 (2018-07-15):

Ka-Radio software Bug

zsoltyfm, 2018-07-15:
Dear KaraWin!

He did a great job!
I use Wemos D1.
Sometimes the radio does not sound and the web page is unavailable.
However, this is related to wifi. In this case, the LED blinks in the same way when everything is OK. In this case, I press the reset button and everything restarts. The radio loads the radio station from the list but the volume does not load. The default remains. The volume sliders do not work properly. The website does not appear in the GUI if you change the volume from anywhere. After updating your site. The slider does not follow the value set in the machine.

zsoltyfm, 2018-07-16:
If it does not reach the radio station, it freezes. Connects to the wifi network but does not load your site either. You need to restore it to work again.

zsoltyfm, 2018-07-16:
I measured. The radio will stop every time after 36 and a half minutes. must be restored.
I'm listening to this: http://79.172.241.238:8000/musicfm.mp3

karawin, 2018-07-22:
Time to time I have a try restart in the log for this station.
Try restart means that the stream stopped to be received.
KaraDio try to reopen the stream.

karawin, 2018-09-16:
No news.
Closed but reopen if still valid

Closed 2018-09-16.

Thread 68 (2018-11-13):

Compile with esp-open-rtos

h1aji, 2018-11-13:
I have found a project with advanced libraries.  https://github.com/SuperHouse/esp-open-rtos

Is it possible to make Ka-radio working with it?

karawin, 2018-11-19:
May be. It is derived from the espressif esp.
But no time to test it.

h1aji, 2018-12-05:
I am trying to compile it and seeing this error:
```
/home/murad.ustarkhanov/esp/esp-open-rtos/examples/Ka-radio/interface.c: In function 'wifiScanCallback':
/home/murad.ustarkhanov/esp/esp-open-rtos/examples/Ka-radio/interface.c:281:23: error: dereferencing pointer to incomplete type
    bss_link = bss_link->next.stqe_next;
                       ^
/home/murad.ustarkhanov/esp/esp-open-rtos/examples/Ka-radio/interface.c:283:42: error: dereferencing pointer to incomplete type
    sprintf(buf, "\n%s;%d;%d;%d", bss_link->ssid, bss_link->channel, bss_link->rssi, bss_link->authmode);
                                          ^
/home/murad.ustarkhanov/esp/esp-open-rtos/examples/Ka-radio/interface.c:283:58: error: dereferencing pointer to incomplete type
    sprintf(buf, "\n%s;%d;%d;%d", bss_link->ssid, bss_link->channel, bss_link->rssi, bss_link->authmode);
                                                          ^
/home/murad.ustarkhanov/esp/esp-open-rtos/examples/Ka-radio/interface.c:283:77: error: dereferencing pointer to incomplete type
    sprintf(buf, "\n%s;%d;%d;%d", bss_link->ssid, bss_link->channel, bss_link->rssi, bss_link->authmode);
                                                                             ^
/home/murad.ustarkhanov/esp/esp-open-rtos/examples/Ka-radio/interface.c:283:93: error: dereferencing pointer to incomplete type
    sprintf(buf, "\n%s;%d;%d;%d", bss_link->ssid, bss_link->channel, bss_link->rssi, bss_link->authmode);
                                                                                             ^
/home/murad.ustarkhanov/esp/esp-open-rtos/examples/Ka-radio/interface.c: In function 'wifiGetStation':
/home/murad.ustarkhanov/esp/esp-open-rtos/examples/Ka-radio/interface.c:385:24: error: storage size of 'cfgg' isn't known
  struct station_config cfgg;
                        ^

```

Would you be able to assist fixing it?

karawin, 2018-12-05:
The adaptation to esp-open-rtos is not as easy as a simple compilation. You need to take into account the new include and structures of the sdk.
In this case, it seems that struct bss_info is not the same.
Idem for struct station_config

If interface.c is the first file compiled, you will find many other "problems" like these.
And as I told you: no time to help, because I don't know this sdk and don't want to load it.
Good luck.

h1aji, 2020-05-09:
Hi @karawin
I finally managed to try to compile karadio with esp-open-rtos hoping new build will allow me to play bitrates higher than 64kbit/s

Would you be able to have a look at my repo - https://github.com/h1aji/karadio and fix the errors?
I am not very experienced with C. I would really appreciate your help.

h1aji, 2020-05-09:
Or maybe somebody else here could assist ...

pilnikov, 2020-05-09:
https://github.com/pilnikov/adf/tree/master/esp-adf/examples/Ka_mod
try........

h1aji, 2020-05-11:
@pilnikov это для карадио32?
Я справился с ошибками которые были связаны с sdk. Остаются только синтаксические. Я не программист и не могу разобраться.
Например:
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

Могли бы вы глянуть?

pilnikov, 2020-05-12:
Я свой релиз делал для карадио32.
Для простого кардио собирал мод очень давно. Через компиляцию в линуксе. Сейчас уже не помню как. И желания нет повторять этот адов костыль. Инструментария ноль. А ковыряться текстовым редактором да еще без возможности тестовой сборки - это сами понимаете не лучшее занятие. Так что увы.

h1aji, 2020-05-25:
@pilnikov Я более менее разобрался со сборкой. Отключил ОТА, теперь все собирается только крэшится на плате. Похоже, что это тупик, так как я не разбираюсь в коде.
Кстати, можно использовать VS code.
А вообще, думается, надо портировать код от ka-radio32 на новый SDK. Я был бы готов тестировать, только кому это интересно? ...

pilnikov, 2020-05-25:
мой релиз для карадио **32** и он на новой idf **4.1**

pilnikov, 2020-05-25:
для простого карадио не очень интересно ввиду отсутствия свободных IO и ограниченностью ресурсов для подключения внешней периферии.

h1aji, 2021-06-09:
@pilnikov Недавно нашел esp-12f и собрал его с зеленой vs1053, i2c lcd 2004 и IR приемником. Все что надо на борту имеется. а дополнительную переферию можно через ардуино соединять если надо.
Пока собрал по такой схеме и залил esp-radio, но проблема с затыками на высоких битрейтах
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

По хорошему karadio надо переводить на esp-open-rtos там уже реализованы вебсокет и веб сервер

h1aji, 2021-06-09:
ESP SDK 1 and 2 are dead now
@karawin I have made this project buildable in my fork here https://github.com/h1aji/karadio and would be keen to test if you continue.
Would you be able to give it a go? I mentioned how to compile in the readme, its very easy
I use VScode for editing.

Closed 2023-05-10.

Thread 69 (2018-11-16):

gpio16.c filename

h1aji, 2018-11-16:
Looking at the code I found that GPIO16 is actually used for SRAM connection. Wouldnt be correct to rename the file to gpio.c or led.c Something that makes sense and not misleading.

karawin, 2018-11-19:
It is historical. You are right. The name is obsolete.

Closed 2019-02-16.

Thread 72 (2018-12-18):

XRST connect to RST pin

h1aji, 2018-12-18:
Is it ok to connect XRST from VS1053 to RST pin on ESP8266?

I have tested it and it works

karawin, 2018-12-21:
Yes why not. we don't need to reset the vs1053 independently.

Closed 2019-02-16.

Thread 73 (2019-01-08):

Compile "karadioUCSTM32"

konzolec, 2019-01-08:
I'm trying to connect b/w oled to karadio but i'm stuck at compiling

karadioUCSTM32: A complete interface with a color lcd, IR sensor, encoder knob. Based on a low cost STM32 board.

I always get the following error, and have no idea how to solve it.

`Arduino: 1.8.7 (Windows 10), Board: "Generic STM32F103C series, STM32F103C8 (20k RAM. 64k Flash), STM32duino bootloader, 72Mhz (Normal), Smallest (default)"

WARNING: library U8glib claims to run on (avr, sam) architecture(s) and may be incompatible with your current board which runs on (STM32F1) architecture(s).
C:\Users\Marko-TEST\Documents\Arduino\portable\sketchbook\karadioU8STM32\karadioU8STM32.ino: In function 'void setup()':

karadioU8STM32:341:76: error: invalid conversion from 'uint8_t (*)(u8g_t*, uint8_t, uint8_t, void*) {aka unsigned char (*)(_u8g_t*, unsigned char, unsigned char, void*)}' to 'uint8_t {aka unsigned char}' [-fpermissive]

 U8GLIB_SSD1306_128X64 u8g((u8g_com_fnptr)u8g_com_hw_i2c_fn,U8G_I2C_OPT_NONE);

                                                                            ^

In file included from sketch\u8glibConf.h:8:0,

                 from C:\Users\Marko-TEST\Documents\Arduino\portable\sketchbook\karadioU8STM32\karadioU8STM32.ino:33:

C:\Users\Marko-TEST\Documents\Arduino\libraries\U8glib\src/U8glib.h:864:5: error:   initializing argument 1 of 'U8GLIB_SSD1306_128X64::U8GLIB_SSD1306_128X64(uint8_t, uint8_t, uint8_t)' [-fpermissive]

     U8GLIB_SSD1306_128X64(uint8_t cs, uint8_t a0, uint8_t reset = U8G_PIN_NONE)

     ^

exit status 1
invalid conversion from 'uint8_t (*)(u8g_t*, uint8_t, uint8_t, void*) {aka unsigned char (*)(_u8g_t*, unsigned char, unsigned char, void*)}' to 'uint8_t {aka unsigned char}' [-fpermissive]

This report would have more information with
"Show verbose output during compilation"
option enabled in File -> Preferences.
`

Closed 2019-01-08.

Thread 74 (2019-01-08):

Stuck at compiling "karadioU8STM32"

konzolec, 2019-01-08:
I'm trying to connect b/w oled to karadio but i'm stuck at compiling.

karadioU8STM32: A complete interface with an oled B/W lcd, IR sensor, encoder knob. Based on a low cost STM32 board.

I always get the following error, and have no idea how to solve it.

`Arduino: 1.8.7 (Windows 10), Board: "Generic STM32F103C series, STM32F103C8 (20k RAM. 64k Flash), STM32duino bootloader, 72Mhz (Normal), Smallest (default)"

WARNING: library U8glib claims to run on (avr, sam) architecture(s) and may be incompatible with your current board which runs on (STM32F1) architecture(s).
C:\Users\Marko-TEST\Documents\Arduino\portable\sketchbook\karadioU8STM32\karadioU8STM32.ino: In function 'void setup()':

karadioU8STM32:341:76: error: invalid conversion from 'uint8_t (*)(u8g_t*, uint8_t, uint8_t, void*) {aka unsigned char (*)(_u8g_t*, unsigned char, unsigned char, void*)}' to 'uint8_t {aka unsigned char}' [-fpermissive]

 U8GLIB_SSD1306_128X64 u8g((u8g_com_fnptr)u8g_com_hw_i2c_fn,U8G_I2C_OPT_NONE);

                                                                            ^

In file included from sketch\u8glibConf.h:8:0,

                 from C:\Users\Marko-TEST\Documents\Arduino\portable\sketchbook\karadioU8STM32\karadioU8STM32.ino:33:

C:\Users\Marko-TEST\Documents\Arduino\libraries\U8glib\src/U8glib.h:864:5: error:   initializing argument 1 of 'U8GLIB_SSD1306_128X64::U8GLIB_SSD1306_128X64(uint8_t, uint8_t, uint8_t)' [-fpermissive]

     U8GLIB_SSD1306_128X64(uint8_t cs, uint8_t a0, uint8_t reset = U8G_PIN_NONE)

     ^

exit status 1
invalid conversion from 'uint8_t (*)(u8g_t*, uint8_t, uint8_t, void*) {aka unsigned char (*)(_u8g_t*, unsigned char, unsigned char, void*)}' to 'uint8_t {aka unsigned char}' [-fpermissive]

This report would have more information with
"Show verbose output during compilation"
option enabled in File -> Preferences.
`

vet20, 2022-06-19:
Hello! same error, what library did you use? I use u8glibConf.h in karadioU8STM32 folder.

Closed 2019-01-09.

Thread 77 (2019-03-11):

Station edit not working

nlovrens, 2019-03-11:
Hi,

In 1.9.0 R0 it is not possible to edit stations using web GUI. Also, if all stations are deleted using "Erase all" it is not possible to add stations. Import using txt file is working. Tested with chrome and firefox.

Thank you

karawin, 2019-03-12:
Yes sorry, a little mistake.
Corrected now.
Update again please.
Thanks

nlovrens, 2019-03-12:
Hi, yes, edit of the station is working now. There is still an issue if you delete all stations, then it is not possible to add stations with the GUI because list is missing and there is no "Edit" button to push (screenshot attached).

Thanks
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

karawin, 2019-03-12:
Yes again. Thanks.
Ok now

Closed 2019-04-10.

Thread 78 (2019-05-13):

Hard lags during playing.

Sera26, 2019-05-13:
Dear All,

Playing of radio stations are lagging strongly, the streams are unpalatable.
I have already removed control buttons (ADC and GND bridged) and STM32+LCD but radio can't play stations continuously.
What can be the problem?

karawin, 2019-05-16:
SHow the serial log.

karawin, 2019-05-18:
Please update again. I modified the lwip lib.

Sera26, 2019-05-18:
OK, thank you for help. By the way log doesn't show any mistake. Now it seems to be fine.

karawin, 2019-05-18:
No error, just a network configuration  for some providers.

karawin, 2019-05-26:
Tuned again. Please update.

Sera26, 2019-05-26:
It seems much better. Thank you for help.

Closed 2019-05-26.

Thread 80 (2019-08-25):

VS1053b AAC & WMA internal frequency is too high

enjoyneering, 2019-08-25:
`VS1053_WriteRegister(SPI_CLOCKF,0xB8,0x00); // SC_MULT = x1, SC_ADD= x1`

Because all VS1053 registers are 16-bit the SPI_CLOCKF nuber is 0xB800=0b1011 1000 0000 0000 where 15..13-bits is clock multiplier, 12..11-bits addition to multiplier (see p.43):

SC_MULT=1010 0000 0000 0000=0xA000= x4.0 not x1
SC_ADD=0b0001 1000 0000 0000=0x1800= x2.0 not x1

The equation for internal clock CLKI at **normal speed**: CLKI = XTALI x SC_MULT = 12.288 x 4.0 = 49.152MHz. It is OK, because the maximum VS1053 frequency is 55.3MHz (see. p7)
But when chip is trying to decode AAC & WMA it automatically choose to use addition to multiplier SC_ADD. The equation for internal clock at **boost speed**: CLKI = XTALI x (SC_MULT + SC_ADD) = 12.288 x (4.0 + 2.0)=73.728MHz with recommended maximum  55.3MHz

Recommended SC_MULT=x3.5, SC_ADD=x1 (SCI_CLOCKF=0x8800)

`VS1053_WriteRegister(SPI_CLOCKF,0xB88,0x00); // SC_MULT = x3.5, SC_ADD= x1`

Do not forget your SDI speed is CLKI / 4 = 49.152 / 4=12.288MHz & SCI speed is CLKI / 7 = 49.152 / 7=7.02MHz

karawin, 2019-08-25:
ok thanks. i will modify it.

karawin, 2019-08-25:
You mean
VS1053_WriteRegister(SPI_CLOCKF,0xB8,0x80); // SC_MULT = x3.5, SC_ADD = x1

enjoyneering, 2019-08-25:
Yes. But 0x88, 00 will work only for  12.288MHz crystal oscillator. The full equation for different crystals is more complicated & you have to change 2 registers.

I'm working on new VS1053 driver for your awesome project. Will share it some time next month.

P.S. The VS1053 can work with crystal oscillator 12-13MHz & 24-26MHz with some limitations. The recommend frequency is 12.288MHz. It gives you the highest sample rate 48KHz=12.288/256

Thread 81 (2019-12-22):

Arduino ADC keyboard (red one with yellow buttons)

diver321, 2019-12-22:
Hi,
I bought the arduino ADC keyboard like this:
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

and only one button is working - the UP  button for changing the volume up (actually good...) so i wanna (if it is possible) to try change the settings (analog readings) in code. If it is possible where can i change those settings?

Thank You.

diver321, 2019-12-23:
Ok, i figured out by myself:
For using this red arduino keyboard you need to connect it to 3.3V pin (GND and signal to ADC pin of your choice of course) and change some things in "Adc read: keyboard buttons" section of addon.c file (before compilation):
1. in adcInit() change adc detection range - attenuation (ADC_ATTEN_DB_11) to full-scale voltage 3.9 V
2. edit adcLoop() like this:
void adcLoop() {
	uint32_t voltage,voltage0,voltage1;
	bool wasVol = false;
	if (channel == GPIO_NONE) return;  // no gpio specified

	voltage0 = (adc1_get_raw(channel)+adc1_get_raw(channel)+adc1_get_raw(channel)+adc1_get_raw(channel))/4;
	vTaskDelay(1);
	voltage1 = (adc1_get_raw(channel)+adc1_get_raw(channel)+adc1_get_raw(channel)+adc1_get_raw(channel))/4;
//	printf ("Volt0: %d, Volt1: %d\n",voltage0,voltage1);
	voltage = (voltage0+voltage1)*105/(819);
//	if (voltage <  40) return; // no panel  NEEDED TO COMMENT OUT FOR 5Key board
//	printf("Voltage: %d\n",voltage);

	if (inside&&(voltage0 > 3700))
	{
		inside = false;
		wasVol = false;
		return;
	}
	if (voltage0 > 3700)
	{
		wasVol = false;
	}
	if ((voltage0 >3700) || (voltage1 >3700)) return; // must be two valid voltage

	if (voltage < 985) ESP_LOGD(TAG,"Voltage: %i",voltage);
		printf("VOLTAGE: %d\n",voltage);
	if ((voltage >90) && (voltage < 140)) // volume +
	{
		setRelVolume(+5);
		wasVol = true;
		ESP_LOGD(TAG,"Volume+ : %i",voltage);
	}
	else if ((voltage > 250) && (voltage < 300)) // volume -
	{
		setRelVolume(-5);
		wasVol = true;
		ESP_LOGD(TAG,"Volume- : %i",voltage);
	}
		else if ((voltage > 420) && (voltage < 520)) // station+
		{
			if (!wasVol)
			{
				evtStation(1);
				ESP_LOGD(TAG,"station+: %i",voltage);
			}
		}
		else if ((voltage == 0) && (voltage < 10)) // station-
		{
			if (!wasVol)
			{
				evtStation(-1);
				ESP_LOGD(TAG,"station-: %i",voltage);
			}
		}
	if (!inside)
	{
		if  ((voltage >2000) && (voltage < 3000)) // toggle time/info  old stop  NOT NEEDED FOR 5Key board
		{
			inside = true;
			toggletime();
			ESP_LOGD(TAG,"toggle time: %i",voltage);
		}
		else if ((voltage >700) && (voltage < 770)) //start stop toggle   old start
		{
			inside = true;
			startStop();
			ESP_LOGD(TAG,"start stop: %i",voltage);
		}

	}
}

This worked with mine keyboard and maybe for yours will too. If not, read the values in serial monitor by pressing the keys and correct the section ranges.

karawin, 2019-12-31:
well done, but it is for KaRadio32.

Thread 82 (2020-01-15):

mp3 stream not correct playing VBR / Surround / CBR ?

skvarovski, 2020-01-15:
Dear developer, thank your for KaRadio.

i use NodeMCU + VS1053b

i found bug on my many station where stream not correct playing

for example russian radio station:
http://radio.dline-media.com/ppr_90.mp3 - 99% music
http://orfeyfm.hostingradio.ru:8034/orfeyfm128.mp3 - music OK, when speak announced future track people - bad.

may be its bug for VBR mp3 stream ?

upd.
it seems like the packages are lost and the quality is cut off. only high sounds are heard, and when the announcer speaks, he is not heard.

He began to understand, my torrent heavily loaded the Internet channel, although there were no such problems from the computer.

Does it look like some packages do not reach the device?

skvarovski, 2020-01-16:
i found solution 👍
if your JACK 3.5 mm not correct plugin - you have a bad Sound  and saw stream!

Closed 2020-01-16.

Thread 83 (2020-02-20):

Freezes on  bad playlist urls

andykarpov, 2020-02-20:
Sometimes (actually - very often) ka-radio freezes (stop playing & stop responding via the web-interface as well as via serial connection). I can reproduce this while switching to the station url that is not responding, such as:

1) DNS server is unable to resolve a given name
2) The radio host did not responding while trying to connecting a given stream socket
3) Probably in some other cases

The first idea how to fix that is to introduce timeouts for:
1) DNS resolver udp connection
2) Stream connection
3) Probably somewhere else

PS: Tested on the latest release 1.9R6.

Thread 85 (2020-04-16):

Very laggy with bitrate above 128

h1aji, 2020-04-16:
Its impossible to listen stations with high bitrate, Maximum is 96kbit.
I even added 23LCV1024 and still. Logs in serial doent show any errors.

No network issues. I have another box running raspberry pi which works fine.

Is there any chance to increase verbosity to get debug-level messages?

h1aji, 2020-04-16:
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

I have got Wemos Esp8266 board

h1aji, 2020-04-16:
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

h1aji, 2020-04-16:
Also:

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

Closed 2021-06-09.

Thread 86 (2020-05-22):

Update to SDK 3

h1aji, 2020-05-22:
Is there any chance to get the code update to work with SDK 3?
It looks like the easiest way is to port code from Ka-Radio32
There are lots of improvements and I am hoping to get better performance with new SDK

karawin, 2020-05-24:
No more free time for this.
I hope that someone will do it.

h1aji, 2023-05-08:
Hi JP,

I managed to port most of the code from Ka-Radio32 and the only piece I am struggling with is VS1053 driver.
Can you please help me to adjust this piece of code of yours:

```
bool VS1053_HW_init()
{
	gpio_num_t miso;
	gpio_num_t mosi;
	gpio_num_t sclk;
	gpio_num_t xcs;
	gpio_num_t xdcs;

	uint8_t spi_no; // the spi bus to use

	gpio_get_spi_bus(&spi_no,&miso,&mosi,&sclk);
	gpio_get_vs1053(&xcs,&rst,&xdcs,&dreq);

	// if xcs = 0 the vs1053 is not used
	if (xcs == GPIO_NONE)
	{
		vsVersion = 0;
		ESP_LOGE(TAG,"VS1053 not used");
		return false;
	}

	uint32_t freq = spi_cal_clock(APB_CLK_FREQ, 1600000, 128, NULL);
	ESP_LOGI(TAG,"VS1053 LFreq: %d",freq);

	spi_interface_t devcfg={
        .clock_speed_hz=freq,            //Clock out at x MHz
		.command_bits = 8,
		.address_bits = 8,
		.dummy_bits = 0,
		.duty_cycle_pos = 0,
		.cs_ena_pretrans = 0,
		.cs_ena_posttrans = 1,
		.flags = 0,
        .mode=0,                         //SPI mode
        .spics_io_num = xcs,             //XCS pin
        .queue_size=1,                   //We want to be able to queue x transactions at a time
        .pre_cb=NULL,  //Specify pre-transfer callback to handle D/C line
		.post_cb = NULL
	};

	//slow speed
	ESP_ERROR_CHECK(spi_bus_add_device(spi_no, &devcfg, &vsspi));

	//high speed
	freq = spi_cal_clock(APB_CLK_FREQ, 6100000, 128, NULL);

	ESP_LOGI(TAG,"VS1053 HFreq: %d",freq);
	devcfg.clock_speed_hz = freq;
	devcfg.spics_io_num= xdcs;               //XDCS pin
	devcfg.command_bits = 0;
	devcfg.address_bits = 0;
	ESP_ERROR_CHECK(spi_bus_add_device(spi_no, &devcfg, &hvsspi));

	//Initialize non-SPI GPIOs
	gpio_config_t gpio_conf;
	gpio_conf.mode = GPIO_MODE_OUTPUT;
	gpio_conf.pull_up_en = GPIO_PULLUP_DISABLE;
	gpio_conf.pull_down_en = GPIO_PULLDOWN_DISABLE;
	gpio_conf.intr_type = GPIO_INTR_DISABLE;
	gpio_conf.pin_bit_mask = ((uint64_t)(((uint64_t)1)<<rst));
	ESP_ERROR_CHECK(gpio_config(&gpio_conf));

	gpio_conf.mode = GPIO_MODE_INPUT;
	gpio_conf.pull_up_en = GPIO_PULLUP_DISABLE;
	gpio_conf.pull_down_en = GPIO_PULLDOWN_ENABLE;
	gpio_conf.intr_type = GPIO_INTR_DISABLE;
	gpio_conf.pin_bit_mask = ((uint64_t)(((uint64_t)1)<<dreq));
	ESP_ERROR_CHECK(gpio_config(&gpio_conf));

	//gpio_set_direction(dreq, GPIO_MODE_INPUT);
	//gpio_set_pull_mode(dreq, GPIO_PULLDOWN_ENABLE); //usefull for no vs1053 test
	return true;
}

```
According to https://docs.espressif.com/projects/esp8266-rtos-sdk/en/latest/api-reference/peripherals/spi.html

Thank you

karawin, 2023-05-09:
May be refer to https://github.com/karawin/Ka-Radio ?

h1aji, 2023-05-09:
It doesnt help much tbh. I managed to fix **VS1053_spi_init**

```
void VS1053_spi_init() {
	esp_err_t ret;

	if(!vsSPI) vsSPI=xSemaphoreCreateMutex();
	if(!hsSPI) hsSPI=xSemaphoreCreateMutex();;

    ESP_LOGI(TAG, "Init GPIO");
    // Set CS and DCS pins as output and high
	gpio_reset_pin(PIN_NUM_XCS);
	gpio_set_direction(PIN_NUM_XCS, GPIO_MODE_OUTPUT);
	gpio_set_level(PIN_NUM_XCS, 1);

	gpio_reset_pin(PIN_NUM_XDCS);
	gpio_set_direction(PIN_NUM_XDCS, GPIO_MODE_OUTPUT);
	gpio_set_level(PIN_NUM_XDCS, 1);

    // Set DREQ pin as input and low
	gpio_reset_pin(PIN_NUM_DREQ);
	gpio_set_direction(PIN_NUM_DREQ, GPIO_MODE_INPUT);
	gpio_set_level(PIN_NUM_XDCS, 0);

    ESP_LOGI(TAG, "Init HSPI");

	spi_config_t spi_config={
        .interface.val = SPI_DEFAULT_INTERFACE,
        .intr_enable.val = SPI_MASTER_DEFAULT_INTR_ENABLE,
		.mode = SPI_MASTER_MODE
	};

	ret=spi_init(KSPI, &spi_config);
	assert(ret==ESP_OK);
}
```
But VS1053_HW_init doesnt seem to be very understandable

h1aji, 2023-05-10:
I need your help adjusting this piece of code. Can you please advise how it can be modified for ESP8266?

```
    spi_interface_t interface_config = {
        /* SPI mode 3, CPOL = 1, CPHA = 1 */
        .cpol = 1,
        .cpha = 1,
        .bit_tx_order = 0,
        .bit_rx_order = 0,
        .byte_tx_order = 0,
        .byte_rx_order = 0,
        .mosi_en = 1,
        .miso_en = 1,
        .cs_en = 1,
    };

	//slow speed 2MHz
	ESP_ERROR_CHECK(spi_bus_add_device(spi_no, &interface_config));

	//high speed 10MHz
	freq = spi_cal_clock(APB_CLK_FREQ, 6100000, 128, NULL);
	ESP_LOGI(TAG,"VS1053 HFreq: %d",freq);
	interface_config.clock_speed_hz = freq;
	interface_config.spics_io_num = xdcs;               //XDCS pin
	interface_config.command_bits = 0;
	interface_config.address_bits = 0;
	interface_config.
	ESP_ERROR_CHECK(spi_bus_add_device(spi_no, &interface_config));

```

h1aji, 2023-05-12:
I managed to fix Init part. Now I need to migrate read and write

```
void VS1053_spi_write_char(uint8_t *cbyte, uint16_t len) {
	esp_err_t ret;
	spi_trans_t t;

	memset(&t, 0, sizeof(t));       // Zero out the transaction
	t.mosi = cbyte;
	t.bits.mosi = len * 8;
	//t.rxlength=0;
	while(gpio_get_level(PIN_NUM_DREQ) == 0) taskYIELD();
	spi_take_semaphore(sSPI);
	ret = spi_trans(HSPI_HOST, &t);    // Transmit!
	if (ret != ESP_OK) ESP_LOGE(TAG,"err: %d, VS1053_spi_write_char(len: %d)",ret,len);
	spi_give_semaphore(sSPI);
//	while(gpio_get_level(PIN_NUM_DREQ) == 0 );
}

void VS1053_WriteRegister(uint8_t addressbyte, uint8_t highbyte, uint8_t lowbyte) {
	spi_trans_t t;
	esp_err_t ret;

	if (vsVersion == 0) return;

	memset(&t, 0, sizeof(t));       //Zero out the transaction
	t.cmd = VS_WRITE_COMMAND;
	t.addr = addressbyte;
	t.mosi = highbyte;
	t.mosi = lowbyte;
	t.bits.mosi = 16;
	WaitDREQ();
	spi_take_semaphore();
	ret = spi_trans(HSPI_HOST, &t);   // Transmit!
	if (ret != ESP_OK) ESP_LOGE(TAG,"err: %d, VS1053_WriteRegister(%d,%d,%d)",ret,addressbyte,highbyte,lowbyte);
	spi_give_semaphore();
	WaitDREQ();
}

void VS1053_WriteRegister16(uint8_t addressbyte, uint16_t value) {
    spi_trans_t t;
	esp_err_t ret;

	if (vsVersion == 0) return;

	memset(&t, 0, sizeof(t));       //Zero out the transaction
	t.cmd = VS_WRITE_COMMAND;
	t.addr = addressbyte;
	t.mosi = (value>>8)&0xff;
	t.mosi = value&0xff;
	t.bits.mosi = 16;
	WaitDREQ();
	spi_take_semaphore();
	ret = spi_trans(HSPI_HOST, &t);  //Transmit!
	if (ret != ESP_OK) ESP_LOGE(TAG,"err: %d, VS1053_WriteRegister16(%d,%d)",ret,addressbyte,value);
	spi_give_semaphore();
	WaitDREQ();
}

uint16_t VS1053_ReadRegister(uint8_t addressbyte) {
	uint16_t result;
	spi_trans_t t;
	esp_err_t ret;

	if (vsVersion == 0) return 0;
	memset(&t, 0, sizeof(t));       //Zero out the transaction
	t.cmd = VS_READ_COMMAND;
	t.addr = addressbyte;
	t.bits.miso = 16;

	WaitDREQ();
	spi_take_semaphore();
	ret = spi_trans(HSPI_HOST, &t);  //Transmit!
	if (ret != ESP_OK) ESP_LOGE(TAG,"err: %d, VS1053_ReadRegister(%d), read: %d",ret,addressbyte,(uint32_t)*t.miso);
	result = (((t.mosi[0]&0xFF)<<8) | ((t.mosi[1])&0xFF));
//	ESP_LOGI(TAG,"VS1053_ReadRegister data: %d %d %d %d",t.rx_data[0],t.rx_data[1],t.rx_data[2],t.rx_data[3]);
	spi_give_semaphore();
	WaitDREQ();
	return result;
}
```
@karawin can you please have a look and point if there is anything wrong. thanks

h1aji, 2023-05-20:
The last piece that is left now is **SPIGetChar** and **SPIPutChar**
@karawin will you be able to review my code and let me know if needs correction? Thanks

```
uint8_t SPIGetChar() {
	while(READ_PERI_REG(SPI_CMD(HSPI))&SPI_USR);	//wait for SPI to be ready

	CLEAR_PERI_REG_MASK(SPI_USER(HSPI),SPI_FLASH_MODE|SPI_USR_MOSI);

	SET_PERI_REG_MASK(SPI_USER(HSPI),SPI_USR_MISO);

	WRITE_PERI_REG (SPI_USER1 (HSPI),(0&SPI_USR_MOSI_BITLEN)<<SPI_USR_MOSI_BITLEN_S| //Number of bits to send
			((8-1)&SPI_USR_MISO_BITLEN)<<SPI_USR_MISO_BITLEN_S|	//Number of bits to receive
			(23&SPI_USR_ADDR_BITLEN)<<SPI_USR_ADDR_BITLEN_S);	//Number of bits in address

	SET_PERI_REG_MASK(SPI_CMD(HSPI), SPI_USR);
	while(READ_PERI_REG(SPI_CMD(HSPI))&SPI_USR) ;

	if (READ_PERI_REG(SPI_USER(HSPI))&SPI_RD_BYTE_ORDER) {
			return READ_PERI_REG(SPI_W0(HSPI))>>24;	//Assuming data in is written to MSB. TBC
	} else {
			return READ_PERI_REG(SPI_W0(HSPI));
	}
}

void SPIPutChar(uint8_t data) {
	while(READ_PERI_REG(SPI_CMD(HSPI))&SPI_USR);	//wait for SPI to be ready

	CLEAR_PERI_REG_MASK(SPI_USER(HSPI),SPI_FLASH_MODE|SPI_USR_MISO);

    SET_PERI_REG_MASK(SPI_USER(HSPI),SPI_USR_MOSI);	//enable MOSI function in SPI module

	WRITE_PERI_REG(SPI_USER1(HSPI),(((8-1)&SPI_USR_MOSI_BITLEN)<<SPI_USR_MOSI_BITLEN_S)|   //len bits of data out
			((0&SPI_USR_MISO_BITLEN)<<SPI_USR_MISO_BITLEN_S)|       //no data in
			((23&SPI_USR_ADDR_BITLEN)<<SPI_USR_ADDR_BITLEN_S));     //address is 24 bits A0-A23

	if (READ_PERI_REG(SPI_USER(HSPI))&SPI_WR_BYTE_ORDER) {
			WRITE_PERI_REG(SPI_W0(HSPI),(uint32_t)data<<24);
	} else {
			WRITE_PERI_REG(SPI_W0(HSPI),(uint32_t)data);
	}
	SET_PERI_REG_MASK(SPI_CMD(HSPI),SPI_USR);
}
```

h1aji, 2023-05-28:
I managed to migrate the project to SDK 3.4 here - https://github.com/h1aji/Ka-Radio
But I am experiencing issues

> rst cause:4, boot mode:(3,6)

@VicVa  Any chance to have a look?

karawin, 2023-05-28:
Good job, but sorry, no free time.
It seems that your bin cannot start at all.

h1aji, 2023-05-28:
Thanks. this is why i am asking for assistance now.
Maybe @pilnikov ?

h1aji, 2023-06-02:
I am seeing this error

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

What am I missing @karawin ?

h1aji, 2023-10-15:
Hi @karawin this time I only need your help with partitions.csv
Can you tell me if this is correct configuration?

```
# Espressif ESP8266 Partition Table
# Name,   Type, SubType, Offset,   Size
nvs,      data, nvs,     0x9000,   0x4000
otadata,  data, ota,     0xd000,   0x2000
phy_init, data, phy,     0xf000,   0x1000
ota_0,    0,    ota_0,   0x10000,  0xF0000
ota_1,    0,    ota_1,   0x110000, 0xF0000
# Ka-Radio partitions
device,   0x40,      ,   ,        0x1000
stations, 0x41,      ,   ,        0x10000
device1,  0x42,      ,   ,        0x1000
hardware, data, nvs  ,   ,        0x3000
#                END =   0x400000
```

Because I see this error

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

Thread 89 (2020-12-09):

Unable to see the SSID network

ChristopheBaeyens, 2020-12-09:
I'm searching for days now in the hope of getting this to work.
But after loading the BIN files I discovered no new network.
Checked the web tried some other combinations but had no luck.
Started from this site https://www.instructables.com/Wifi-Webradio-With-ESP8266-and-VS1053/
But finally used the loader as mentioned in the readme here but still no progress.
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

Just, checked my esp8266 with a simple led test via the intranet and it is still working.

ChristopheBaeyens, 2020-12-09:
I just rebooted due to a windows update, and this I did not expect, I can see the SSID now, but for the moment still no sound...

ChristopheBaeyens, 2020-12-09:
Unable to connect to the site anymore. Flashed the board / Erased it / Redownloaded all bin's, The SSID is comming up but unable to connect to the site http://192.164.4.1/ anymore....
For the moment also removed all cables. But nothing I do seems to get the site back up...
Does someone has any sugestions?

pilnikov, 2020-12-10:
>  unable to connect to the site http://192.16**4**.4.1/ anymore....
> Does someone has any sugestions?

You must connect to 192.16**8**.4.1

ChristopheBaeyens, 2020-12-10:
Ok must have been tired yesterday, thx for your feedback.
Had again some problems with my one of my laptops USB connections, strange updating the board works with 1 usb port but to get the board working I had to switch to another USB port.
I finally got the project working, but still have a buffering problem.
I also do not understand why A0 has to be connected to the ground (i did not do it for the moment)

ChristopheBaeyens, 2020-12-10:
Did some search, and I suppose I need extra ram for buffering. Would it be possible to get some references of external ramboards, if possible without the need of soldering?

pilnikov, 2020-12-11:
i know chip only, no ramboards

ChristopheBaeyens, 2020-12-11:
Hi Alex,

How did you solve the buffer problem, or did you only use those radio’s without this type of problem?

Christophe.

Van: Alex Pilnikov <notifications@github.com>
Verzonden: vrijdag 11 december 2020 9:50
Aan: karawin/Ka-Radio <Ka-Radio@noreply.github.com>
CC: ChristopheBaeyens <christophe.baeyens@telenet.be>; Author <author@noreply.github.com>
Onderwerp: Re: [karawin/Ka-Radio] Unable to see the SSID network (#89)

i know chip only, no ramboards

—
You are receiving this because you authored the thread.
Reply to this email directly, view it on GitHub <https://github.com/karawin/Ka-Radio/issues/89#issuecomment-743061264> , or unsubscribe <https://github.com/notifications/unsubscribe-auth/ASB3FCTIIYJOZA6YWILTKRDSUHMNFANCNFSM4UTSG3ZA> .  <https://github.com/notifications/beacon/ASB3FCQB4OLLMEHM5MFDA3DSUHMNFA5CNFSM4UTSG3ZKYY3PNVWWK3TUL52HS4DFVREXG43VMVBW63LNMVXHJKTDN5WW2ZLOORPWSZGOFRFDOEA.gif>

pilnikov, 2020-12-11:
i use esp32, but i have some problem even with 4mb ext ram

pilnikov, 2020-12-11:
W (18910) webclient: Stream found!!!! Start player
##CLI.PLAYING#
##CLI.META#: Nina - The reason is you
I (22660) vs1053: Wait while Buffer fill 0%
I (22710) vs1053: Wait while Buffer fill 0%
I (22760) vs1053: Wait while Buffer fill 0%
I (22810) vs1053: Wait while Buffer fill 0%
I (22860) vs1053: Wait while Buffer fill 0%
I (22910) vs1053: Wait while Buffer fill 0%
I (22960) vs1053: Wait while Buffer fill 0%
I (23010) vs1053: Wait while Buffer fill 0%
I (23060) vs1053: Wait while Buffer fill 0%
I (23110) vs1053: Wait while Buffer fill 0%
I (23160) vs1053: Wait while Buffer fill 1%
I (23210) vs1053: Wait while Buffer fill 1%
I (23260) vs1053: Wait while Buffer fill 1%
I (23310) vs1053: Wait while Buffer fill 1%
I (23360) vs1053: Wait while Buffer fill 1%
I (23410) vs1053: Wait while Buffer fill 1%
I (23460) vs1053: Wait while Buffer fill 1%
I (23510) vs1053: Wait while Buffer fill 1%
I (23560) vs1053: Wait while Buffer fill 2%
I (23610) vs1053: Wait while Buffer fill 2%
I (23660) vs1053: Wait while Buffer fill 2%
I (23710) vs1053: Wait while Buffer fill 2%
I (23760) vs1053: Wait while Buffer fill 2%
I (23810) vs1053: Wait while Buffer fill 2%
I (23860) vs1053: Wait while Buffer fill 2%
I (23910) vs1053: Wait while Buffer fill 2%
I (23960) vs1053: Wait while Buffer fill 2%
I (24010) vs1053: Wait while Buffer fill 2%
I (24060) vs1053: Wait while Buffer fill 2%
I (24110) vs1053: Wait while Buffer fill 2%
I (24160) vs1053: Wait while Buffer fill 3%
I (24210) vs1053: Wait while Buffer fill 3%
I (24260) vs1053: Wait while Buffer fill 3%
I (24310) vs1053: Wait while Buffer fill 3%
I (24360) vs1053: Wait while Buffer fill 3%
I (24410) vs1053: Wait while Buffer fill 3%
I (24460) vs1053: Wait while Buffer fill 3%
I (24510) vs1053: Wait while Buffer fill 3%
I (24560) vs1053: Wait while Buffer fill 3%
I (24610) vs1053: Wait while Buffer fill 4%
I (24660) vs1053: Wait while Buffer fill 4%
I (24710) vs1053: Wait while Buffer fill 4%
I (24760) vs1053: Wait while Buffer fill 4%
I (24810) vs1053: Wait while Buffer fill 4%
I (24860) vs1053: Wait while Buffer fill 4%
I (24910) vs1053: Wait while Buffer fill 4%
I (24960) vs1053: Wait while Buffer fill 4%
I (25010) vs1053: Wait while Buffer fill 5%
I (25080) vs1053: Wait while Buffer fill 4%
I (25130) vs1053: Wait while Buffer fill 4%
I (25180) vs1053: Wait while Buffer fill 5%
I (25310) vs1053: Wait while Buffer fill 4%
I (25360) vs1053: Wait while Buffer fill 4%
I (25410) vs1053: Wait while Buffer fill 5%
I (25540) vs1053: Wait while Buffer fill 4%
I (25590) vs1053: Wait while Buffer fill 4%
I (25640) vs1053: Wait while Buffer fill 4%
I (25690) vs1053: Wait while Buffer fill 4%
I (25740) vs1053: Wait while Buffer fill 4%
I (25790) vs1053: Wait while Buffer fill 5%
I (25950) vs1053: Wait while Buffer fill 4%
I (26000) vs1053: Wait while Buffer fill 5%
I (39430) audio_player: Buffer fill 9%, 102867 // 1048576 bytes
I (60290) audio_player: Buffer fill 9%, 102738 // 1048576 bytes
I (81100) audio_player: Buffer fill 9%, 104253 // 1048576 bytes
I (102370) audio_player: Buffer fill 9%, 98733 // 1048576 bytes
I (123200) audio_player: Buffer fill 9%, 98588 // 1048576 bytes
I (143450) audio_player: Buffer fill 10%, 106303 // 1048576 bytes
I (164350) audio_player: Buffer fill 10%, 106158 // 1048576 bytes
I (185420) audio_player: Buffer fill 9%, 102941 // 1048576 bytes

my log right now

ChristopheBaeyens, 2020-12-11:
Ok, in that case I will close the case this evening.

Thx.

By the way do you know why A0 should be grounded?

Van: Alex Pilnikov <notifications@github.com>
Verzonden: vrijdag 11 december 2020 9:57
Aan: karawin/Ka-Radio <Ka-Radio@noreply.github.com>
CC: ChristopheBaeyens <christophe.baeyens@telenet.be>; Author <author@noreply.github.com>
Onderwerp: Re: [karawin/Ka-Radio] Unable to see the SSID network (#89)

i use esp32, but i have some problem even with 4mb ext ram

—
You are receiving this because you authored the thread.
Reply to this email directly, view it on GitHub <https://github.com/karawin/Ka-Radio/issues/89#issuecomment-743064381> , or unsubscribe <https://github.com/notifications/unsubscribe-auth/ASB3FCXZCF4GY7RMTQNV6ZTSUHNGPANCNFSM4UTSG3ZA> .  <https://github.com/notifications/beacon/ASB3FCSSETOWQLOHWF36OFDSUHNGPA5CNFSM4UTSG3ZKYY3PNVWWK3TUL52HS4DFVREXG43VMVBW63LNMVXHJKTDN5WW2ZLOORPWSZGOFRFEGPI.gif>

pilnikov, 2020-12-11:
to avoid interference that can be recognized by the esp as pressing the buttons of an analog keyboard

pilnikov, 2020-12-11:
Can I use the Arduino ide monitor for this?
Yes of course

ChristopheBaeyens, 2020-12-11:
OK, something I will do this evening then, thx again 😊

Van: Alex Pilnikov <notifications@github.com>
Verzonden: vrijdag 11 december 2020 10:03
Aan: karawin/Ka-Radio <Ka-Radio@noreply.github.com>
CC: ChristopheBaeyens <christophe.baeyens@telenet.be>; Author <author@noreply.github.com>
Onderwerp: Re: [karawin/Ka-Radio] Unable to see the SSID network (#89)

Can I use the Arduino ide monitor for this?
Yes of course

—
You are receiving this because you authored the thread.
Reply to this email directly, view it on GitHub <https://github.com/karawin/Ka-Radio/issues/89#issuecomment-743067316> , or unsubscribe <https://github.com/notifications/unsubscribe-auth/ASB3FCWXGCTDOWN5LQSXNJLSUHN5PANCNFSM4UTSG3ZA> .  <https://github.com/notifications/beacon/ASB3FCWQ5LK5A2JBUJ6IYETSUHN5PA5CNFSM4UTSG3ZKYY3PNVWWK3TUL52HS4DFVREXG43VMVBW63LNMVXHJKTDN5WW2ZLOORPWSZGOFRFE5NA.gif>

ChristopheBaeyens, 2020-12-11:
For the moment I will wait until I have decided to go for another board or extra ram.

Closed 2020-12-11.

Thread 90 (2021-02-02):

Password protected WifiKaradio AP or a configurable delay and/or tries count to connect a stored network

andykarpov, 2021-02-02:
Is it possible to add WEP / WPA encryption for the WifiKaradio network or add a configurable delay to start the internal WifiKaradio network after a configurable amount of tries ?

Case that scaring me a lot:
1) My KaRadio starts much faster that the router (after power failure / outage, for example)
2) In this case KaRadio is unable to connect the stored wifi network and starts it's own WifiKaradio network (widely open)
3) Anybody can connect that WifiKaradio and see a stored password in the settings

karawin, 2021-02-05:
You are right.
The password must not be clear in the message.
I will study it.

andykarpov, 2021-02-14:
Sweet, i guess this issue is already fixed by v2.1 R0 and can be closed

karawin, 2021-02-15:
Yes, it is.
I close. Thanks for reporting the problem.

Closed 2021-02-15.

Thread 92 (2021-03-05):

Is it possible to change the address of the time server?

cyzzar, 2021-03-05:
Please add the ability to change the address for the NTP server. The default one is not always available.

karawin, 2021-03-06:
No. But why? no problem with the default one here since 3 years now.
Some ponctual ntp fails on logs but no more than 1 per day.

cyzzar, 2021-03-09:
The fact is that I assembled an add-on for a 20x4 display and as additional information I display the current time on it.

I poll the time with the sys.date command twice a minute. But quite often the request returns an error.
There are two options to fix this. 1 - add a clock module to the arduino. 2 - change the address of the NTP server to the local one.

The second option is preferable.
It is a pity if this is impossible to implement.

Thread 95 (2021-03-20):

Flashing

Zinci, 2021-03-20:
Could you please edit the line on the main page:
user1.4096.new.4.bin at 0x1000
to
user1.4096.new.4.bin at 0x10000

It took me quite a few sleepless nights to work this out and maybe it will help someone like me (a total newbie).
I received by mistake couple of ESP8266 and I did not want to throw them away. I guess I will have a kitchen Internet Radio
BTW the ESP32 works perfectly. :+1:
I am in the process of putting them inside the iPod docking station, hopefully. :fearful:

Thanks for the code!

molotovec, 2021-03-22:
Have no idea how did you manage it working. I've tried a couple of boards with params from main page and have no luck - board isn't available in the wifi list and no blinking after flash  button[used ESP download tool v3.6.4]
boot_v1.6.bin at 0x0000,
user1.4096.new.4.bin at 0x10000, **(0x01000 - from instructables)**
user2.4096.new.4.bin at 0X81000,
esp_init_data_default.bin at 0x3FC000
and blank.bin at 0x3fe000

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

Zinci, 2021-03-22:
After your post I was worried that my success was a fluke, so I successfully flashed **another** ESP8266 with the corrected address (0X10000). I even found a screenshot from flash-tool here:
https://github.com/karawin/Ka-Radio/blob/master/ESP8266-Firmware/documents/karadiov365.jpg
I downloaded the "fresh" binaries into **_bin_** directory though.

Zinci, 2021-03-29:
Just remembered something. Did you reset manually the board after flashing? As far as I know the flash tool does not reset the board after upload.

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

Zinci, 2021-03-30:
Thanks, I just tried it and it does work. I do not know what happened when I tried previously.
Apart from the device name in Wireless Network Watcher which is a bit weird and comes up as ESP_294C60.home but I can access it from WifiKaRadio.home.

Closed 2021-03-30.

Thread 96 (2021-03-24):

karadioU8STM32 - redefinition of 'U8GLIB_SSD1306_128X64 u8g'

Zinci, 2021-03-24:
After I successfully flashed couple of ESP8266, I continued to try and connect the I2C 0.9" 128X64 OLED display. This calls for a STM32 board. I do have these boards but never even opened them. Anyway after "having fun" loading bootloader through FTD1232 so I can actually connect to the STM32 through USB and upload the Arduino sketch I stumbled on another hurdle of installing the libraries. The explanation on where to get the libraries is found in u8glibConf.h file of each LCD configuration and is documented very clear.
The real trouble began when Arduino compiler came up with an error:

`error: redefinition of 'U8GLIB_SSD1306_128X64 u8g'`

I was able to get rid of this error by editing the **u8glibConf.h** file and commenting the lines 47, 48 and 49 where U8GLIB_SSD1306_128X64 u8g is defined (it is already defined in **karadioU8STM32.ino** file). After this, apart from few warnings about labels not used the sketch compiled and uploaded into STM32.
It is working now, albeit still on a breadboard. I am writing this for anyone trying this particular configuration and to document my work-flow.
I do not know if this is the right and correct approach, but it worked for me.

karawin, 2021-03-30:
Yes a last minute change. I will see the problem soon.
Thanks

Thread 102 (2022-12-14):

Help Needed - AP not showing up

aravindnc, 2022-12-14:
Connected everything as per instruction.
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

Flashed,
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

Now the esp has blinking blue light.

Getting serial data like this,
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

Still no AP is not showing up in Wifi Networks.

Any idea what I'm doing wrong

aravindnc, 2022-12-15:
Worked when I changed flasher to Node MCU Flasher.

Closed 2022-12-15.

Thread 103 (2022-12-15):

What is the wattage of 1K resistors connected for external switches.

aravindnc, 2022-12-15:
What is the wattage of 1K and 16K resistors connected for external switches.
Thanks.

karawin, 2023-03-01:
The smallest you want

Thread 104 (2023-04-22):

Strange ADC behavior

haldemir55, 2023-04-22:
Hi Karawin
I have a such strange problem with ADC of the Esp8266:
I finished all project steps and i got audio. When i connect add-on switches after 30 or 40 seconds the voltage on adc input drop suddenly to  ~0.4.and waveing between 0.1 to 0.4. And it accept this value to do what it must to do. Increase volume and chage the station. When i reset it do same things.
Have you any suggestion.
And can you change for me the order of the switches such as:
STOP - > START
START -> NEXT
VOL+ -> PREV
PREV -> STOP
VOL- -> VOL+
NXT -> VOL-
Thanx

Thread 105 (2023-05-05):

BOM with Ebay URLS not working

mats-nk, 2023-05-05:
The Bill Of Material with links to Ebay fails....

A better solution would be if you just list what components and perhaps pictures.

Thread 106 (2023-10-24):

Changing pins for VS1053  connection

h1aji, 2023-10-24:
Hi @karawin
I would like to modify wires (to release pins 4, 5 and 15) as per below

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

and have modified vs1053.c
```
ICACHE_FLASH_ATTR void VS1053_HW_init() {
        printf(PSTR("\nVS1053 Init") );

        PIN_FUNC_SELECT(PERIPHS_IO_MUX_SD_DATA3_U, 3); //GPIO10
        PIN_FUNC_SELECT(PERIPHS_IO_MUX_SD_DATA2_U, 3); //GPIO9

        PIN_DIR_OUTPUT |= (1<<RST_PIN)|(1<<CS_PIN);
        gpio16_output_conf();
        PIN_DIR_INPUT |= (1<<DREQ_PIN);
        PIN_OUT_SET |= (1<<RST_PIN)|(1<<CS_PIN);
        gpio16_output_set(1);

        spi_init(HSPI);
        spi_clock(HSPI, 4, 10); //2MHz
        PIN_FUNC_SELECT(PERIPHS_IO_MUX_GPIO0_U, 0); //GPIO0 is set as CS pin (Chip Select / Slave Select)
}

ICACHE_FLASH_ATTR void SDI_ChipSelect(uint8_t State){
        if(State) gpio16_output_set(0);
        else gpio16_output_set(1);
}
```
All compiles ok but there is no sound coming.
I tried it with this [Arduino module](https://github.com/baldram/ESP_VS1053_Library) and it works fine.

Would you be able to point what is wrong?

karawin, 2023-10-25:
The pin 16 is used for the external ram. May be a conflict.
You must see the log on the uart for indications and error messages.

h1aji, 2023-10-25:
thats not a problem, I set SPIRAM CS pin to 15
```
void extramInit() {
	char test[17]   = {"FFFFFFFF"};
	char testram[17]= {"01234567"};

	gpio15_output_conf();
	spi_clock(HSPI, 4, 10); //2MHz

        PIN_FUNC_SELECT(PERIPHS_IO_MUX_MTDO_U, 3); //GPIO15 is HSPI CS pin (Chip Select / Slave Select)

	bool externram = false;
	extramWrite(strlen(test), 0, testram);
	extramRead(strlen(test), 0, test);
        if (memcmp(test,testram,16) == 0) externram = true;
        //printf(PSTR("\n=> extraram state: %d 0x%x %s\n"),externram,test[0],test );
        if (externram) {
		printf(PSTR("\nExternal RAM detected%c"),0x0d);
	} else {
		printf(PSTR("\nExternal RAM not detected%c"),0x0d);
	}
}
```
