karawin/Ka-Radio/Hardware/karaWin_bb.pdf

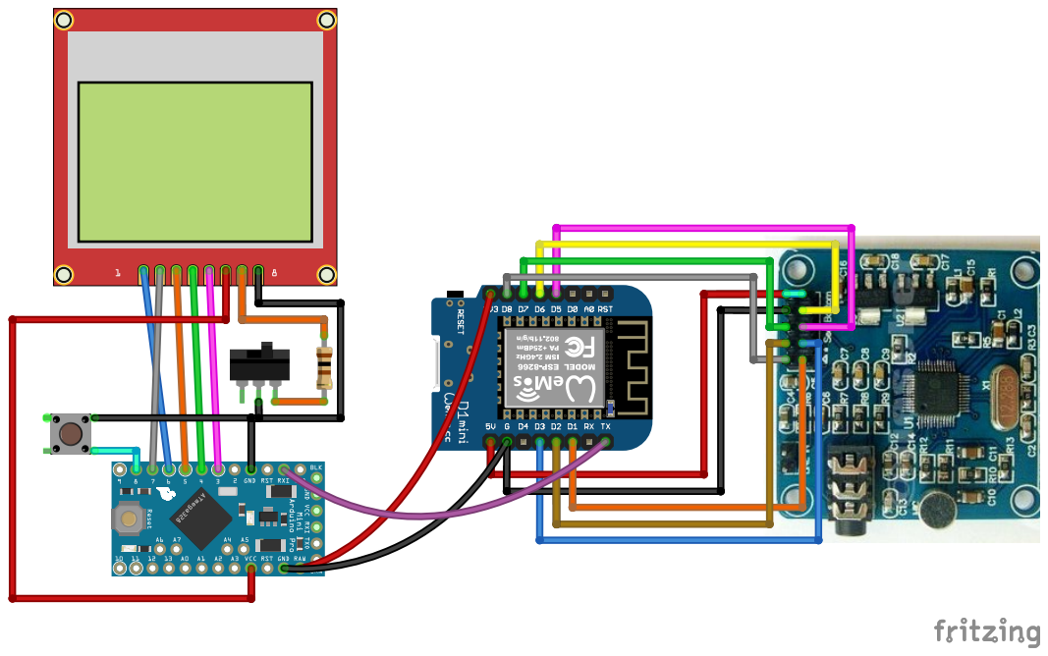
[picture p4: page 1]
