karawin/Ka-Radio/Hardware/controles.pdf

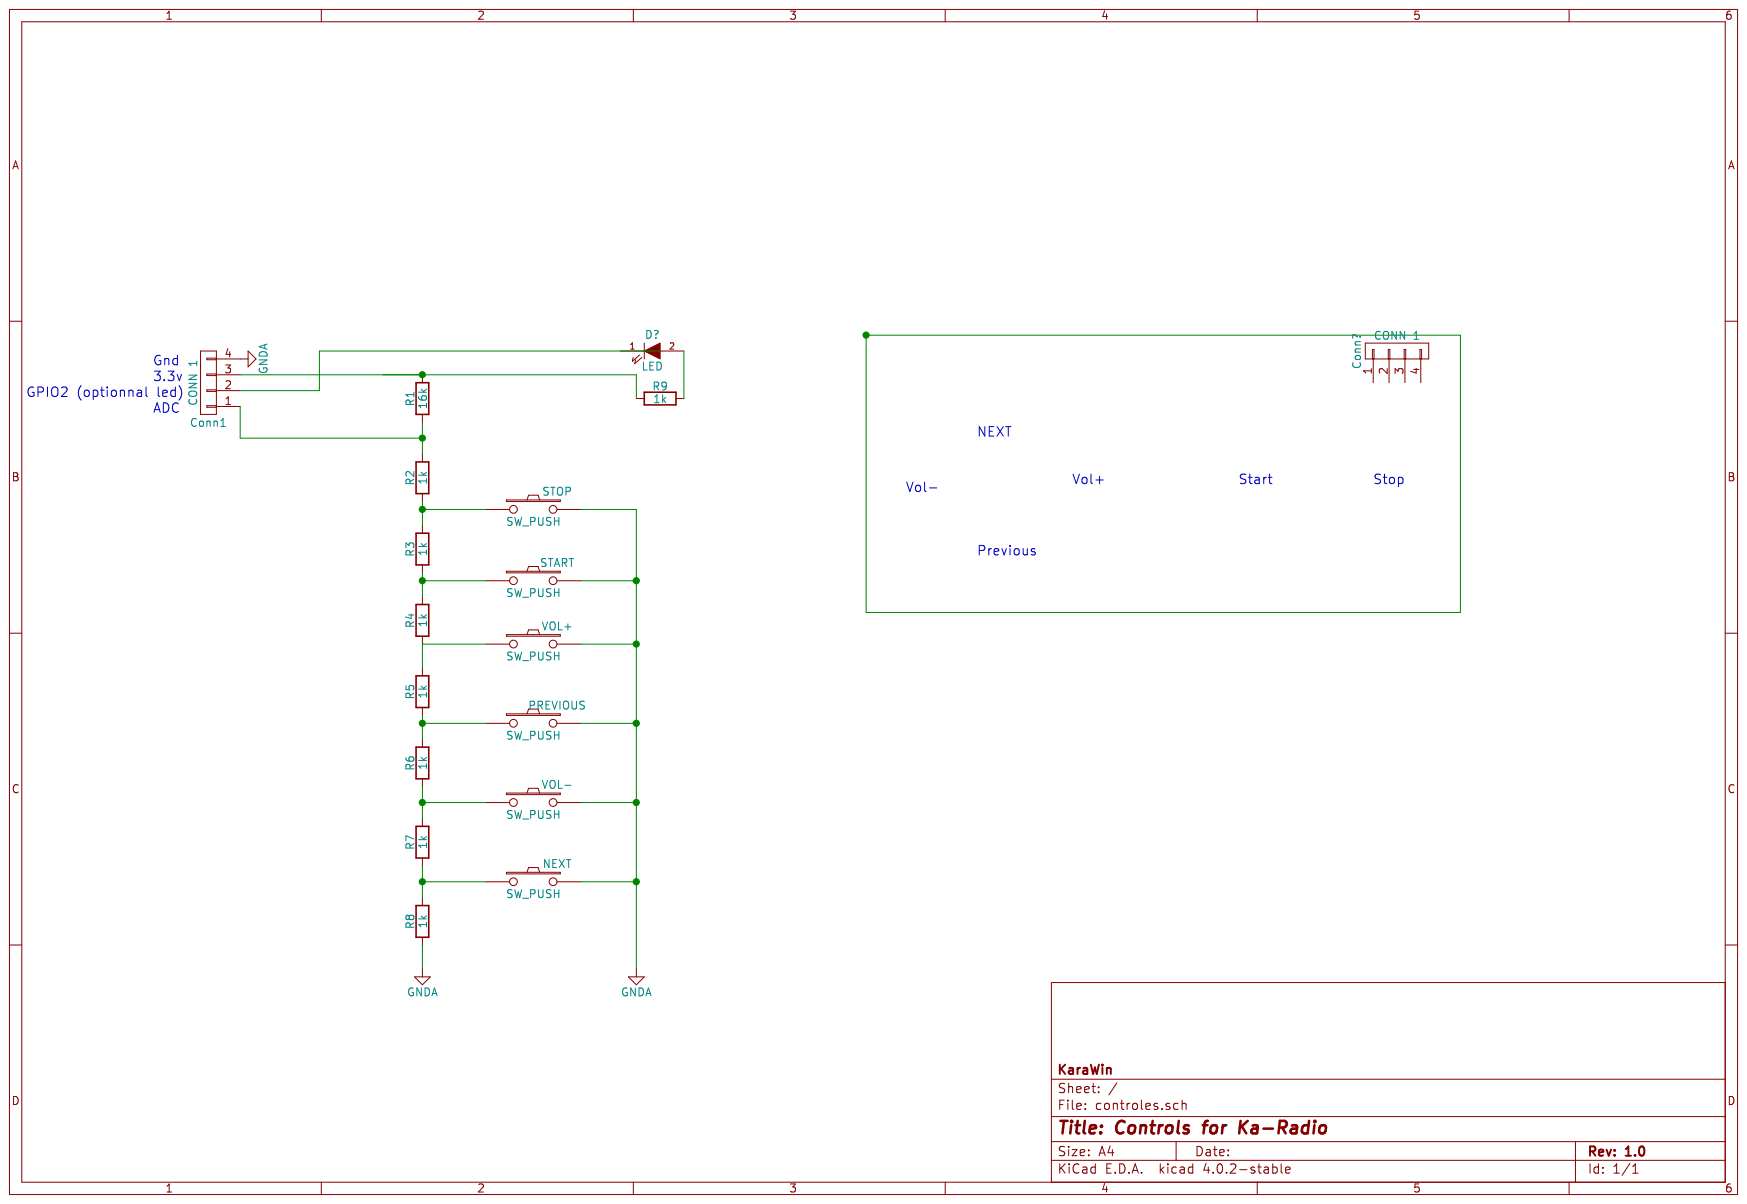
[picture p5: page 1]
