karawin/Ka-Radio/Hardware/webradio.pdf

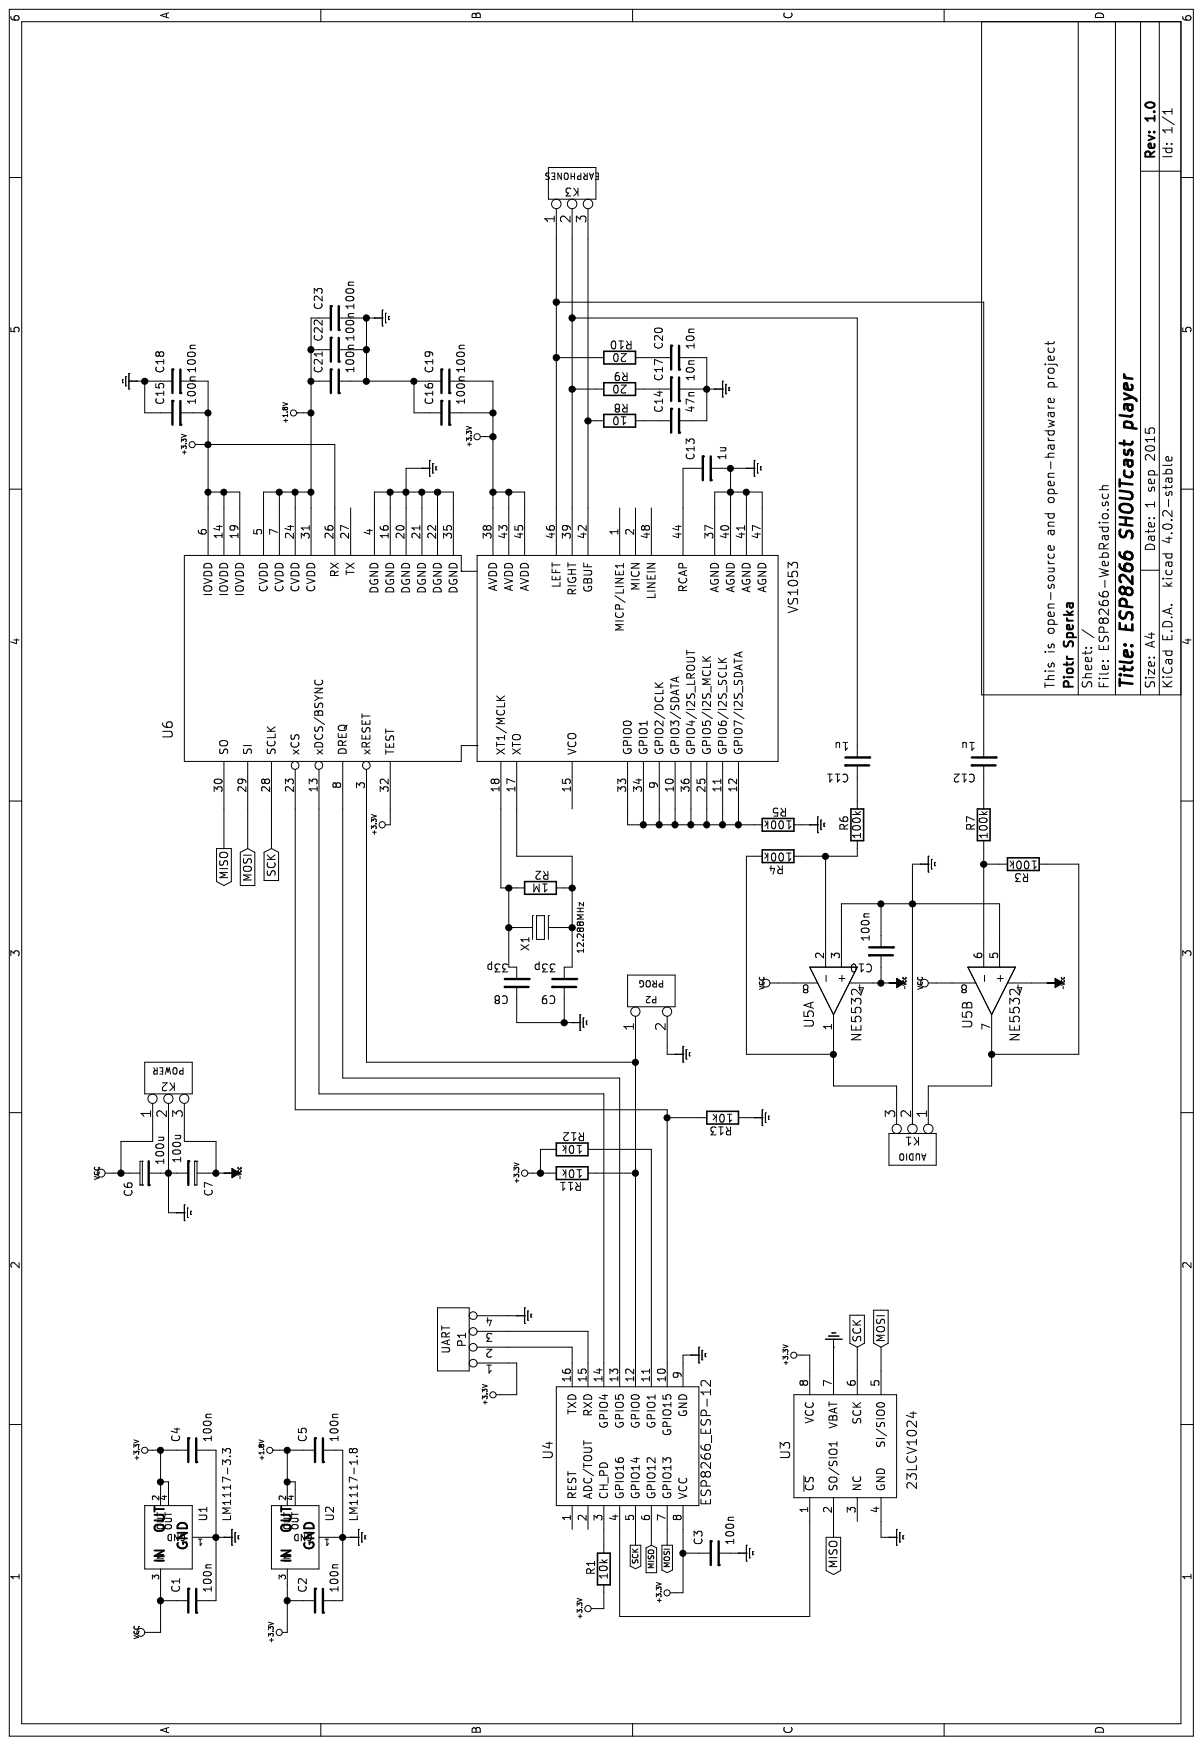
[picture p6: page 1]
