karawin/Ka-Radio/Hardware/Christopheleneuf/esp12v21.brd

## EAGLE design Hardware/Christopheleneuf/esp12v21.brd (2017-01-24)

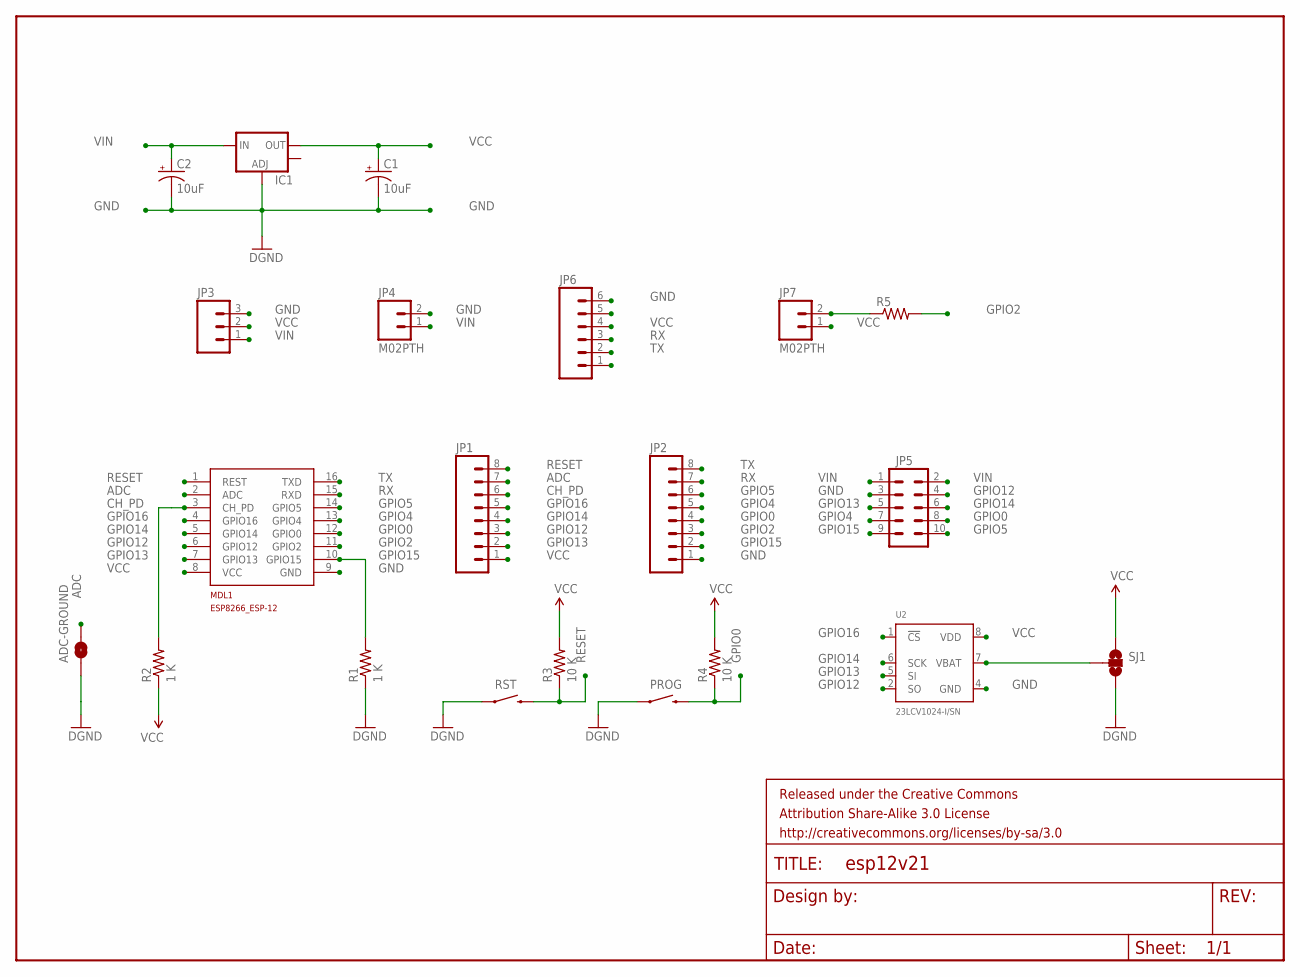
[picture p10: schematic esp12v21.sch]

Parts:
ADC-GROUND: SOLDERJUMPERNO; SJ_2S-NO
C1, C2: 10uF; EIA3216
FRAME1: FRAME-LETTER; CREATIVE_COMMONS
IC1: V_REG_LM1117SOT223; SOT223
JP1, JP2: M081X08; 1X08
JP3: M03PTH; 1X03
JP4, JP7: M02PTH; 1X02
JP5: M05X2NO_SILK; 2X5_NOSILK
JP6: M06LOCK; 1X06_LOCK
MDL1: ESP8266-12GPIO04/05_CORRECTED; ESP8266-ESP12
PROG: SWITCH-MOMENTARY-2-SMD-1101NE; TACTILE-SWITCH-1101NE
R1, R2: 1 K; 0805
R3, R4: 10 K; 0805
R5: RESISTOR0805-RES; 0805
RST: SWITCH-MOMENTARY-2-SMD-1101NE; TACTILE-SWITCH-1101NE
SJ1: SOLDERJUMPER_2WAYS; SJ_3
U2: 23LCV1024-I/SN; SO8

Connections:
ADC: ADC-GROUND.2, JP1.7, MDL1.2 (ADC)
CH_PD: JP1.6, MDL1.3 (CH_PD), R2.2
GND: ADC-GROUND.1, C1.C (-), C2.C (-), IC1.1 (ADJ), JP2.1, JP3.3, JP4.2, JP5.3, JP6.6, MDL1.9 (GND), PROG.P$1 (1), R1.1, RST.P$1 (1), SJ1.3, U2.4 (GND)
GPIO0: JP2.4, JP5.8, MDL1.12 (GPIO0), PROG.P$2 (2), R4.1
GPIO2: JP2.3, MDL1.11 (GPIO2), R5.2
GPIO4: JP2.5, JP5.7, MDL1.13 (GPIO4)
GPIO5: JP2.6, JP5.10, MDL1.14 (GPIO5)
GPIO12: JP1.3, JP5.4, MDL1.6 (GPIO12), U2.2 (SO)
GPIO13: JP1.2, JP5.5, MDL1.7 (GPIO13), U2.5 (SI)
GPIO14: JP1.4, JP5.6, MDL1.5 (GPIO14), U2.6 (SCK)
GPIO15: JP2.2, JP5.9, MDL1.10 (GPIO15), R1.2
GPIO16: JP1.5, MDL1.4 (GPIO16), U2.1 (!CS)
unnamed: SJ1.2, U2.7 (VBAT)
unnamed: JP7.2, R5.1
RESET: JP1.8, MDL1.1 (REST), R3.1, RST.P$2 (2)
RX: JP2.7, JP6.3, MDL1.15 (RXD)
TX: JP2.8, JP6.2, MDL1.16 (TXD)
VCC: C1.A (+), IC1.2 (OUT), JP1.1, JP3.2, JP6.4, JP7.1, MDL1.8 (VCC), R2.1, R3.2, R4.2, SJ1.1, U2.8 (VDD)
VIN: C2.A (+), IC1.3 (IN), JP3.1, JP4.1, JP5.1, JP5.2

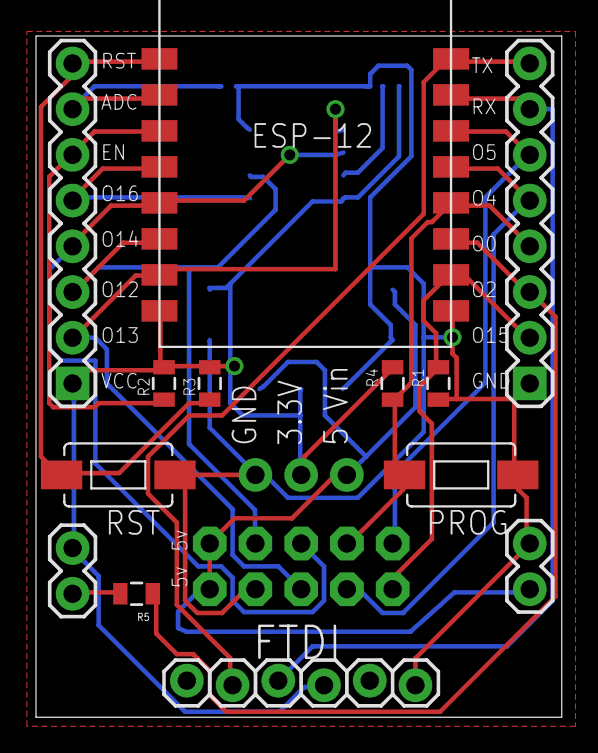
[picture p11: board esp12v21.brd from above]

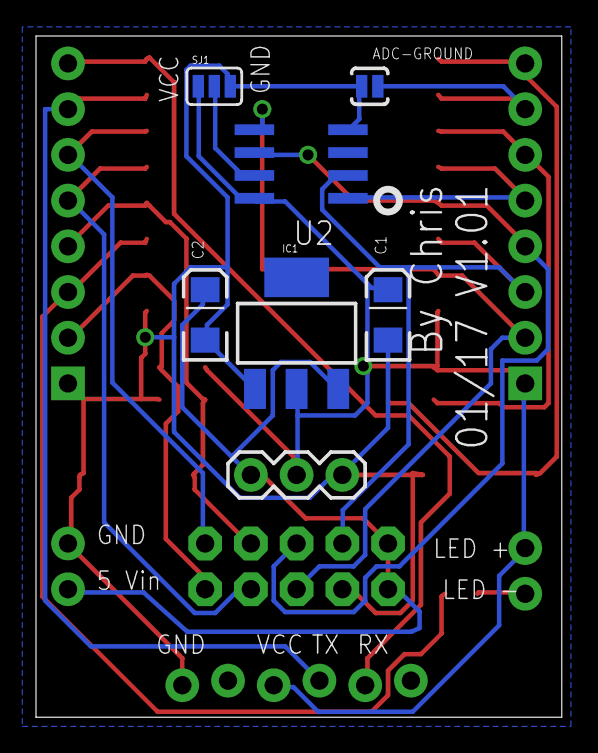
[picture p12: board esp12v21.brd from below]

Board: 2 copper layers, 29.2 x 37.8 mm, 22 parts (7 on the bottom side), 19 nets.
