karawin/Ka-Radio/ESP8266-Firmware/app/user/ota.c

/*
 * ESPRSSIF MIT License
 *
 * Copyright (c) 2015 <ESPRESSIF SYSTEMS (SHANGHAI) PTE LTD>
 *
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
 */
/*
 * Copyright 2016 jp Cocatrix (http://www.karawin.fr)
*/

#include "esp_common.h"
#include "esp_system.h"
#include "upgrade.h"
#include "math.h"
#include "freertos/FreeRTOS.h"
#include "freertos/task.h"

#include "lwip/sockets.h"
#include "lwip/dns.h"
#include "lwip/netdb.h"
#include "interface.h"

//#define pheadbuffer "Connection: keep-alive\r\n\
//Cache-Control: no-cache\r\n\
//User-Agent: Mozilla/5.0 (Windows NT 5.1) AppleWebKit/537.36 (KHTML, like Gecko) Chrome/30.0.1599.101 Safari/537.36 \r\n\
//Accept: */*\r\n\
//Accept-Encoding: gzip,deflate,sdch\r\n\
//\r\n"

#define pheadbuffer "Connection: keep-alive\r\nCache-Control: no-cache\r\nUser-Agent: Karadio 1.5 \r\nAccept: */*\r\nAccept-Encoding: gzip,deflate,sdch\r\n\r\n"

#define pheadbuffer1 "Connection: close\r\n\
Accept: */*\r\n\
Accept-Encoding: gzip,deflate,sdch\r\n\
Cache-Control: no-cache\r\n\
\r\n"

const char strupd[] ICACHE_RODATA_ATTR STORE_ATTR  = {\
"GET /user%d.4096.%s.4.bin HTTP/1.0\r\nHost: karadio.karawin.fr:80\r\n\
Connection: keep-alive\r\nCache-Control: no-cache\r\nUser-Agent: Karadio 1.5 \r\n\
Accept: */*\r\nAccept-Encoding: gzip,deflate,sdch\r\n\r\n"};

extern void wsUpgrade(const char* str,int count,int total);

/******************************************************************************
 * FunctionName : user_esp_upgrade_rsp
 * Description  : upgrade check call back function
 * Parameters   : none
 * Returns      : none
*******************************************************************************/
void user_esp_upgrade_rsp(void *arg)
{
	struct upgrade_server_info *server = (struct upgrade_server_info *)arg;
	if(server->upgrade_flag == true){
//		kprintf(PSTR("FW upgrade success.%c"),0x0d);
		wsUpgrade("FW OK Refresh the page" , 0,100);
		system_upgrade_reboot();
	} else {
//		kprintf(PSTR("-ERR: FW upgrade failed.%c"),0x0d);
		wsUpgrade("FW upgrade failed." , 0,100);
	}
    free(server->url);
    server->url = NULL;
	
    free(server);
    server = NULL;	
}

/******************************************************************************
 * FunctionName : update_firmware
 * Description  : config remote server param and init bin info
 * Parameters   : none
 * Returns      : none
*******************************************************************************/
void update_firmware(char* fname)
{
    kprintf(PSTR("update  firmware \r%c"),0x0d);
    uint8 current_id = system_upgrade_userbin_check();
//    kprintf(PSTR("current id %d\n"), current_id);
	clientDisconnect(PSTR("Update"));
//	char* client_url = "karadio.karawin.fr";

//#define bin_url  "user%d.4096.%s.4.bin"
	
    struct upgrade_server_info *server = NULL;
    server = (struct upgrade_server_info *)malloc(sizeof(struct upgrade_server_info));
    memset(server, 0, sizeof(struct upgrade_server_info));
    server->check_cb = user_esp_upgrade_rsp;   //set upgrade check call back function
    server->check_times = 360000;
	server->upgrade_flag = true;
	
    if (server->url == NULL) {
        server->url = (uint8 *)malloc(512);
    }

    flash_size_map f_size = system_get_flash_size_map();
    kprintf(PSTR("flash size  %d\n"),f_size);
    if (current_id == 0) {
		 current_id = 2;
	} else current_id = 1;

	char* fmt = malloc(strlen(strupd)+16);
	flashRead(fmt,(int)strupd,strlen(strupd));
	fmt[strlen(strupd)] = 0;
	sprintf(server->url,fmt ,current_id,fname);
	free(fmt);

//    sprintf(server->url, "GET /user%d.4096.%s.4.bin HTTP/1.0\r\nHost: %s:80\r\n"pheadbuffer"",current_id,fname, client_url);
//printf("http_req : %s\n", server->url);
	
	struct hostent *serv ;
	serv =(struct hostent*)gethostbyname("karadio.karawin.fr");
    server->sockaddrin.sin_family = AF_INET;
    server->sockaddrin.sin_port   = htons(80);
    server->sockaddrin.sin_addr.s_addr = inet_addr(inet_ntoa(*(struct in_addr*)(serv-> h_addr_list[0]))); // remote server ip
//printf("distant ip: %x   ADDR:%s\n",server->sockaddrin.sin_addr.s_addr,inet_ntoa(*(struct in_addr*)(serv-> h_addr_list[0])));

    if (system_upgrade_start(server) == false) {
        kprintf(PSTR("upgrade error%c"),0x0d);
    }
	

}
