karawin/Ka-Radio/ESP8266-Firmware/app/user/buffer.c

/*
 * Copyright 2016 Piotr Sperka (http://www.piotrsperka.info)
*/

#include "buffer.h"
#include "esp_common.h"
#include "extram.h"
/*
#ifndef USE_EXTERNAL_SRAM
	uint8_t buffer[BUFFER_SIZE];
#endif
*/
bool externram;
uint32_t BUFFER_SIZE;
uint8_t *buffer;
uint32_t wptr = 0;
uint32_t rptr = 0;
uint8_t bempty = 1;

ICACHE_FLASH_ATTR void initBuffer()
{
	 if (externram== false)
	 {
//		 BUFFER_SIZE = 12960;
//		 BUFFER_SIZE = 14080;
//		 BUFFER_SIZE = 16000;
		 BUFFER_SIZE = 20000;
		 buffer = malloc(BUFFER_SIZE);
	 } else{
		 BUFFER_SIZE = BIGMEMORY;
	 }	 	 
}
ICACHE_FLASH_ATTR uint32_t getBufferFree() {
	if(wptr > rptr ) return BUFFER_SIZE - wptr + rptr;
	else if(wptr < rptr) return rptr - wptr;
	else if(bempty) return BUFFER_SIZE; else return 0;
}
ICACHE_FLASH_ATTR bool getBufferEmpty() {
	return bempty;
}

ICACHE_FLASH_ATTR uint32_t getBufferFilled() {
	return BUFFER_SIZE - getBufferFree();
}

ICACHE_FLASH_ATTR uint32_t bufferWrite(uint8_t *data, uint32_t size) {
	if (externram==false){
		uint32_t i;
		for(i=0; i<size; i++) {
			if(getBufferFree() == 0) { return i;}
			buffer[wptr++] = data[i];
			if(bempty) bempty = 0;
			if(wptr == BUFFER_SIZE) wptr = 0;
		}
	}
	else{
		if(getBufferFree() < size) size = getBufferFree();
		extramWrite(size, wptr, data);
		wptr += size;
		if(bempty) bempty = 0;
		if(wptr >= BUFFER_SIZE) wptr -= BUFFER_SIZE;
	}
	return size;
}

ICACHE_FLASH_ATTR uint32_t bufferRead(uint8_t *data, uint32_t size) {
	uint32_t i = 0;
	uint32_t bf = getBufferFilled();
	if(size > bf) size = bf;

	if (externram==false){
		for (i = 0; i < size; i++) {
			if(bf == 0) { return i;}
			data[i] = buffer[rptr++];
			if(rptr == BUFFER_SIZE) rptr = 0;
			if(rptr == wptr) bempty = 1;
		}
	} else{
		extramRead(size, rptr, data);
		rptr += size;
		if(rptr >= BUFFER_SIZE) rptr -= BUFFER_SIZE;
		if(rptr == wptr) bempty = 1;
	}
	return size;
}

ICACHE_FLASH_ATTR void bufferReset() {
	wptr = 0;
	rptr = 0;
	bempty = 1;
}
