karawin/Ka-Radio/ESP8266-Firmware/app/user/flash.c

#include "flash.h"
#include "esp_common.h"
#include "spi.h"


ICACHE_FLASH_ATTR uint32_t flashRead( void *to, uint32_t fromaddr, uint32_t size )
{
  uint32_t ret;
  fromaddr -= INTERNAL_FLASH_START_ADDRESS;
//  int r;
 // printf("flasRead from %x, size: %d  TO:%x\n",fromaddr,size,to);
  WRITE_PERI_REG(0x60000914, 0x73);
  spi_take_semaphore();
  spi_clock(HSPI, 4, 10); //2MHz
  ret = spi_flash_read(fromaddr, (uint32 *)to, size);
  spi_give_semaphore();
  return ret;
}

ICACHE_FLASH_ATTR uint32_t flashWrite( void *data, uint32_t fromaddr, uint32_t size )
{
  uint32_t ret;
  fromaddr -= INTERNAL_FLASH_START_ADDRESS;
//   printf("flasWrite from %x, size: %d  Data: %x\n",fromaddr,size,data);
//  int r;
  WRITE_PERI_REG(0x60000914, 0x73);
  spi_take_semaphore();
  spi_clock(HSPI, 4, 10); //2MHz
  ret = spi_flash_write(fromaddr, (uint32 *)data, size);
  spi_give_semaphore();
  return ret;
}
