karawin/Ka-Radio/ESP8266-Firmware/app/include/webserver.h

/*
 * Copyright 2016 karawin (http://www.karawin.fr)
*/
#pragma once

#ifndef __WEBSERVER_H__
#define __WEBSERVER_H__


#include "webclient.h"
#include "vs1053.h"

#include "lwip/opt.h"
#include "lwip/arch.h"
#include "lwip/api.h"
#include "esp_common.h"
#include "esp_softap.h"
#include "esp_timer.h"
#include "esp_wifi.h"
#include "lwip/sockets.h"
#include "lwip/dns.h"
#include "lwip/netdb.h"
#include "flash.h"
#include "eeprom.h"
#include "interface.h"
#include "websocket.h"

extern os_timer_t sleepTimer;
extern uint32_t sleepDelay;
extern os_timer_t wakeTimer;
extern uint32_t wakeDelay;
extern xSemaphoreHandle semclient;
extern xSemaphoreHandle semfile;

//void serverTask(void *pvParams);
extern int8_t clientOvol ;
extern uint8_t clientIvol ;
void sleepCallback(void *pArg);
void wakeCallback(void *pArg);
void startSleep(uint32_t delay);
void stopSleep();
void stopWake();
void serverclientTask(void *pvParams);

#endif
