karawin/Ka-Radio/ESP8266-Firmware/app/user/gpio16.c

#include "espressif/esp_common.h"
#include "freertos/portmacro.h"

#include "gpio16.h"
extern volatile uint32_t PIN_OUT;
extern volatile uint32_t PIN_OUT_SET;
extern volatile uint32_t PIN_OUT_CLEAR;
 
extern volatile uint32_t PIN_DIR;
extern volatile uint32_t PIN_DIR_OUTPUT;
extern volatile uint32_t PIN_DIR_INPUT;
//#define PERIPHS_IO_MUX_GPIO2_U          (PERIPHS_IO_MUX + 0x38)
//#define FUNC_GPIO2                          0

void ICACHE_FLASH_ATTR
gpio2_output_conf(void)
{
	PIN_DIR_OUTPUT = (1<<GPIO2);
	PIN_OUT_SET = (1<<GPIO2);
}

void ICACHE_FLASH_ATTR
gpio2_output_set(uint8 value)
{
	if(value == 0) PIN_OUT_CLEAR = (1<<GPIO2);
	else PIN_OUT_SET = (1<<GPIO2);
}


void ICACHE_FLASH_ATTR
gpio16_output_conf(void)
{
    WRITE_PERI_REG(PAD_XPD_DCDC_CONF,
                   (READ_PERI_REG(PAD_XPD_DCDC_CONF) & 0xffffffbc) | (uint32)0x1); 	// mux configuration for XPD_DCDC to output rtc_gpio0

    WRITE_PERI_REG(RTC_GPIO_CONF,
                   (READ_PERI_REG(RTC_GPIO_CONF) & (uint32)0xfffffffe) | (uint32)0x0);	//mux configuration for out enable

    WRITE_PERI_REG(RTC_GPIO_ENABLE,
                   (READ_PERI_REG(RTC_GPIO_ENABLE) & (uint32)0xfffffffe) | (uint32)0x1);	//out enable
}

void ICACHE_FLASH_ATTR
gpio16_output_set(uint8 value)
{
    WRITE_PERI_REG(RTC_GPIO_OUT,
                   (READ_PERI_REG(RTC_GPIO_OUT) & (uint32)0xfffffffe) | (uint32)(value & 1));
}

void ICACHE_FLASH_ATTR
gpio16_input_conf(void)
{
    WRITE_PERI_REG(PAD_XPD_DCDC_CONF,
                   (READ_PERI_REG(PAD_XPD_DCDC_CONF) & 0xffffffbc) | (uint32)0x1); 	// mux configuration for XPD_DCDC and rtc_gpio0 connection

    WRITE_PERI_REG(RTC_GPIO_CONF,
                   (READ_PERI_REG(RTC_GPIO_CONF) & (uint32)0xfffffffe) | (uint32)0x0);	//mux configuration for out enable

    WRITE_PERI_REG(RTC_GPIO_ENABLE,
                   READ_PERI_REG(RTC_GPIO_ENABLE) & (uint32)0xfffffffe);	//out disable
}

uint8 ICACHE_FLASH_ATTR
gpio16_input_get(void)
{
    return (uint8)(READ_PERI_REG(RTC_GPIO_IN_DATA) & 1);
}
