karawin/Ka-Radio/(commit log)

2016-06-15 New repository
    [ESP8266-WebRadio.kicad_pcb, ESP8266-WebRadio.sch, UI-Bridge.sch, controles.kicad_pcb, controles.sch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]
2016-06-16 Correction for NodeMcu with adc dividor and grounded adc.
    [interface.c, interface.h, user_main.c]
2016-06-16 removed some traces
2016-06-26 Release 1.0.5
    [controles.sch]
2016-07-29 Increase spi clock for external ram
2016-07-29 Increas spi clock for external ram
    restore spi speed before flash read/write
2016-08-01 receive buffer too big
    [extram.c, user_main.c, vs1053.c, webclient.c, webclient.h]
2016-09-14 A little bug in metadata
    [webclient.c]
2016-09-17 A little crash removed...
    [webclient.c]
2016-10-10 1.0.10 Led blink too quickly for my taste.
2016-11-09 karadioU8glib.zip added: lcd software
    karadioU8glib.zip is an arduino sketch to build a lcd display for
    karadio.
    Some many other little improvments in karadion.
    No new features added.
2016-11-26 controle.pdf updated
    [controles.sch]
2016-12-03 lcd & remote arduino software
2017-01-24 lcd update
    [esp12v21.brd, esp12v21.sch]
2017-01-25 1.1.5, AP mode corrected
    [eeprom.h, interface.c, opt.h, user_main.c, vs1053.c, vs1053.h, vs1053b-patches.c, webclient.c]
2017-01-31 Wire external ram
2017-02-10 1.1.7+
    volume offset correction
    [webclient.c, webserver.c]
2017-02-12 Fixed the bug with reduced size of payload buffer. TCP package data size checked with tcpdump. It is 1024 bytes now. Faster loading of webpage.
    [webserver.c]
2017-04-14 Priority uart
2017-05-02 Added some missing include and cleaned the Makefile
    [eeprom.c, interface.c, spi.h, vs1053.c]
2017-06-30 Release 1.3.3
    Bugs removed
    [eeprom.h, interface.c, user_main.c, webserver.c]
2017-08-12 offset volume negative was wrong
    [servers.c, user_main.c, webclient.c, webserver.c]
2017-08-25 R 1.6 json correction
    [webclient.c]
2017-08-27 Ajust uart speed not working. Corrected.
    [eeprom.c, eeprom.h, interface.h, servers.c, telnet.c, user_main.c, webclient.c, webserver.c]
2017-09-05 little change on uart
2017-12-27 1.6.3: Correction for stations with the char & in path.
    [interface.h]
2018-09-09 Version 1.7 official
    <ul>
    <li>mDns added </li>
    <li>web commands next and prev added</li>
    <li>uart or teknet command sys.host added.</li>
    </ul>
2019-02-11 Corrected: Wifi infos, upgrade
    [ota.c, webserver.c]
2019-02-25 Revert "ESP8266 RTOS SDK 2.0.0"
    [buffer.c, lwipopts.h, opt.h]
2019-04-15 1.9 R2
    AP mode was not working
    [interface.h, lwipopts.h, opt.h, servers.c, user_main.c]
2019-06-30 Release 1.9 R5
    json correction
    [interface.h, webserver.c]
2019-08-01 Problem on AP mode due to the lwip layer. Resolved
    Seems resolved
    [lwipopts.h, telnet.c, user_main.c, webserver.c]
2021-01-09 Release 9
    VS1053b detection improved.
    On some old vs1003/vs1053 boards, loading the vs1053 patch result in no
    sound because the vs1053 board resetted to the midi mode. Corrected now.
    Setting panel correction.
    [interface.h, user_main.c, vs1053.c, vs1053b-patches.c, webclient.c]
2021-02-14 Release V2.1 R0 new
    <ul id="ordered">
    <li>Security: the ssid passwords are no longer sent
    on each "Setting" display, but only when changed.</li>
    <li>Bug fixed:
    in parse playlist. Possible memory leak. Thanks to HmarikBel</li>
    <li>Bug fixed: Special char in station name was incorrectly sent.</li>
    <li>Some minors improvements.</li>
    [webclient.c]
2021-03-12 Release 2.1 R1
    Some mistakes on wifi init
    [interface.h]
