karawin/Ka-Radio/(notices)

Notices in the files:
ESP8266-Firmware/include/lwip/lwip/opt.h:
Copyright (c) 2001-2004 Swedish Institute of Computer Science.
All rights reserved.
parts and their libraries:
SparkFun-Connectors: Licensing: CC v3.0 Share-Alike You are welcome to use this library for commercial purposes.
SparkFun-Aesthetics: Released under the Creative Commons Attribution Share-Alike 3.0 License
SparkFun-Aesthetics: http://creativecommons.org/licenses/by-sa/3.0
